ydf0809/ydf/board/evidence/report/fig3-2-mechanical.jpeg

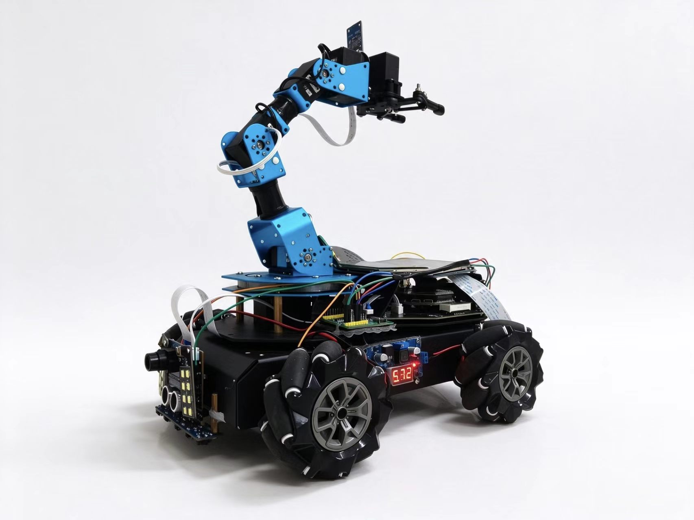
board/evidence/report/fig3-2-mechanical.jpeg
