ydf0809/ydf/board/evidence/report/fig3-9-locked.jpeg

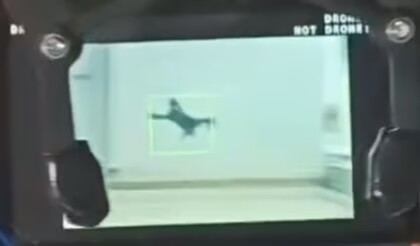
board/evidence/report/fig3-9-locked.jpeg
