ydf0809/ydf/report/owner_inputs.md

# 所有者输入与后续扩展

作者提供的最终设计报告 PDF 已按原文件纳入仓库。以下材料用于完善后续发布与扩展验证：

- 初级组/高级组信息。
- 板卡及外设的实物型号、版本、原理图、实际接线、供电和语音模块配置。
- 实板输入、预期输出、测试条件、原始日志或视频；正式报告已有部分结论，仓库按 board/measurements.md 记录可复核证据。
- 正式数据集、类别与授权、划分和去重、独立测试集、训练配置和实验指标。
- 模型参数和第三方源码的来源及可公开依据。
- 同工具、器件、约束和输入下的优化前后报告，以及吞吐、时延、功耗等原始测量。
- 发布已完成；后续更新继续使用普通本地提交和 GitHub 推送。

已有 25 条可见协作节选、纠错案例和工作流。后续可继续补充早期记录和更多应用场景。
