ydf0809/ydf/report/collaboration/README.md

# 大模型协作原文节选

来源索引和逐条定位见 [excerpts.json](excerpts.json)。仅收录用户提示词与模型对外答复；本地路径以方括号标签脱敏，历史链接在可读版禁用；JSON 保留脱敏后的消息文本。这里是原文节选，案例解释另见 [协作报告](../ai_collaboration.md)。历史参数和状态只适用于当时版本，不能替代当前验证。

## excerpt_01 · training

时间：2026-11-01T17:36:17.649Z；角色：user；会话：`01a1982d-0909-70f0-977c-afd3503c679e`；原记录第 11 行；模型：`gpt-6.1-sol`。

> 根据"[workspace]\new weight"反推出训练代码和权重转换脚本放到"[workspace]\jiaoben"

## excerpt_02 · training

时间：2026-11-01T17:37:33.516Z；角色：assistant；会话：`01a1982d-0909-70f0-977c-afd3503c679e`；原记录第 59 行；模型：`gpt-6.1-sol`。

> **可以重建兼容的训练代码和权重转换脚本，但无法仅凭权重恢复原始数据集、训练超参数和原始浮点权重。**

## excerpt_03 · training

时间：2026-11-01T17:40:01.609Z；角色：user；会话：`01a1982d-0909-70f0-977c-afd3503c679e`；原记录第 68 行；模型：`gpt-6.1-sol`。

> 我的工程是根据new weight建造的，为什么会出现不一致

## excerpt_04 · training

时间：2026-11-01T17:41:20.055Z；角色：assistant；会话：`01a1982d-0909-70f0-977c-afd3503c679e`；原记录第 107 行；模型：`gpt-6.1-sol`。

> **原因已经查清：`new weight` 文件夹内部的 COE 和 MEM 并不是同一套权重，当前工程使用的是其中 MEM 对应的数值。** 我上一条没有把这个关系说明清楚。

## excerpt_05 · weight_sync

时间：2026-11-02T15:48:31.650Z；角色：user；会话：`01a1982d-0909-70f0-977c-afd3503c679e`；原记录第 874 行；模型：`gpt-6.1-sol`。

> 如果对最终工程没有影响的话将最终工程目录里的 COE改为old weight

## excerpt_06 · weight_sync

时间：2026-11-02T16:03:49.712Z；角色：assistant；会话：`01a1982d-0909-70f0-977c-afd3503c679e`；原记录第 962 行；模型：`gpt-6.1-sol`。

> - 将最终工程中的 4 份 COE 替换为 `old weight/F` 对应文件。
> - 4 份 COE 与对应 MEM 已逐项一致。
> - 4 个权重 ROM 与 MEM 仍保持一致。
> - XPR、内嵌 ROM、MEM 和现有 bitstream 的 SHA-256 均未变化。
> - 已确认 XPR 和构建脚本没有登记或读取 COE，因此本次修改不会改变当前 FPGA 运行结果。

## excerpt_07 · locking

时间：2026-11-02T04:27:40.810Z；角色：user；会话：`01a197f0-307c-7972-940f-15799aa7c31f`；原记录第 338 行；模型：`gpt-6.1-sol`。

> 锁定时容易被亮色吸引走是为什么

## excerpt_08 · locking

时间：2026-11-02T04:30:03.903Z；角色：assistant；会话：`01a197f0-307c-7972-940f-15799aa7c31f`；原记录第 376 行；模型：`gpt-6.1-sol`。

> **主要原因是：当前定位器会选择“与背景反差最强的区域”，它没有约束必须继续跟随最初锁定的那个目标。** 我已用当前 RTL 的合成图样复现了亮块把框吸走的现象。

## excerpt_09 · locking

时间：2026-11-02T04:36:17.834Z；角色：user；会话：`01a197f0-307c-7972-940f-15799aa7c31f`；原记录第 415 行；模型：`gpt-6.1-sol`。

> 实施，另外我发现防空模式下再次说出防空模式，机械臂虽然会回到初始位但马上就会回到上次防空模式最后锁定的物体，我希望每次防空模式都重新搜寻

## excerpt_10 · locking

时间：2026-11-02T05:04:02.823Z；角色：assistant；会话：`01a197f0-307c-7972-940f-15799aa7c31f`；原记录第 757 行；模型：`gpt-6.1-sol`。

> - **定位抗干扰**：加入目标亮暗参考和连续 3 帧位置确认，优先选择原目标附近的候选；实际框移动限制为每帧每轴最多 16 个显示像素。
> - **每次防空都重新搜索**：包括已经处于防空模式时再次说“防空”。现在会清空旧锁定、定位参考、分类历史、未完成推理和待发送旧框，重新搜索并完成新的分类确认。
> - feifei 保锁、脱锁规则继续保留；下层工程未修改。

## excerpt_11 · corner_parameter

时间：2026-10-31T10:51:09.225Z；角色：user；会话：`01a19170-fd57-7fc3-93d8-67bca6108f44`；原记录第 333 行；模型：`gpt-6.1-sol`。

> 直行一秒再转，告诉我怎么改，我自己改，

## excerpt_12 · corner_parameter

时间：2026-10-31T10:51:36.473Z；角色：assistant；会话：`01a19170-fd57-7fc3-93d8-67bca6108f44`；原记录第 338 行；模型：`gpt-6.1-sol`。

> 只改这里即可，`corner_turn.v` 的默认值会被这里覆盖。保存后重新综合、实现、生成 bit 并烧录，修改才会在车上生效。

## excerpt_13 · corner_parameter

时间：2026-10-31T10:58:29.774Z；角色：user；会话：`01a19170-fd57-7fc3-93d8-67bca6108f44`；原记录第 345 行；模型：`gpt-6.1-sol`。

> 我需要xpr工程中的比特流为最新的，目前检测转弯后没有直行操作

## excerpt_14 · corner_parameter

时间：2026-10-31T11:00:12.365Z；角色：assistant；会话：`01a19170-fd57-7fc3-93d8-67bca6108f44`；原记录第 359 行；模型：`gpt-6.1-sol`。

> 已确认 1 秒设置未生效：`corner_turn.v` 默认值虽改为 1000，但 `xunbi_core.v` 仍传入 300，覆盖了它。我会修改实际实例，验证四轮先直行 1 秒，再重建原 XPR 的 bit。

## excerpt_15 · publication

时间：2026-11-01T18:11:00.904Z；角色：user；会话：`01a1984a-ec58-7082-8c9d-0bee8f996569`；原记录第 92 行；模型：`gpt-6.1-sol`。

> 别看审核稿重新做

## excerpt_16 · publication

时间：2026-11-01T18:18:33.674Z；角色：user；会话：`01a1984a-ec58-7082-8c9d-0bee8f996569`；原记录第 129 行；模型：`gpt-6.1-sol`。

> 1a 2a 3b

## excerpt_17 · publication

时间：2026-11-01T19:11:15.131Z；角色：assistant；会话：`01a1984a-ec58-7082-8c9d-0bee8f996569`；原记录第 755 行；模型：`gpt-6.1-sol`。

> 好的，暂时只保留本地提交 **`745a0bd`**，不推送 GitHub，也不再尝试登录。
>
> 工程位于 github_release/ydf（历史链接已脱敏），源码、脚本和验证记录均已保存。后续你明确说“继续发布”时再恢复。

## excerpt_18 · publication

时间：2026-11-02T14:52:53.686Z；角色：user；会话：`01a1984a-ec58-7082-8c9d-0bee8f996569`；原记录第 789 行；模型：`gpt-6.1-terra`。

> 以"[final_source]"中的两个文件为最终文件，"[workspace]\jiaoben"为scnn训练工程
> skill建议写踩坑清单，或者你有认为可取的也可以写
> 大模型协作记录：提示词、模型回答、自我纠错轨迹、智能体工作流设计如有
> 给出计划在修改

## excerpt_19 · publication

时间：2026-11-03T05:49:21.933Z；角色：user；会话：`01a1984a-ec58-7082-8c9d-0bee8f996569`；原记录第 1006 行；模型：`gpt-6.1-sol`。

> 根据"[selected_source]"中的内容继续完成任务

## excerpt_20 · implementation_details

时间：2026-11-03T05:49:17.423Z；角色：user；会话：`01a19ff4-64b1-7d61-911a-852116266ccf`；原记录第 11 行；模型：`gpt-6.1-terra`。

> 详细的各功能逻辑和所用的知识、实现方式，

## excerpt_21 · implementation_details

时间：2026-11-03T06:14:21.996Z；角色：assistant；会话：`01a19ff4-64b1-7d61-911a-852116266ccf`；原记录第 249 行；模型：`gpt-6.1-sol`。

> 包含 16 部分的功能逻辑、知识点、实现方式和验证范围，并附系统流程图。55 个源码及记录链接均采用相对路径，已检查有效。

## excerpt_22 · engineering_first

时间：2026-10-31T08:18:27.492Z；角色：user；会话：`01a17d82-b89c-7902-a480-8c6c298c51d9`；原记录第 3972 行；模型：`gpt-6.1-sol`。

> 以工程落地为优先，减少复核的程度，继续修改

## excerpt_23 · engineering_first

时间：2026-10-31T10:03:26.022Z；角色：assistant；会话：`01a17d82-b89c-7902-a480-8c6c298c51d9`；原记录第 4674 行；模型：`gpt-6.1-sol`。

> 本次下层板循迹修改已完成，原 XPR 对应的新 bit 已生成。五灯全亮/全灭：首个无效控制周期先停车；直角弯：转弯侧最外探头先离线、再检测到黑线，满足最小转弯时间后交回 PID。两项仿真均 PASS，综合、实现、bit 生成成功；尚未进行实车烧录测试。

## excerpt_24 · defense_control

时间：2026-11-02T03:08:30.959Z；角色：user；会话：`01a19a3a-db6a-7242-91ec-e8b890c20cb7`；原记录第 4 行；模型：未在来源 turn_context 中记录。

> 读取[workspace]/realfinal_min_102404与[workspace]/merged_cam_lcd_voice_scnn是我的主要工程。防空模式中再次说出防空模式时，机械臂需要回到初始位置；回位速度参考追随模式的自动复位；锁定无人机时，舵机6达到100和850阈值且目标接近左右边框30像素时，麦轮原地转向2秒。

## excerpt_25 · defense_control

时间：2026-11-02T03:08:30.989Z；角色：assistant；会话：`01a19a3a-db6a-7242-91ec-e8b890c20cb7`；原记录第 762 行；模型：未在来源 turn_context 中记录。

> 两块 bit 已重出，并且确认上层综合用的就是改后的代码：在实现后的网表里查 center_i 引脚数量为 0，说明旧的 center_i 端口已经不存在。
