ydf0809/ydf/report/publish_status.md

# 发布状态

2026-11-03：所有者已授权发布。仓库已推送到 `origin/main`；后续报告和文档更新继续使用普通本地提交与快进推送。

2026-11-04：最终双板工程完成同步与重建验证，作者最终设计报告 PDF 已按原文件纳入。报告正文中的阶段数据与仓库最终重建证据分别登记。

本地仓库使用原 main 分支并保留历史，沿用已有 MIT 与署名。当前内容以 xiegithub 最终源包为依据。

工程发布版可供审核和复现；板级原始数据、数据集评测和同条件优化对比通过后续材料持续扩展。
