ydf0809/ydf/third_party_notices.md

# 来源与许可范围

所有者于2026-11-02确认沿用本仓库已有MIT及署名；LICENSE保持远端原文。该确认针对本次指定工程的公开整理，不从其他草稿推导授权，也不删除原工程中的供应商权利声明。

| 内容 | 处理 |
| --- | --- |
| 两套主工程的RTL、约束、测试台、权重与参考帧 | 直接从指定主工程复制，来源和哈希见report/source_manifest.json；生产输入不改写 |
| XPR | 保留工具版权注释，调整交付路径、移除可选旧增量检查点引用 |
| AMD IP配置及生成内容 | 保留原有声明；由用户安装的Vivado生成运行文件，MIT不替代供应商适用条款 |
| Vivado、仿真器和运行时 | 不随仓库分发安装程序、许可证文件或凭据 |
| 新增脚本和文档 | 按根MIT协议提供 |
| SCNN训练与数据来源 | 已纳入配套训练与导出工具；数据集、训练过程和参数依据按data/model_card.md记录 |

若后续发现额外第三方许可要求，应保留相应文件及归属并补充适用路径。
