ydf0809/ydf/board/evidence/report/fig3-10-voice-module.jpeg

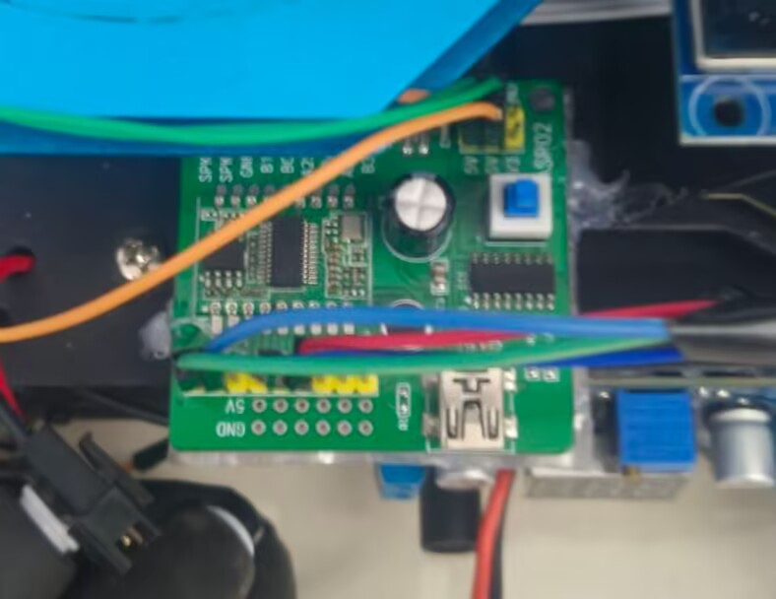
board/evidence/report/fig3-10-voice-module.jpeg
