ydf0809/ydf/board/pinmap.csv

board | port | package_pin | iostandard | source | line
upper | sys_clk | N18 | LVCMOS33 | projects/merged_cam_lcd_voice_scnn/constraints/top.xdc | 1
upper | sys_rst_n | W9 | LVCMOS33 | projects/merged_cam_lcd_voice_scnn/constraints/top.xdc | 2
upper | led | R19 | LVCMOS33 | projects/merged_cam_lcd_voice_scnn/constraints/top.xdc | 3
upper | cam_pclk | V15 | LVCMOS33 | projects/merged_cam_lcd_voice_scnn/constraints/top.xdc | 4
upper | cam_rst_n | V12 | LVCMOS33 | projects/merged_cam_lcd_voice_scnn/constraints/top.xdc | 5
upper | cam_pwdn | W16 | LVCMOS33 | projects/merged_cam_lcd_voice_scnn/constraints/top.xdc | 6
upper | cam_data[0] | W13 | LVCMOS33 | projects/merged_cam_lcd_voice_scnn/constraints/top.xdc | 7
upper | cam_data[1] | U13 | LVCMOS33 | projects/merged_cam_lcd_voice_scnn/constraints/top.xdc | 8
upper | cam_data[2] | V13 | LVCMOS33 | projects/merged_cam_lcd_voice_scnn/constraints/top.xdc | 9
upper | cam_data[3] | W14 | LVCMOS33 | projects/merged_cam_lcd_voice_scnn/constraints/top.xdc | 10
upper | cam_data[4] | Y14 | LVCMOS33 | projects/merged_cam_lcd_voice_scnn/constraints/top.xdc | 11
upper | cam_data[5] | D18 | LVCMOS33 | projects/merged_cam_lcd_voice_scnn/constraints/top.xdc | 12
upper | cam_data[6] | W15 | LVCMOS33 | projects/merged_cam_lcd_voice_scnn/constraints/top.xdc | 13
upper | cam_data[7] | F17 | LVCMOS33 | projects/merged_cam_lcd_voice_scnn/constraints/top.xdc | 14
upper | cam_vsync | T10 | LVCMOS33 | projects/merged_cam_lcd_voice_scnn/constraints/top.xdc | 15
upper | cam_href | T12 | LVCMOS33 | projects/merged_cam_lcd_voice_scnn/constraints/top.xdc | 16
upper | cam_scl | T11 | LVCMOS33 | projects/merged_cam_lcd_voice_scnn/constraints/top.xdc | 17
upper | cam_sda | U12 | LVCMOS33 | projects/merged_cam_lcd_voice_scnn/constraints/top.xdc | 18
upper | lcd_rgb[0] | U14 | LVCMOS33 | projects/merged_cam_lcd_voice_scnn/constraints/top.xdc | 19
upper | lcd_rgb[1] | U15 | LVCMOS33 | projects/merged_cam_lcd_voice_scnn/constraints/top.xdc | 20
upper | lcd_rgb[2] | T14 | LVCMOS33 | projects/merged_cam_lcd_voice_scnn/constraints/top.xdc | 21
upper | lcd_rgb[3] | T15 | LVCMOS33 | projects/merged_cam_lcd_voice_scnn/constraints/top.xdc | 22
upper | lcd_rgb[4] | T16 | LVCMOS33 | projects/merged_cam_lcd_voice_scnn/constraints/top.xdc | 23
upper | lcd_rgb[5] | U17 | LVCMOS33 | projects/merged_cam_lcd_voice_scnn/constraints/top.xdc | 24
upper | lcd_rgb[6] | V17 | LVCMOS33 | projects/merged_cam_lcd_voice_scnn/constraints/top.xdc | 25
upper | lcd_rgb[7] | V18 | LVCMOS33 | projects/merged_cam_lcd_voice_scnn/constraints/top.xdc | 26
upper | lcd_rgb[8] | K19 | LVCMOS33 | projects/merged_cam_lcd_voice_scnn/constraints/top.xdc | 27
upper | lcd_rgb[9] | J19 | LVCMOS33 | projects/merged_cam_lcd_voice_scnn/constraints/top.xdc | 28
upper | lcd_rgb[10] | H16 | LVCMOS33 | projects/merged_cam_lcd_voice_scnn/constraints/top.xdc | 29
upper | lcd_rgb[11] | H17 | LVCMOS33 | projects/merged_cam_lcd_voice_scnn/constraints/top.xdc | 30
upper | lcd_rgb[12] | G17 | LVCMOS33 | projects/merged_cam_lcd_voice_scnn/constraints/top.xdc | 31
upper | lcd_rgb[13] | G18 | LVCMOS33 | projects/merged_cam_lcd_voice_scnn/constraints/top.xdc | 32
upper | lcd_rgb[14] | G19 | LVCMOS33 | projects/merged_cam_lcd_voice_scnn/constraints/top.xdc | 33
upper | lcd_rgb[15] | G20 | LVCMOS33 | projects/merged_cam_lcd_voice_scnn/constraints/top.xdc | 34
upper | lcd_rgb[16] | N20 | LVCMOS33 | projects/merged_cam_lcd_voice_scnn/constraints/top.xdc | 35
upper | lcd_rgb[17] | P20 | LVCMOS33 | projects/merged_cam_lcd_voice_scnn/constraints/top.xdc | 36
upper | lcd_rgb[18] | M17 | LVCMOS33 | projects/merged_cam_lcd_voice_scnn/constraints/top.xdc | 37
upper | lcd_rgb[19] | M18 | LVCMOS33 | projects/merged_cam_lcd_voice_scnn/constraints/top.xdc | 38
upper | lcd_rgb[20] | M19 | LVCMOS33 | projects/merged_cam_lcd_voice_scnn/constraints/top.xdc | 39
upper | lcd_rgb[21] | M20 | LVCMOS33 | projects/merged_cam_lcd_voice_scnn/constraints/top.xdc | 40
upper | lcd_rgb[22] | L19 | LVCMOS33 | projects/merged_cam_lcd_voice_scnn/constraints/top.xdc | 41
upper | lcd_rgb[23] | L20 | LVCMOS33 | projects/merged_cam_lcd_voice_scnn/constraints/top.xdc | 42
upper | lcd_hs | U19 | LVCMOS33 | projects/merged_cam_lcd_voice_scnn/constraints/top.xdc | 43
upper | lcd_vs | T17 | LVCMOS33 | projects/merged_cam_lcd_voice_scnn/constraints/top.xdc | 44
upper | lcd_de | R18 | LVCMOS33 | projects/merged_cam_lcd_voice_scnn/constraints/top.xdc | 45
upper | lcd_bl | N17 | LVCMOS33 | projects/merged_cam_lcd_voice_scnn/constraints/top.xdc | 46
upper | lcd_clk | U18 | LVCMOS33 | projects/merged_cam_lcd_voice_scnn/constraints/top.xdc | 47
upper | lcd_rst | U20 | LVCMOS33 | projects/merged_cam_lcd_voice_scnn/constraints/top.xdc | 48
upper | asr_rxd | P18 | LVCMOS33 | projects/merged_cam_lcd_voice_scnn/constraints/top.xdc | 49
upper | asr_txd | T20 | LVCMOS33 | projects/merged_cam_lcd_voice_scnn/constraints/top.xdc | 50
upper | mode[0] | E17 | LVCMOS33 | projects/merged_cam_lcd_voice_scnn/constraints/top.xdc | 51
upper | mode[1] | E18 | LVCMOS33 | projects/merged_cam_lcd_voice_scnn/constraints/top.xdc | 52
upper | mode[2] | F16 | LVCMOS33 | projects/merged_cam_lcd_voice_scnn/constraints/top.xdc | 53
upper | mode_upd | E19 | LVCMOS33 | projects/merged_cam_lcd_voice_scnn/constraints/top.xdc | 54
upper | frame_err_flag | A20 | LVCMOS33 | projects/merged_cam_lcd_voice_scnn/constraints/top.xdc | 55
upper | link_tx | Y17 | LVCMOS33 | projects/merged_cam_lcd_voice_scnn/constraints/top.xdc | 56
upper | link_rx | V16 | LVCMOS33 | projects/merged_cam_lcd_voice_scnn/constraints/top.xdc | 57
upper | track_l2 | C20 | LVCMOS33 | projects/merged_cam_lcd_voice_scnn/constraints/top.xdc | 58
upper | track_l1 | D19 | LVCMOS33 | projects/merged_cam_lcd_voice_scnn/constraints/top.xdc | 59
upper | track_m | B19 | LVCMOS33 | projects/merged_cam_lcd_voice_scnn/constraints/top.xdc | 60
upper | track_r1 | B20 | LVCMOS33 | projects/merged_cam_lcd_voice_scnn/constraints/top.xdc | 61
upper | track_r2 | D20 | LVCMOS33 | projects/merged_cam_lcd_voice_scnn/constraints/top.xdc | 62
lower | sys_clk_pin | N18 | LVCMOS33 | projects/realfinal_min_102404/realfinal.srcs/constrs_1/new/10086.xdc | 67
lower | ov_pclk | Y16 | LVCMOS33 | projects/realfinal_min_102404/realfinal.srcs/constrs_1/new/10086.xdc | 95
lower | ov_data[7] | W14 | LVCMOS33 | projects/realfinal_min_102404/realfinal.srcs/constrs_1/new/10086.xdc | 58
lower | ov_data[6] | Y14 | LVCMOS33 | projects/realfinal_min_102404/realfinal.srcs/constrs_1/new/10086.xdc | 59
lower | ov_data[5] | U13 | LVCMOS33 | projects/realfinal_min_102404/realfinal.srcs/constrs_1/new/10086.xdc | 60
lower | ov_data[4] | V13 | LVCMOS33 | projects/realfinal_min_102404/realfinal.srcs/constrs_1/new/10086.xdc | 61
lower | ov_data[3] | V12 | LVCMOS33 | projects/realfinal_min_102404/realfinal.srcs/constrs_1/new/10086.xdc | 62
lower | ov_data[2] | W13 | LVCMOS33 | projects/realfinal_min_102404/realfinal.srcs/constrs_1/new/10086.xdc | 63
lower | ov_data[1] | T12 | LVCMOS33 | projects/realfinal_min_102404/realfinal.srcs/constrs_1/new/10086.xdc | 116
lower | ov_data[0] | U12 | LVCMOS33 | projects/realfinal_min_102404/realfinal.srcs/constrs_1/new/10086.xdc | 117
lower | arm_uart | U17 | LVCMOS33 | projects/realfinal_min_102404/realfinal.srcs/constrs_1/new/10086.xdc | 120
lower | lcd_clk | M19 | LVCMOS33 | projects/realfinal_min_102404/realfinal.srcs/constrs_1/new/10086.xdc | 71
lower | lcd_hs | M18 | LVCMOS33 | projects/realfinal_min_102404/realfinal.srcs/constrs_1/new/10086.xdc | 72
lower | lcd_vs | M17 | LVCMOS33 | projects/realfinal_min_102404/realfinal.srcs/constrs_1/new/10086.xdc | 73
lower | lcd_de | P20 | LVCMOS33 | projects/realfinal_min_102404/realfinal.srcs/constrs_1/new/10086.xdc | 74
lower | lcd_bl | N20 | LVCMOS33 | projects/realfinal_min_102404/realfinal.srcs/constrs_1/new/10086.xdc | 75
lower | lcd_rst | U20 | LVCMOS33 | projects/realfinal_min_102404/realfinal.srcs/constrs_1/new/10086.xdc | 76
lower | lcd_rgb[0] | H17 | LVCMOS33 | projects/realfinal_min_102404/realfinal.srcs/constrs_1/new/10086.xdc | 77
lower | lcd_rgb[1] | G17 | LVCMOS33 | projects/realfinal_min_102404/realfinal.srcs/constrs_1/new/10086.xdc | 78
lower | lcd_rgb[2] | J19 | LVCMOS33 | projects/realfinal_min_102404/realfinal.srcs/constrs_1/new/10086.xdc | 79
lower | lcd_rgb[3] | H16 | LVCMOS33 | projects/realfinal_min_102404/realfinal.srcs/constrs_1/new/10086.xdc | 80
lower | lcd_rgb[4] | L20 | LVCMOS33 | projects/realfinal_min_102404/realfinal.srcs/constrs_1/new/10086.xdc | 81
lower | lcd_rgb[5] | K19 | LVCMOS33 | projects/realfinal_min_102404/realfinal.srcs/constrs_1/new/10086.xdc | 111
lower | lcd_rgb[6] | M20 | LVCMOS33 | projects/realfinal_min_102404/realfinal.srcs/constrs_1/new/10086.xdc | 82
lower | lcd_rgb[7] | L19 | LVCMOS33 | projects/realfinal_min_102404/realfinal.srcs/constrs_1/new/10086.xdc | 83
lower | lcd_rgb[8] | E19 | LVCMOS33 | projects/realfinal_min_102404/realfinal.srcs/constrs_1/new/10086.xdc | 84
lower | lcd_rgb[9] | E18 | LVCMOS33 | projects/realfinal_min_102404/realfinal.srcs/constrs_1/new/10086.xdc | 85
lower | lcd_rgb[10] | A20 | LVCMOS33 | projects/realfinal_min_102404/realfinal.srcs/constrs_1/new/10086.xdc | 86
lower | lcd_rgb[11] | B19 | LVCMOS33 | projects/realfinal_min_102404/realfinal.srcs/constrs_1/new/10086.xdc | 112
lower | lcd_rgb[12] | B20 | LVCMOS33 | projects/realfinal_min_102404/realfinal.srcs/constrs_1/new/10086.xdc | 87
lower | lcd_rgb[13] | G20 | LVCMOS33 | projects/realfinal_min_102404/realfinal.srcs/constrs_1/new/10086.xdc | 88
lower | lcd_rgb[14] | G19 | LVCMOS33 | projects/realfinal_min_102404/realfinal.srcs/constrs_1/new/10086.xdc | 89
lower | lcd_rgb[15] | G18 | LVCMOS33 | projects/realfinal_min_102404/realfinal.srcs/constrs_1/new/10086.xdc | 113
lower | lcd_rgb[16] | T10 | LVCMOS33 | projects/realfinal_min_102404/realfinal.srcs/constrs_1/new/10086.xdc | 126
lower | lcd_rgb[17] | T11 | LVCMOS33 | projects/realfinal_min_102404/realfinal.srcs/constrs_1/new/10086.xdc | 127
lower | lcd_rgb[18] | G15 | LVCMOS33 | projects/realfinal_min_102404/realfinal.srcs/constrs_1/new/10086.xdc | 128
lower | lcd_rgb[19] | H15 | LVCMOS33 | projects/realfinal_min_102404/realfinal.srcs/constrs_1/new/10086.xdc | 129
lower | lcd_rgb[20] | F17 | LVCMOS33 | projects/realfinal_min_102404/realfinal.srcs/constrs_1/new/10086.xdc | 130
lower | lcd_rgb[21] | F16 | LVCMOS33 | projects/realfinal_min_102404/realfinal.srcs/constrs_1/new/10086.xdc | 131
lower | lcd_rgb[22] | D18 | LVCMOS33 | projects/realfinal_min_102404/realfinal.srcs/constrs_1/new/10086.xdc | 132
lower | lcd_rgb[23] | E17 | LVCMOS33 | projects/realfinal_min_102404/realfinal.srcs/constrs_1/new/10086.xdc | 133
lower | motor_scl | V17 | LVCMOS33 | projects/realfinal_min_102404/realfinal.srcs/constrs_1/new/10086.xdc | 114
lower | motor_sda | T16 | LVCMOS33 | projects/realfinal_min_102404/realfinal.srcs/constrs_1/new/10086.xdc | 115
lower | ov_href | V15 | LVCMOS33 | projects/realfinal_min_102404/realfinal.srcs/constrs_1/new/10086.xdc | 94
lower | ov_sio_c | V16 | LVCMOS33 | projects/realfinal_min_102404/realfinal.srcs/constrs_1/new/10086.xdc | 118
lower | ov_sio_d | W16 | LVCMOS33 | projects/realfinal_min_102404/realfinal.srcs/constrs_1/new/10086.xdc | 119
lower | ov_vsync | Y17 | LVCMOS33 | projects/realfinal_min_102404/realfinal.srcs/constrs_1/new/10086.xdc | 96
lower | ov_xclk | W15 | LVCMOS33 | projects/realfinal_min_102404/realfinal.srcs/constrs_1/new/10086.xdc | 97
lower | rst_n | W9 | LVCMOS33 | projects/realfinal_min_102404/realfinal.srcs/constrs_1/new/10086.xdc | 68
lower | tcon | T15 | LVCMOS33 | projects/realfinal_min_102404/realfinal.srcs/constrs_1/new/10086.xdc | 121
lower | us_echo | U15 | LVCMOS33 | projects/realfinal_min_102404/realfinal.srcs/constrs_1/new/10086.xdc | 122
lower | us_trig | U14 | LVCMOS33 | projects/realfinal_min_102404/realfinal.srcs/constrs_1/new/10086.xdc | 123
lower | link_rx | D20 | LVCMOS33 | projects/realfinal_min_102404/realfinal.srcs/constrs_1/new/10086.xdc | 145
lower | link_tx | F20 | LVCMOS33 | projects/realfinal_min_102404/realfinal.srcs/constrs_1/new/10086.xdc | 148
