ydf0809/ydf/report/source_release/upper/tests/tb_servo6_compat.txt

INFO: [VRFC 10-2263] Analyzing SystemVerilog file "[repository]/projects/merged_cam_lcd_voice_scnn/merged_cam_lcd_voice_scnn.srcs/sim_1/new/compat_support/compat_arm_red_track.v" into library work
INFO: [VRFC 10-311] analyzing module compat_arm_red_track
INFO: [VRFC 10-2263] Analyzing SystemVerilog file "[repository]/projects/merged_cam_lcd_voice_scnn/merged_cam_lcd_voice_scnn.srcs/sim_1/new/compat_support/compat_bus_servo_packet_tx.v" into library work
INFO: [VRFC 10-311] analyzing module compat_bus_servo_packet_tx
INFO: [VRFC 10-2263] Analyzing SystemVerilog file "[repository]/projects/merged_cam_lcd_voice_scnn/merged_cam_lcd_voice_scnn.srcs/sim_1/new/compat_support/compat_bus_servo_uart_tx.v" into library work
INFO: [VRFC 10-311] analyzing module compat_bus_servo_uart_tx
INFO: [VRFC 10-2263] Analyzing SystemVerilog file "[repository]/projects/merged_cam_lcd_voice_scnn/merged_cam_lcd_voice_scnn.srcs/sim_1/new/tb_servo6_compat.v" into library work
INFO: [VRFC 10-311] analyzing module tb_servo6_compat

Vivado Simulator v2026.1
Copyright 1986-2022 Xilinx, Inc. All Rights Reserved.
Copyright 2022-2026 Advanced Micro Devices, Inc. All Rights Reserved.
Running: D:/vivado2026.1/2026.1/Vivado/bin/unwrapped/win64.o/xelab.exe -L unisims_ver --timescale 1ns/1ps tb_servo6_compat -s upper_tb_servo6_compat 
Multi-threading is on. Using 14 slave threads.
Starting static elaboration
Pass Through NonSizing Optimizer
Completed static elaboration
Starting simulation data flow analysis
Completed simulation data flow analysis
Time Resolution for simulation is 1ps
Compiling module work.compat_bus_servo_uart_tx(CLK_HZ=...
Compiling module work.compat_bus_servo_packet_tx(CLK_H...
Compiling module work.compat_arm_red_track(BAUD=833333...
Compiling module work.tb_servo6_compat
Built simulation snapshot upper_tb_servo6_compat

****** xsim v2026.1 (64-bit)
  **** SW Build 6511674 on Tue Jun 16 11:02:23 MDT 2026
  **** IP Build 6504888 on Tue Jun 09 09:05:25 MDT 2026
  **** SharedData Build 6501428 on Mon Jun 08 17:34:18 MDT 2026
  **** Start of session at: Wed Nov  4 00:21:01 2026
    ** Copyright 1986-2022 Xilinx, Inc. All Rights Reserved.
    ** Copyright 2022-2026 Advanced Micro Devices, Inc. All Rights Reserved.

source xsim.dir/upper_tb_servo6_compat/xsim_script.tcl
# xsim {upper_tb_servo6_compat} -autoloadwcfg -tclbatch {run_all.tcl}
Time resolution is 1 ps
source run_all.tcl
## run all
SERVO6_COMPAT_TEST: PASS
$finish called at time : 2017890 ns : File "[repository]/projects/merged_cam_lcd_voice_scnn/merged_cam_lcd_voice_scnn.srcs/sim_1/new/tb_servo6_compat.v" Line 44
## quit
INFO: [Common 17-206] Exiting xsim at Wed Nov  4 00:21:03 2026...
