ydf0809/ydf/report/validation.md

# 验证结果

2026-11-04；源包 xiegithub；工程发布版。

## 1. RTL 仿真

Vivado/XSim 2026.1，23/23：上层 10/10、下层 13/13。最终源包测试为上层 10 项、下层 12 项；仓库补充 `tb_rgb2hsv_pipeline`，覆盖 HSV 流水线逐样本对照。输入及日志哈希见 [summary](../sim/results/summary.json)，`tb_arm_stop` 与 65536 样本 HSV 对照均通过。

[检查器自测](checker_tests.json) 11/11：覆盖成功、`FAIL`、`FATAL`、`ERROR`、非零失败计数、缺少完成标记、非零退出码，以及 XPR 文件存在、缺失与越界引用。

## 2. 主 XPR 构建

| 板 | WNS ns | WHS ns | DRC error | loops/no_clock/未约束内部端点 |
| --- | ---: | ---: | ---: | --- |
| 上层 | 5.815 | 0.017 | 0 | 均 0 |
| 下层 | 4.295 | 0.063 | 0 | 均 0 |

两板综合、布局布线及 write_bitstream 实际完成，输入哈希未变，发布 bit 匹配各自主 run。资源见 [resources](resources.csv)，完整证据见 [上层](../build/reports/upper/manifest.json)、[下层](../build/reports/lower/manifest.json)。

当前发布 SHA-256：

- 上层 top.bit：fa947a84887b1c5122325621bc08ea997ad6d7d87d38158eff5c40ea39677918
- 下层 super_top.bit：888f1b1bde28812eac15d66b3261173b01b25e737db220c3aca8278693f5977f

时序检查覆盖上层 18 输入/37 输出、下层 14 输入/35 输出以及时钟、复位、CDC、RAM 方法学报告；I/O delay 与板级外设时序由 board/measurements.md 的实板记录承接。

两板日志记录 Common 17-354 路径诊断，工具随后完成综合、实现和 write_bitstream，全部构建门限通过。诊断及上下文保存在各板 tool_diagnostics.txt 与 console.txt 中，供复现和排障复核。

## 3. 训练与部署

[数值记录](../training/scnn/verification/verification.json)：规范 COE/MEM、3416 参数往返、4 MEM 字节、异常输入、独立整数 50 步及移动目录通过。现用参数参考帧 [0,50]、黑帧 [0,0]，历史替代结果另记。

[合成训练](../training/scnn/verification/smoke_test.json)：2 样本、3 步，三个张量梯度/更新/导出通过。[5 ROM 语法](../training/scnn/verification/rom_compile.json)、[部署数值](weight_alignment.json) 通过。

训练验证覆盖定点数值、参数转换、部署数据和合成训练链；数据集准确率、场景泛化、连续帧和板级行为分别由独立评测记录承接。

## 4. 来源与复现

source_manifest.json 记录来源及适配，source_integrity.json 记录原源包核对。Git 索引树导出 ZIP 后解压到其他盘符的带空格路径，归档哈希、受检文件数、仿真 23/23、双板主 XPR 构建和交付检查结果见 [relocation](relocation.json)、[详细仿真](relocation_simulation.json) 和 [异路径仓库检查](repository_check_relocation.json)。

异路径重建和主工程构建分别记录各自主 run 的 SHA-256，`board/bitstreams/` 保留主 XPR 发布产物。迁移构建状态由 [delivery_check](delivery_check.json) 核对。

## 5. 板级测量入口

相机、语音、电机、机械臂、供电与动作成功率按 board/measurements.md 采集输入、预期结果、实际输出和原始证据。

## 6. 作者正式报告

作者最终报告书已提供 [修改后 DOCX](design_report/design_report_final.docx) 与 [导出 PDF](design_report/design_report_final.pdf)，共 49 页。DOCX SHA-256 为 `2cc5973231fa605a076ae7d063176d66984aaa252be21f52dbc8edd59a4daac3`，PDF SHA-256 为 `587df8e2b6998743c101a1122d34c9dde0652fa8954dc02fadecbf35fae6b1b3`。DOCX 与 PDF 均无批注或修订，PDF 无表单和 JavaScript，49 页均已渲染检查，无空白页或可见版面破损。作者报告快照与仓库最终主 XPR 重建证据分别在 [formal_report_source.json](design_report/formal_report_source.json) 中独立登记。

## 7. SCNN 训练部署技能

[scnn-training-pipeline](../skill/scnn-training-pipeline/SKILL.md) 已通过 skill 结构校验和参考工程检查。`--run` 实际执行了 `training/scnn/verify.py` 与 `train.py --smoke-test`：规范参数和参考参数均与独立 50 步整数模型一致，2 个合成样本的梯度、更新和检查点导出通过。记录见 [skill_validation.json](skill_validation.json)。

训练链检查覆盖训练工具、参数转换与定点数值链；识别性能与实板行为分别由数据集评测和板级测量记录承接。
