ydf0809/ydf/projects/merged_cam_lcd_voice_scnn/rtl/font_rom.v

//----------------------------------------------------------------------------------------
// File name:           font_rom
// Descriptions:        ASCII 点阵字模 ROM，给 lcd_cam_text 用（生成的，不要手改）
//
// 本文件由 tools/gen_font.py 生成，改字形请改脚本再重新生成，不要直接编辑这里。
// 生成参数：字体 consola.ttf  字号 23px  单元 16x24  超采样 x8
//           覆盖 ASCII 0x20~0x7E，每字符占 32 行（用到前 24 行）
// 生成时间：2026-10-10 20:21
//
// 取模约定：每行一个 16 位字，bit15 = 最左边的像素，bit0 = 最右边。
//           地址 = (字符码 - 0x20) * 32 + 行号，所以地址就是 7 位字符码拼 5 位行号。
// 读口是同步的（综合成 BRAM）：给地址的下一个时钟出数据。
// 这个 1 拍延迟和帧缓存 BRAM 的读延迟一样，所以 lcd_cam_text 里两边共用一个流水级。
//----------------------------------------------------------------------------------------
`timescale 1ns / 1ps

module font_rom(
    input  wire [11:0] addr,
    input  wire        clk ,
    output reg  [15:0] dout
);

reg [15:0] rom [0:4096-1];

initial begin
    rom[    0] = 16'h0000; rom[    1] = 16'h0000; rom[    2] = 16'h0000; rom[    3] = 16'h0000; rom[    4] = 16'h0000; rom[    5] = 16'h0000; rom[    6] = 16'h0000; rom[    7] = 16'h0000;
    rom[    8] = 16'h0000; rom[    9] = 16'h0000; rom[   10] = 16'h0000; rom[   11] = 16'h0000; rom[   12] = 16'h0000; rom[   13] = 16'h0000; rom[   14] = 16'h0000; rom[   15] = 16'h0000;
    rom[   16] = 16'h0000; rom[   17] = 16'h0000; rom[   18] = 16'h0000; rom[   19] = 16'h0000; rom[   20] = 16'h0000; rom[   21] = 16'h0000; rom[   22] = 16'h0000; rom[   23] = 16'h0000;
    rom[   24] = 16'h0000; rom[   25] = 16'h0000; rom[   26] = 16'h0000; rom[   27] = 16'h0000; rom[   28] = 16'h0000; rom[   29] = 16'h0000; rom[   30] = 16'h0000; rom[   31] = 16'h0000;
    rom[   32] = 16'h0000; rom[   33] = 16'h0000; rom[   34] = 16'h0000; rom[   35] = 16'h0180; rom[   36] = 16'h0180; rom[   37] = 16'h0180; rom[   38] = 16'h0180; rom[   39] = 16'h0180;
    rom[   40] = 16'h0180; rom[   41] = 16'h0180; rom[   42] = 16'h0180; rom[   43] = 16'h0180; rom[   44] = 16'h0180; rom[   45] = 16'h0180; rom[   46] = 16'h0000; rom[   47] = 16'h0000;
    rom[   48] = 16'h0180; rom[   49] = 16'h01c0; rom[   50] = 16'h0180; rom[   51] = 16'h0000; rom[   52] = 16'h0000; rom[   53] = 16'h0000; rom[   54] = 16'h0000; rom[   55] = 16'h0000;
    rom[   56] = 16'h0000; rom[   57] = 16'h0000; rom[   58] = 16'h0000; rom[   59] = 16'h0000; rom[   60] = 16'h0000; rom[   61] = 16'h0000; rom[   62] = 16'h0000; rom[   63] = 16'h0000;
    rom[   64] = 16'h0000; rom[   65] = 16'h0000; rom[   66] = 16'h0000; rom[   67] = 16'h0660; rom[   68] = 16'h0660; rom[   69] = 16'h0660; rom[   70] = 16'h0660; rom[   71] = 16'h0660;
    rom[   72] = 16'h0000; rom[   73] = 16'h0000; rom[   74] = 16'h0000; rom[   75] = 16'h0000; rom[   76] = 16'h0000; rom[   77] = 16'h0000; rom[   78] = 16'h0000; rom[   79] = 16'h0000;
    rom[   80] = 16'h0000; rom[   81] = 16'h0000; rom[   82] = 16'h0000; rom[   83] = 16'h0000; rom[   84] = 16'h0000; rom[   85] = 16'h0000; rom[   86] = 16'h0000; rom[   87] = 16'h0000;
    rom[   88] = 16'h0000; rom[   89] = 16'h0000; rom[   90] = 16'h0000; rom[   91] = 16'h0000; rom[   92] = 16'h0000; rom[   93] = 16'h0000; rom[   94] = 16'h0000; rom[   95] = 16'h0000;
    rom[   96] = 16'h0000; rom[   97] = 16'h0000; rom[   98] = 16'h0000; rom[   99] = 16'h0000; rom[  100] = 16'h0230; rom[  101] = 16'h0230; rom[  102] = 16'h0630; rom[  103] = 16'h0630;
    rom[  104] = 16'h1ffc; rom[  105] = 16'h0670; rom[  106] = 16'h0620; rom[  107] = 16'h0660; rom[  108] = 16'h0460; rom[  109] = 16'h3ff8; rom[  110] = 16'h3ff8; rom[  111] = 16'h0460;
    rom[  112] = 16'h0c60; rom[  113] = 16'h0c60; rom[  114] = 16'h0c40; rom[  115] = 16'h0000; rom[  116] = 16'h0000; rom[  117] = 16'h0000; rom[  118] = 16'h0000; rom[  119] = 16'h0000;
    rom[  120] = 16'h0000; rom[  121] = 16'h0000; rom[  122] = 16'h0000; rom[  123] = 16'h0000; rom[  124] = 16'h0000; rom[  125] = 16'h0000; rom[  126] = 16'h0000; rom[  127] = 16'h0000;
    rom[  128] = 16'h0000; rom[  129] = 16'h0000; rom[  130] = 16'h00c0; rom[  131] = 16'h00c0; rom[  132] = 16'h03e0; rom[  133] = 16'h0ff0; rom[  134] = 16'h0c80; rom[  135] = 16'h1880;
    rom[  136] = 16'h1880; rom[  137] = 16'h1d80; rom[  138] = 16'h0f80; rom[  139] = 16'h03e0; rom[  140] = 16'h01f0; rom[  141] = 16'h0138; rom[  142] = 16'h0118; rom[  143] = 16'h0118;
    rom[  144] = 16'h0338; rom[  145] = 16'h1ff0; rom[  146] = 16'h0fc0; rom[  147] = 16'h0300; rom[  148] = 16'h0300; rom[  149] = 16'h0000; rom[  150] = 16'h0000; rom[  151] = 16'h0000;
    rom[  152] = 16'h0000; rom[  153] = 16'h0000; rom[  154] = 16'h0000; rom[  155] = 16'h0000; rom[  156] = 16'h0000; rom[  157] = 16'h0000; rom[  158] = 16'h0000; rom[  159] = 16'h0000;
    rom[  160] = 16'h0000; rom[  161] = 16'h0000; rom[  162] = 16'h0000; rom[  163] = 16'h1e0c; rom[  164] = 16'h1318; rom[  165] = 16'h3310; rom[  166] = 16'h3130; rom[  167] = 16'h3360;
    rom[  168] = 16'h1e40; rom[  169] = 16'h00c0; rom[  170] = 16'h0180; rom[  171] = 16'h0180; rom[  172] = 16'h0330; rom[  173] = 16'h0678; rom[  174] = 16'h06cc; rom[  175] = 16'h0ccc;
    rom[  176] = 16'h18cc; rom[  177] = 16'h18f8; rom[  178] = 16'h3078; rom[  179] = 16'h0000; rom[  180] = 16'h0000; rom[  181] = 16'h0000; rom[  182] = 16'h0000; rom[  183] = 16'h0000;
    rom[  184] = 16'h0000; rom[  185] = 16'h0000; rom[  186] = 16'h0000; rom[  187] = 16'h0000; rom[  188] = 16'h0000; rom[  189] = 16'h0000; rom[  190] = 16'h0000; rom[  191] = 16'h0000;
    rom[  192] = 16'h0000; rom[  193] = 16'h0000; rom[  194] = 16'h0000; rom[  195] = 16'h0380; rom[  196] = 16'h07e0; rom[  197] = 16'h0c60; rom[  198] = 16'h0c60; rom[  199] = 16'h0c60;
    rom[  200] = 16'h0ce0; rom[  201] = 16'h07c0; rom[  202] = 16'h0700; rom[  203] = 16'h0f18; rom[  204] = 16'h1998; rom[  205] = 16'h18d8; rom[  206] = 16'h30f8; rom[  207] = 16'h3870;
    rom[  208] = 16'h1878; rom[  209] = 16'h1ff8; rom[  210] = 16'h078c; rom[  211] = 16'h0000; rom[  212] = 16'h0000; rom[  213] = 16'h0000; rom[  214] = 16'h0000; rom[  215] = 16'h0000;
    rom[  216] = 16'h0000; rom[  217] = 16'h0000; rom[  218] = 16'h0000; rom[  219] = 16'h0000; rom[  220] = 16'h0000; rom[  221] = 16'h0000; rom[  222] = 16'h0000; rom[  223] = 16'h0000;
    rom[  224] = 16'h0000; rom[  225] = 16'h0000; rom[  226] = 16'h0000; rom[  227] = 16'h0180; rom[  228] = 16'h0180; rom[  229] = 16'h0180; rom[  230] = 16'h0180; rom[  231] = 16'h0180;
    rom[  232] = 16'h0000; rom[  233] = 16'h0000; rom[  234] = 16'h0000; rom[  235] = 16'h0000; rom[  236] = 16'h0000; rom[  237] = 16'h0000; rom[  238] = 16'h0000; rom[  239] = 16'h0000;
    rom[  240] = 16'h0000; rom[  241] = 16'h0000; rom[  242] = 16'h0000; rom[  243] = 16'h0000; rom[  244] = 16'h0000; rom[  245] = 16'h0000; rom[  246] = 16'h0000; rom[  247] = 16'h0000;
    rom[  248] = 16'h0000; rom[  249] = 16'h0000; rom[  250] = 16'h0000; rom[  251] = 16'h0000; rom[  252] = 16'h0000; rom[  253] = 16'h0000; rom[  254] = 16'h0000; rom[  255] = 16'h0000;
    rom[  256] = 16'h0000; rom[  257] = 16'h0000; rom[  258] = 16'h0020; rom[  259] = 16'h0060; rom[  260] = 16'h00c0; rom[  261] = 16'h0180; rom[  262] = 16'h0180; rom[  263] = 16'h0300;
    rom[  264] = 16'h0300; rom[  265] = 16'h0300; rom[  266] = 16'h0600; rom[  267] = 16'h0600; rom[  268] = 16'h0600; rom[  269] = 16'h0600; rom[  270] = 16'h0600; rom[  271] = 16'h0600;
    rom[  272] = 16'h0300; rom[  273] = 16'h0300; rom[  274] = 16'h0380; rom[  275] = 16'h0180; rom[  276] = 16'h00c0; rom[  277] = 16'h00e0; rom[  278] = 16'h0060; rom[  279] = 16'h0000;
    rom[  280] = 16'h0000; rom[  281] = 16'h0000; rom[  282] = 16'h0000; rom[  283] = 16'h0000; rom[  284] = 16'h0000; rom[  285] = 16'h0000; rom[  286] = 16'h0000; rom[  287] = 16'h0000;
    rom[  288] = 16'h0000; rom[  289] = 16'h0000; rom[  290] = 16'h0400; rom[  291] = 16'h0600; rom[  292] = 16'h0300; rom[  293] = 16'h0180; rom[  294] = 16'h0180; rom[  295] = 16'h00c0;
    rom[  296] = 16'h00c0; rom[  297] = 16'h0060; rom[  298] = 16'h0060; rom[  299] = 16'h0060; rom[  300] = 16'h0060; rom[  301] = 16'h0060; rom[  302] = 16'h0060; rom[  303] = 16'h0060;
    rom[  304] = 16'h00c0; rom[  305] = 16'h00c0; rom[  306] = 16'h00c0; rom[  307] = 16'h0180; rom[  308] = 16'h0300; rom[  309] = 16'h0700; rom[  310] = 16'h0600; rom[  311] = 16'h0000;
    rom[  312] = 16'h0000; rom[  313] = 16'h0000; rom[  314] = 16'h0000; rom[  315] = 16'h0000; rom[  316] = 16'h0000; rom[  317] = 16'h0000; rom[  318] = 16'h0000; rom[  319] = 16'h0000;
    rom[  320] = 16'h0000; rom[  321] = 16'h0000; rom[  322] = 16'h0000; rom[  323] = 16'h0180; rom[  324] = 16'h0180; rom[  325] = 16'h0db0; rom[  326] = 16'h07f0; rom[  327] = 16'h03c0;
    rom[  328] = 16'h07e0; rom[  329] = 16'h0db0; rom[  330] = 16'h0180; rom[  331] = 16'h0180; rom[  332] = 16'h0000; rom[  333] = 16'h0000; rom[  334] = 16'h0000; rom[  335] = 16'h0000;
    rom[  336] = 16'h0000; rom[  337] = 16'h0000; rom[  338] = 16'h0000; rom[  339] = 16'h0000; rom[  340] = 16'h0000; rom[  341] = 16'h0000; rom[  342] = 16'h0000; rom[  343] = 16'h0000;
    rom[  344] = 16'h0000; rom[  345] = 16'h0000; rom[  346] = 16'h0000; rom[  347] = 16'h0000; rom[  348] = 16'h0000; rom[  349] = 16'h0000; rom[  350] = 16'h0000; rom[  351] = 16'h0000;
    rom[  352] = 16'h0000; rom[  353] = 16'h0000; rom[  354] = 16'h0000; rom[  355] = 16'h0000; rom[  356] = 16'h0000; rom[  357] = 16'h0000; rom[  358] = 16'h0000; rom[  359] = 16'h0180;
    rom[  360] = 16'h0180; rom[  361] = 16'h0180; rom[  362] = 16'h0180; rom[  363] = 16'h0180; rom[  364] = 16'h1ffc; rom[  365] = 16'h01c0; rom[  366] = 16'h0180; rom[  367] = 16'h0180;
    rom[  368] = 16'h0180; rom[  369] = 16'h0180; rom[  370] = 16'h0000; rom[  371] = 16'h0000; rom[  372] = 16'h0000; rom[  373] = 16'h0000; rom[  374] = 16'h0000; rom[  375] = 16'h0000;
    rom[  376] = 16'h0000; rom[  377] = 16'h0000; rom[  378] = 16'h0000; rom[  379] = 16'h0000; rom[  380] = 16'h0000; rom[  381] = 16'h0000; rom[  382] = 16'h0000; rom[  383] = 16'h0000;
    rom[  384] = 16'h0000; rom[  385] = 16'h0000; rom[  386] = 16'h0000; rom[  387] = 16'h0000; rom[  388] = 16'h0000; rom[  389] = 16'h0000; rom[  390] = 16'h0000; rom[  391] = 16'h0000;
    rom[  392] = 16'h0000; rom[  393] = 16'h0000; rom[  394] = 16'h0000; rom[  395] = 16'h0000; rom[  396] = 16'h0000; rom[  397] = 16'h0000; rom[  398] = 16'h0000; rom[  399] = 16'h0180;
    rom[  400] = 16'h03c0; rom[  401] = 16'h01c0; rom[  402] = 16'h01c0; rom[  403] = 16'h01c0; rom[  404] = 16'h0180; rom[  405] = 16'h0f00; rom[  406] = 16'h0400; rom[  407] = 16'h0000;
    rom[  408] = 16'h0000; rom[  409] = 16'h0000; rom[  410] = 16'h0000; rom[  411] = 16'h0000; rom[  412] = 16'h0000; rom[  413] = 16'h0000; rom[  414] = 16'h0000; rom[  415] = 16'h0000;
    rom[  416] = 16'h0000; rom[  417] = 16'h0000; rom[  418] = 16'h0000; rom[  419] = 16'h0000; rom[  420] = 16'h0000; rom[  421] = 16'h0000; rom[  422] = 16'h0000; rom[  423] = 16'h0000;
    rom[  424] = 16'h0000; rom[  425] = 16'h0000; rom[  426] = 16'h0000; rom[  427] = 16'h0000; rom[  428] = 16'h07e0; rom[  429] = 16'h0000; rom[  430] = 16'h0000; rom[  431] = 16'h0000;
    rom[  432] = 16'h0000; rom[  433] = 16'h0000; rom[  434] = 16'h0000; rom[  435] = 16'h0000; rom[  436] = 16'h0000; rom[  437] = 16'h0000; rom[  438] = 16'h0000; rom[  439] = 16'h0000;
    rom[  440] = 16'h0000; rom[  441] = 16'h0000; rom[  442] = 16'h0000; rom[  443] = 16'h0000; rom[  444] = 16'h0000; rom[  445] = 16'h0000; rom[  446] = 16'h0000; rom[  447] = 16'h0000;
    rom[  448] = 16'h0000; rom[  449] = 16'h0000; rom[  450] = 16'h0000; rom[  451] = 16'h0000; rom[  452] = 16'h0000; rom[  453] = 16'h0000; rom[  454] = 16'h0000; rom[  455] = 16'h0000;
    rom[  456] = 16'h0000; rom[  457] = 16'h0000; rom[  458] = 16'h0000; rom[  459] = 16'h0000; rom[  460] = 16'h0000; rom[  461] = 16'h0000; rom[  462] = 16'h0000; rom[  463] = 16'h0180;
    rom[  464] = 16'h03c0; rom[  465] = 16'h03c0; rom[  466] = 16'h0180; rom[  467] = 16'h0000; rom[  468] = 16'h0000; rom[  469] = 16'h0000; rom[  470] = 16'h0000; rom[  471] = 16'h0000;
    rom[  472] = 16'h0000; rom[  473] = 16'h0000; rom[  474] = 16'h0000; rom[  475] = 16'h0000; rom[  476] = 16'h0000; rom[  477] = 16'h0000; rom[  478] = 16'h0000; rom[  479] = 16'h0000;
    rom[  480] = 16'h0000; rom[  481] = 16'h0000; rom[  482] = 16'h0000; rom[  483] = 16'h0010; rom[  484] = 16'h0030; rom[  485] = 16'h0020; rom[  486] = 16'h0060; rom[  487] = 16'h0060;
    rom[  488] = 16'h00c0; rom[  489] = 16'h00c0; rom[  490] = 16'h0080; rom[  491] = 16'h0180; rom[  492] = 16'h0180; rom[  493] = 16'h0300; rom[  494] = 16'h0300; rom[  495] = 16'h0600;
    rom[  496] = 16'h0600; rom[  497] = 16'h0400; rom[  498] = 16'h0c00; rom[  499] = 16'h0c00; rom[  500] = 16'h1800; rom[  501] = 16'h0000; rom[  502] = 16'h0000; rom[  503] = 16'h0000;
    rom[  504] = 16'h0000; rom[  505] = 16'h0000; rom[  506] = 16'h0000; rom[  507] = 16'h0000; rom[  508] = 16'h0000; rom[  509] = 16'h0000; rom[  510] = 16'h0000; rom[  511] = 16'h0000;
    rom[  512] = 16'h0000; rom[  513] = 16'h0000; rom[  514] = 16'h0000; rom[  515] = 16'h0000; rom[  516] = 16'h03e0; rom[  517] = 16'h0ff0; rom[  518] = 16'h0c30; rom[  519] = 16'h1818;
    rom[  520] = 16'h1838; rom[  521] = 16'h1878; rom[  522] = 16'h18f8; rom[  523] = 16'h1b98; rom[  524] = 16'h1f18; rom[  525] = 16'h1e18; rom[  526] = 16'h1818; rom[  527] = 16'h1818;
    rom[  528] = 16'h0c30; rom[  529] = 16'h0ff0; rom[  530] = 16'h03c0; rom[  531] = 16'h0000; rom[  532] = 16'h0000; rom[  533] = 16'h0000; rom[  534] = 16'h0000; rom[  535] = 16'h0000;
    rom[  536] = 16'h0000; rom[  537] = 16'h0000; rom[  538] = 16'h0000; rom[  539] = 16'h0000; rom[  540] = 16'h0000; rom[  541] = 16'h0000; rom[  542] = 16'h0000; rom[  543] = 16'h0000;
    rom[  544] = 16'h0000; rom[  545] = 16'h0000; rom[  546] = 16'h0000; rom[  547] = 16'h0000; rom[  548] = 16'h01c0; rom[  549] = 16'h07c0; rom[  550] = 16'h0fc0; rom[  551] = 16'h08c0;
    rom[  552] = 16'h00c0; rom[  553] = 16'h00c0; rom[  554] = 16'h00c0; rom[  555] = 16'h00c0; rom[  556] = 16'h00c0; rom[  557] = 16'h00c0; rom[  558] = 16'h00c0; rom[  559] = 16'h00c0;
    rom[  560] = 16'h01c0; rom[  561] = 16'h0ff8; rom[  562] = 16'h0ff8; rom[  563] = 16'h0000; rom[  564] = 16'h0000; rom[  565] = 16'h0000; rom[  566] = 16'h0000; rom[  567] = 16'h0000;
    rom[  568] = 16'h0000; rom[  569] = 16'h0000; rom[  570] = 16'h0000; rom[  571] = 16'h0000; rom[  572] = 16'h0000; rom[  573] = 16'h0000; rom[  574] = 16'h0000; rom[  575] = 16'h0000;
    rom[  576] = 16'h0000; rom[  577] = 16'h0000; rom[  578] = 16'h0000; rom[  579] = 16'h0000; rom[  580] = 16'h07c0; rom[  581] = 16'h0fe0; rom[  582] = 16'h0830; rom[  583] = 16'h0030;
    rom[  584] = 16'h0030; rom[  585] = 16'h0030; rom[  586] = 16'h0030; rom[  587] = 16'h0060; rom[  588] = 16'h00c0; rom[  589] = 16'h0180; rom[  590] = 16'h0300; rom[  591] = 16'h0600;
    rom[  592] = 16'h0c00; rom[  593] = 16'h1ff8; rom[  594] = 16'h0ff8; rom[  595] = 16'h0000; rom[  596] = 16'h0000; rom[  597] = 16'h0000; rom[  598] = 16'h0000; rom[  599] = 16'h0000;
    rom[  600] = 16'h0000; rom[  601] = 16'h0000; rom[  602] = 16'h0000; rom[  603] = 16'h0000; rom[  604] = 16'h0000; rom[  605] = 16'h0000; rom[  606] = 16'h0000; rom[  607] = 16'h0000;
    rom[  608] = 16'h0000; rom[  609] = 16'h0000; rom[  610] = 16'h0000; rom[  611] = 16'h0000; rom[  612] = 16'h0fc0; rom[  613] = 16'h0fe0; rom[  614] = 16'h0030; rom[  615] = 16'h0030;
    rom[  616] = 16'h0030; rom[  617] = 16'h0060; rom[  618] = 16'h03c0; rom[  619] = 16'h07e0; rom[  620] = 16'h0070; rom[  621] = 16'h0018; rom[  622] = 16'h0018; rom[  623] = 16'h0018;
    rom[  624] = 16'h0030; rom[  625] = 16'h0fe0; rom[  626] = 16'h0fc0; rom[  627] = 16'h0000; rom[  628] = 16'h0000; rom[  629] = 16'h0000; rom[  630] = 16'h0000; rom[  631] = 16'h0000;
    rom[  632] = 16'h0000; rom[  633] = 16'h0000; rom[  634] = 16'h0000; rom[  635] = 16'h0000; rom[  636] = 16'h0000; rom[  637] = 16'h0000; rom[  638] = 16'h0000; rom[  639] = 16'h0000;
    rom[  640] = 16'h0000; rom[  641] = 16'h0000; rom[  642] = 16'h0000; rom[  643] = 16'h0000; rom[  644] = 16'h00e0; rom[  645] = 16'h00e0; rom[  646] = 16'h01e0; rom[  647] = 16'h0360;
    rom[  648] = 16'h0360; rom[  649] = 16'h0660; rom[  650] = 16'h0c60; rom[  651] = 16'h0c60; rom[  652] = 16'h1860; rom[  653] = 16'h3860; rom[  654] = 16'h3ffc; rom[  655] = 16'h0070;
    rom[  656] = 16'h0060; rom[  657] = 16'h0060; rom[  658] = 16'h0060; rom[  659] = 16'h0000; rom[  660] = 16'h0000; rom[  661] = 16'h0000; rom[  662] = 16'h0000; rom[  663] = 16'h0000;
    rom[  664] = 16'h0000; rom[  665] = 16'h0000; rom[  666] = 16'h0000; rom[  667] = 16'h0000; rom[  668] = 16'h0000; rom[  669] = 16'h0000; rom[  670] = 16'h0000; rom[  671] = 16'h0000;
    rom[  672] = 16'h0000; rom[  673] = 16'h0000; rom[  674] = 16'h0000; rom[  675] = 16'h0000; rom[  676] = 16'h0ff0; rom[  677] = 16'h0ff0; rom[  678] = 16'h0c00; rom[  679] = 16'h0c00;
    rom[  680] = 16'h0c00; rom[  681] = 16'h0c00; rom[  682] = 16'h0fc0; rom[  683] = 16'h0ff0; rom[  684] = 16'h0030; rom[  685] = 16'h0018; rom[  686] = 16'h0018; rom[  687] = 16'h0030;
    rom[  688] = 16'h0030; rom[  689] = 16'h0fe0; rom[  690] = 16'h0f80; rom[  691] = 16'h0000; rom[  692] = 16'h0000; rom[  693] = 16'h0000; rom[  694] = 16'h0000; rom[  695] = 16'h0000;
    rom[  696] = 16'h0000; rom[  697] = 16'h0000; rom[  698] = 16'h0000; rom[  699] = 16'h0000; rom[  700] = 16'h0000; rom[  701] = 16'h0000; rom[  702] = 16'h0000; rom[  703] = 16'h0000;
    rom[  704] = 16'h0000; rom[  705] = 16'h0000; rom[  706] = 16'h0000; rom[  707] = 16'h0000; rom[  708] = 16'h00f0; rom[  709] = 16'h03f0; rom[  710] = 16'h0600; rom[  711] = 16'h0c00;
    rom[  712] = 16'h0c00; rom[  713] = 16'h1800; rom[  714] = 16'h1ff0; rom[  715] = 16'h1e78; rom[  716] = 16'h1818; rom[  717] = 16'h1818; rom[  718] = 16'h1818; rom[  719] = 16'h0c18;
    rom[  720] = 16'h0c38; rom[  721] = 16'h07f0; rom[  722] = 16'h03c0; rom[  723] = 16'h0000; rom[  724] = 16'h0000; rom[  725] = 16'h0000; rom[  726] = 16'h0000; rom[  727] = 16'h0000;
    rom[  728] = 16'h0000; rom[  729] = 16'h0000; rom[  730] = 16'h0000; rom[  731] = 16'h0000; rom[  732] = 16'h0000; rom[  733] = 16'h0000; rom[  734] = 16'h0000; rom[  735] = 16'h0000;
    rom[  736] = 16'h0000; rom[  737] = 16'h0000; rom[  738] = 16'h0000; rom[  739] = 16'h0000; rom[  740] = 16'h1ff8; rom[  741] = 16'h1ff8; rom[  742] = 16'h0018; rom[  743] = 16'h0030;
    rom[  744] = 16'h0030; rom[  745] = 16'h0060; rom[  746] = 16'h0060; rom[  747] = 16'h00c0; rom[  748] = 16'h00c0; rom[  749] = 16'h0180; rom[  750] = 16'h0180; rom[  751] = 16'h0300;
    rom[  752] = 16'h0300; rom[  753] = 16'h0600; rom[  754] = 16'h0600; rom[  755] = 16'h0000; rom[  756] = 16'h0000; rom[  757] = 16'h0000; rom[  758] = 16'h0000; rom[  759] = 16'h0000;
    rom[  760] = 16'h0000; rom[  761] = 16'h0000; rom[  762] = 16'h0000; rom[  763] = 16'h0000; rom[  764] = 16'h0000; rom[  765] = 16'h0000; rom[  766] = 16'h0000; rom[  767] = 16'h0000;
    rom[  768] = 16'h0000; rom[  769] = 16'h0000; rom[  770] = 16'h0000; rom[  771] = 16'h0000; rom[  772] = 16'h07e0; rom[  773] = 16'h0ff0; rom[  774] = 16'h0c38; rom[  775] = 16'h1818;
    rom[  776] = 16'h0c38; rom[  777] = 16'h0e30; rom[  778] = 16'h07e0; rom[  779] = 16'h03e0; rom[  780] = 16'h0e70; rom[  781] = 16'h0c38; rom[  782] = 16'h1818; rom[  783] = 16'h1818;
    rom[  784] = 16'h1c38; rom[  785] = 16'h0ff0; rom[  786] = 16'h07e0; rom[  787] = 16'h0000; rom[  788] = 16'h0000; rom[  789] = 16'h0000; rom[  790] = 16'h0000; rom[  791] = 16'h0000;
    rom[  792] = 16'h0000; rom[  793] = 16'h0000; rom[  794] = 16'h0000; rom[  795] = 16'h0000; rom[  796] = 16'h0000; rom[  797] = 16'h0000; rom[  798] = 16'h0000; rom[  799] = 16'h0000;
    rom[  800] = 16'h0000; rom[  801] = 16'h0000; rom[  802] = 16'h0000; rom[  803] = 16'h0000; rom[  804] = 16'h07c0; rom[  805] = 16'h0ff0; rom[  806] = 16'h1c30; rom[  807] = 16'h1818;
    rom[  808] = 16'h1818; rom[  809] = 16'h1818; rom[  810] = 16'h1818; rom[  811] = 16'h0ef8; rom[  812] = 16'h07f8; rom[  813] = 16'h0018; rom[  814] = 16'h0030; rom[  815] = 16'h0030;
    rom[  816] = 16'h00e0; rom[  817] = 16'h0fc0; rom[  818] = 16'h0f00; rom[  819] = 16'h0000; rom[  820] = 16'h0000; rom[  821] = 16'h0000; rom[  822] = 16'h0000; rom[  823] = 16'h0000;
    rom[  824] = 16'h0000; rom[  825] = 16'h0000; rom[  826] = 16'h0000; rom[  827] = 16'h0000; rom[  828] = 16'h0000; rom[  829] = 16'h0000; rom[  830] = 16'h0000; rom[  831] = 16'h0000;
    rom[  832] = 16'h0000; rom[  833] = 16'h0000; rom[  834] = 16'h0000; rom[  835] = 16'h0000; rom[  836] = 16'h0000; rom[  837] = 16'h0000; rom[  838] = 16'h0000; rom[  839] = 16'h0180;
    rom[  840] = 16'h03c0; rom[  841] = 16'h03c0; rom[  842] = 16'h0180; rom[  843] = 16'h0000; rom[  844] = 16'h0000; rom[  845] = 16'h0000; rom[  846] = 16'h0000; rom[  847] = 16'h0000;
    rom[  848] = 16'h01c0; rom[  849] = 16'h03c0; rom[  850] = 16'h0180; rom[  851] = 16'h0000; rom[  852] = 16'h0000; rom[  853] = 16'h0000; rom[  854] = 16'h0000; rom[  855] = 16'h0000;
    rom[  856] = 16'h0000; rom[  857] = 16'h0000; rom[  858] = 16'h0000; rom[  859] = 16'h0000; rom[  860] = 16'h0000; rom[  861] = 16'h0000; rom[  862] = 16'h0000; rom[  863] = 16'h0000;
    rom[  864] = 16'h0000; rom[  865] = 16'h0000; rom[  866] = 16'h0000; rom[  867] = 16'h0000; rom[  868] = 16'h0000; rom[  869] = 16'h0000; rom[  870] = 16'h0000; rom[  871] = 16'h0180;
    rom[  872] = 16'h03c0; rom[  873] = 16'h03c0; rom[  874] = 16'h0180; rom[  875] = 16'h0000; rom[  876] = 16'h0000; rom[  877] = 16'h0000; rom[  878] = 16'h0000; rom[  879] = 16'h0180;
    rom[  880] = 16'h03c0; rom[  881] = 16'h01c0; rom[  882] = 16'h01c0; rom[  883] = 16'h00c0; rom[  884] = 16'h0180; rom[  885] = 16'h0700; rom[  886] = 16'h0400; rom[  887] = 16'h0000;
    rom[  888] = 16'h0000; rom[  889] = 16'h0000; rom[  890] = 16'h0000; rom[  891] = 16'h0000; rom[  892] = 16'h0000; rom[  893] = 16'h0000; rom[  894] = 16'h0000; rom[  895] = 16'h0000;
    rom[  896] = 16'h0000; rom[  897] = 16'h0000; rom[  898] = 16'h0000; rom[  899] = 16'h0000; rom[  900] = 16'h0000; rom[  901] = 16'h0000; rom[  902] = 16'h0000; rom[  903] = 16'h0030;
    rom[  904] = 16'h00e0; rom[  905] = 16'h01c0; rom[  906] = 16'h0380; rom[  907] = 16'h0600; rom[  908] = 16'h0c00; rom[  909] = 16'h0e00; rom[  910] = 16'h0700; rom[  911] = 16'h0180;
    rom[  912] = 16'h00e0; rom[  913] = 16'h0070; rom[  914] = 16'h0020; rom[  915] = 16'h0000; rom[  916] = 16'h0000; rom[  917] = 16'h0000; rom[  918] = 16'h0000; rom[  919] = 16'h0000;
    rom[  920] = 16'h0000; rom[  921] = 16'h0000; rom[  922] = 16'h0000; rom[  923] = 16'h0000; rom[  924] = 16'h0000; rom[  925] = 16'h0000; rom[  926] = 16'h0000; rom[  927] = 16'h0000;
    rom[  928] = 16'h0000; rom[  929] = 16'h0000; rom[  930] = 16'h0000; rom[  931] = 16'h0000; rom[  932] = 16'h0000; rom[  933] = 16'h0000; rom[  934] = 16'h0000; rom[  935] = 16'h0000;
    rom[  936] = 16'h0000; rom[  937] = 16'h0000; rom[  938] = 16'h1ff8; rom[  939] = 16'h0ff0; rom[  940] = 16'h0000; rom[  941] = 16'h0000; rom[  942] = 16'h1ff8; rom[  943] = 16'h0000;
    rom[  944] = 16'h0000; rom[  945] = 16'h0000; rom[  946] = 16'h0000; rom[  947] = 16'h0000; rom[  948] = 16'h0000; rom[  949] = 16'h0000; rom[  950] = 16'h0000; rom[  951] = 16'h0000;
    rom[  952] = 16'h0000; rom[  953] = 16'h0000; rom[  954] = 16'h0000; rom[  955] = 16'h0000; rom[  956] = 16'h0000; rom[  957] = 16'h0000; rom[  958] = 16'h0000; rom[  959] = 16'h0000;
    rom[  960] = 16'h0000; rom[  961] = 16'h0000; rom[  962] = 16'h0000; rom[  963] = 16'h0000; rom[  964] = 16'h0000; rom[  965] = 16'h0000; rom[  966] = 16'h0000; rom[  967] = 16'h0e00;
    rom[  968] = 16'h0700; rom[  969] = 16'h0380; rom[  970] = 16'h00c0; rom[  971] = 16'h0060; rom[  972] = 16'h0038; rom[  973] = 16'h0070; rom[  974] = 16'h00e0; rom[  975] = 16'h0180;
    rom[  976] = 16'h0300; rom[  977] = 16'h0e00; rom[  978] = 16'h0400; rom[  979] = 16'h0000; rom[  980] = 16'h0000; rom[  981] = 16'h0000; rom[  982] = 16'h0000; rom[  983] = 16'h0000;
    rom[  984] = 16'h0000; rom[  985] = 16'h0000; rom[  986] = 16'h0000; rom[  987] = 16'h0000; rom[  988] = 16'h0000; rom[  989] = 16'h0000; rom[  990] = 16'h0000; rom[  991] = 16'h0000;
    rom[  992] = 16'h0000; rom[  993] = 16'h0000; rom[  994] = 16'h0000; rom[  995] = 16'h0780; rom[  996] = 16'h07c0; rom[  997] = 16'h0060; rom[  998] = 16'h0030; rom[  999] = 16'h0030;
    rom[ 1000] = 16'h0030; rom[ 1001] = 16'h0070; rom[ 1002] = 16'h03e0; rom[ 1003] = 16'h0380; rom[ 1004] = 16'h0300; rom[ 1005] = 16'h0300; rom[ 1006] = 16'h0100; rom[ 1007] = 16'h0000;
    rom[ 1008] = 16'h0300; rom[ 1009] = 16'h0380; rom[ 1010] = 16'h0300; rom[ 1011] = 16'h0000; rom[ 1012] = 16'h0000; rom[ 1013] = 16'h0000; rom[ 1014] = 16'h0000; rom[ 1015] = 16'h0000;
    rom[ 1016] = 16'h0000; rom[ 1017] = 16'h0000; rom[ 1018] = 16'h0000; rom[ 1019] = 16'h0000; rom[ 1020] = 16'h0000; rom[ 1021] = 16'h0000; rom[ 1022] = 16'h0000; rom[ 1023] = 16'h0000;
    rom[ 1024] = 16'h0000; rom[ 1025] = 16'h0000; rom[ 1026] = 16'h0000; rom[ 1027] = 16'h03f0; rom[ 1028] = 16'h0738; rom[ 1029] = 16'h0c08; rom[ 1030] = 16'h0c0c; rom[ 1031] = 16'h180c;
    rom[ 1032] = 16'h1884; rom[ 1033] = 16'h13e4; rom[ 1034] = 16'h3364; rom[ 1035] = 16'h3664; rom[ 1036] = 16'h3664; rom[ 1037] = 16'h2664; rom[ 1038] = 16'h264c; rom[ 1039] = 16'h26cc;
    rom[ 1040] = 16'h36f8; rom[ 1041] = 16'h3330; rom[ 1042] = 16'h3000; rom[ 1043] = 16'h3000; rom[ 1044] = 16'h1800; rom[ 1045] = 16'h1c00; rom[ 1046] = 16'h0fe0; rom[ 1047] = 16'h0100;
    rom[ 1048] = 16'h0000; rom[ 1049] = 16'h0000; rom[ 1050] = 16'h0000; rom[ 1051] = 16'h0000; rom[ 1052] = 16'h0000; rom[ 1053] = 16'h0000; rom[ 1054] = 16'h0000; rom[ 1055] = 16'h0000;
    rom[ 1056] = 16'h0000; rom[ 1057] = 16'h0000; rom[ 1058] = 16'h0000; rom[ 1059] = 16'h0000; rom[ 1060] = 16'h01c0; rom[ 1061] = 16'h03c0; rom[ 1062] = 16'h03c0; rom[ 1063] = 16'h0260;
    rom[ 1064] = 16'h0660; rom[ 1065] = 16'h0660; rom[ 1066] = 16'h0670; rom[ 1067] = 16'h0c30; rom[ 1068] = 16'h0c30; rom[ 1069] = 16'h0c38; rom[ 1070] = 16'h1ff8; rom[ 1071] = 16'h1c18;
    rom[ 1072] = 16'h181c; rom[ 1073] = 16'h300c; rom[ 1074] = 16'h300c; rom[ 1075] = 16'h0000; rom[ 1076] = 16'h0000; rom[ 1077] = 16'h0000; rom[ 1078] = 16'h0000; rom[ 1079] = 16'h0000;
    rom[ 1080] = 16'h0000; rom[ 1081] = 16'h0000; rom[ 1082] = 16'h0000; rom[ 1083] = 16'h0000; rom[ 1084] = 16'h0000; rom[ 1085] = 16'h0000; rom[ 1086] = 16'h0000; rom[ 1087] = 16'h0000;
    rom[ 1088] = 16'h0000; rom[ 1089] = 16'h0000; rom[ 1090] = 16'h0000; rom[ 1091] = 16'h0000; rom[ 1092] = 16'h0fc0; rom[ 1093] = 16'h0ff0; rom[ 1094] = 16'h0830; rom[ 1095] = 16'h0c18;
    rom[ 1096] = 16'h0c18; rom[ 1097] = 16'h0830; rom[ 1098] = 16'h0fe0; rom[ 1099] = 16'h0ff0; rom[ 1100] = 16'h0c38; rom[ 1101] = 16'h0818; rom[ 1102] = 16'h0c18; rom[ 1103] = 16'h0c18;
    rom[ 1104] = 16'h0c38; rom[ 1105] = 16'h0ff0; rom[ 1106] = 16'h0fc0; rom[ 1107] = 16'h0000; rom[ 1108] = 16'h0000; rom[ 1109] = 16'h0000; rom[ 1110] = 16'h0000; rom[ 1111] = 16'h0000;
    rom[ 1112] = 16'h0000; rom[ 1113] = 16'h0000; rom[ 1114] = 16'h0000; rom[ 1115] = 16'h0000; rom[ 1116] = 16'h0000; rom[ 1117] = 16'h0000; rom[ 1118] = 16'h0000; rom[ 1119] = 16'h0000;
    rom[ 1120] = 16'h0000; rom[ 1121] = 16'h0000; rom[ 1122] = 16'h0000; rom[ 1123] = 16'h0000; rom[ 1124] = 16'h01f8; rom[ 1125] = 16'h07f8; rom[ 1126] = 16'h0e00; rom[ 1127] = 16'h0c00;
    rom[ 1128] = 16'h1800; rom[ 1129] = 16'h1800; rom[ 1130] = 16'h1800; rom[ 1131] = 16'h1800; rom[ 1132] = 16'h1800; rom[ 1133] = 16'h1800; rom[ 1134] = 16'h1800; rom[ 1135] = 16'h1c00;
    rom[ 1136] = 16'h0e00; rom[ 1137] = 16'h07f8; rom[ 1138] = 16'h03f0; rom[ 1139] = 16'h0000; rom[ 1140] = 16'h0000; rom[ 1141] = 16'h0000; rom[ 1142] = 16'h0000; rom[ 1143] = 16'h0000;
    rom[ 1144] = 16'h0000; rom[ 1145] = 16'h0000; rom[ 1146] = 16'h0000; rom[ 1147] = 16'h0000; rom[ 1148] = 16'h0000; rom[ 1149] = 16'h0000; rom[ 1150] = 16'h0000; rom[ 1151] = 16'h0000;
    rom[ 1152] = 16'h0000; rom[ 1153] = 16'h0000; rom[ 1154] = 16'h0000; rom[ 1155] = 16'h0000; rom[ 1156] = 16'h1f80; rom[ 1157] = 16'h1fe0; rom[ 1158] = 16'h1830; rom[ 1159] = 16'h1818;
    rom[ 1160] = 16'h1818; rom[ 1161] = 16'h1818; rom[ 1162] = 16'h181c; rom[ 1163] = 16'h181c; rom[ 1164] = 16'h181c; rom[ 1165] = 16'h1818; rom[ 1166] = 16'h1818; rom[ 1167] = 16'h1838;
    rom[ 1168] = 16'h1870; rom[ 1169] = 16'h1fe0; rom[ 1170] = 16'h1f00; rom[ 1171] = 16'h0000; rom[ 1172] = 16'h0000; rom[ 1173] = 16'h0000; rom[ 1174] = 16'h0000; rom[ 1175] = 16'h0000;
    rom[ 1176] = 16'h0000; rom[ 1177] = 16'h0000; rom[ 1178] = 16'h0000; rom[ 1179] = 16'h0000; rom[ 1180] = 16'h0000; rom[ 1181] = 16'h0000; rom[ 1182] = 16'h0000; rom[ 1183] = 16'h0000;
    rom[ 1184] = 16'h0000; rom[ 1185] = 16'h0000; rom[ 1186] = 16'h0000; rom[ 1187] = 16'h0000; rom[ 1188] = 16'h0ff0; rom[ 1189] = 16'h0ff0; rom[ 1190] = 16'h0c00; rom[ 1191] = 16'h0c00;
    rom[ 1192] = 16'h0c00; rom[ 1193] = 16'h0c00; rom[ 1194] = 16'h0ff0; rom[ 1195] = 16'h0ff0; rom[ 1196] = 16'h0c00; rom[ 1197] = 16'h0c00; rom[ 1198] = 16'h0c00; rom[ 1199] = 16'h0c00;
    rom[ 1200] = 16'h0c00; rom[ 1201] = 16'h0ff0; rom[ 1202] = 16'h0ff0; rom[ 1203] = 16'h0000; rom[ 1204] = 16'h0000; rom[ 1205] = 16'h0000; rom[ 1206] = 16'h0000; rom[ 1207] = 16'h0000;
    rom[ 1208] = 16'h0000; rom[ 1209] = 16'h0000; rom[ 1210] = 16'h0000; rom[ 1211] = 16'h0000; rom[ 1212] = 16'h0000; rom[ 1213] = 16'h0000; rom[ 1214] = 16'h0000; rom[ 1215] = 16'h0000;
    rom[ 1216] = 16'h0000; rom[ 1217] = 16'h0000; rom[ 1218] = 16'h0000; rom[ 1219] = 16'h0000; rom[ 1220] = 16'h0ff0; rom[ 1221] = 16'h0ff0; rom[ 1222] = 16'h0c00; rom[ 1223] = 16'h0c00;
    rom[ 1224] = 16'h0c00; rom[ 1225] = 16'h0c00; rom[ 1226] = 16'h0c00; rom[ 1227] = 16'h0ff0; rom[ 1228] = 16'h0c00; rom[ 1229] = 16'h0c00; rom[ 1230] = 16'h0c00; rom[ 1231] = 16'h0c00;
    rom[ 1232] = 16'h0c00; rom[ 1233] = 16'h0c00; rom[ 1234] = 16'h0c00; rom[ 1235] = 16'h0000; rom[ 1236] = 16'h0000; rom[ 1237] = 16'h0000; rom[ 1238] = 16'h0000; rom[ 1239] = 16'h0000;
    rom[ 1240] = 16'h0000; rom[ 1241] = 16'h0000; rom[ 1242] = 16'h0000; rom[ 1243] = 16'h0000; rom[ 1244] = 16'h0000; rom[ 1245] = 16'h0000; rom[ 1246] = 16'h0000; rom[ 1247] = 16'h0000;
    rom[ 1248] = 16'h0000; rom[ 1249] = 16'h0000; rom[ 1250] = 16'h0000; rom[ 1251] = 16'h0000; rom[ 1252] = 16'h03f8; rom[ 1253] = 16'h07f8; rom[ 1254] = 16'h0e00; rom[ 1255] = 16'h1c00;
    rom[ 1256] = 16'h1800; rom[ 1257] = 16'h1800; rom[ 1258] = 16'h1800; rom[ 1259] = 16'h18f8; rom[ 1260] = 16'h1818; rom[ 1261] = 16'h1818; rom[ 1262] = 16'h1818; rom[ 1263] = 16'h1c18;
    rom[ 1264] = 16'h0e18; rom[ 1265] = 16'h07f8; rom[ 1266] = 16'h03f0; rom[ 1267] = 16'h0000; rom[ 1268] = 16'h0000; rom[ 1269] = 16'h0000; rom[ 1270] = 16'h0000; rom[ 1271] = 16'h0000;
    rom[ 1272] = 16'h0000; rom[ 1273] = 16'h0000; rom[ 1274] = 16'h0000; rom[ 1275] = 16'h0000; rom[ 1276] = 16'h0000; rom[ 1277] = 16'h0000; rom[ 1278] = 16'h0000; rom[ 1279] = 16'h0000;
    rom[ 1280] = 16'h0000; rom[ 1281] = 16'h0000; rom[ 1282] = 16'h0000; rom[ 1283] = 16'h0000; rom[ 1284] = 16'h1818; rom[ 1285] = 16'h1818; rom[ 1286] = 16'h1818; rom[ 1287] = 16'h1818;
    rom[ 1288] = 16'h1818; rom[ 1289] = 16'h1818; rom[ 1290] = 16'h1ff8; rom[ 1291] = 16'h1ff8; rom[ 1292] = 16'h1818; rom[ 1293] = 16'h1818; rom[ 1294] = 16'h1818; rom[ 1295] = 16'h1818;
    rom[ 1296] = 16'h1818; rom[ 1297] = 16'h1818; rom[ 1298] = 16'h1818; rom[ 1299] = 16'h0000; rom[ 1300] = 16'h0000; rom[ 1301] = 16'h0000; rom[ 1302] = 16'h0000; rom[ 1303] = 16'h0000;
    rom[ 1304] = 16'h0000; rom[ 1305] = 16'h0000; rom[ 1306] = 16'h0000; rom[ 1307] = 16'h0000; rom[ 1308] = 16'h0000; rom[ 1309] = 16'h0000; rom[ 1310] = 16'h0000; rom[ 1311] = 16'h0000;
    rom[ 1312] = 16'h0000; rom[ 1313] = 16'h0000; rom[ 1314] = 16'h0000; rom[ 1315] = 16'h0000; rom[ 1316] = 16'h0ff0; rom[ 1317] = 16'h0ff0; rom[ 1318] = 16'h0180; rom[ 1319] = 16'h0180;
    rom[ 1320] = 16'h0180; rom[ 1321] = 16'h0180; rom[ 1322] = 16'h0180; rom[ 1323] = 16'h0180; rom[ 1324] = 16'h0180; rom[ 1325] = 16'h0180; rom[ 1326] = 16'h0180; rom[ 1327] = 16'h0180;
    rom[ 1328] = 16'h0180; rom[ 1329] = 16'h0ff0; rom[ 1330] = 16'h0ff0; rom[ 1331] = 16'h0000; rom[ 1332] = 16'h0000; rom[ 1333] = 16'h0000; rom[ 1334] = 16'h0000; rom[ 1335] = 16'h0000;
    rom[ 1336] = 16'h0000; rom[ 1337] = 16'h0000; rom[ 1338] = 16'h0000; rom[ 1339] = 16'h0000; rom[ 1340] = 16'h0000; rom[ 1341] = 16'h0000; rom[ 1342] = 16'h0000; rom[ 1343] = 16'h0000;
    rom[ 1344] = 16'h0000; rom[ 1345] = 16'h0000; rom[ 1346] = 16'h0000; rom[ 1347] = 16'h0000; rom[ 1348] = 16'h0ff0; rom[ 1349] = 16'h0ff0; rom[ 1350] = 16'h0030; rom[ 1351] = 16'h0030;
    rom[ 1352] = 16'h0030; rom[ 1353] = 16'h0030; rom[ 1354] = 16'h0030; rom[ 1355] = 16'h0030; rom[ 1356] = 16'h0030; rom[ 1357] = 16'h0030; rom[ 1358] = 16'h0030; rom[ 1359] = 16'h0060;
    rom[ 1360] = 16'h0060; rom[ 1361] = 16'h0fe0; rom[ 1362] = 16'h0780; rom[ 1363] = 16'h0000; rom[ 1364] = 16'h0000; rom[ 1365] = 16'h0000; rom[ 1366] = 16'h0000; rom[ 1367] = 16'h0000;
    rom[ 1368] = 16'h0000; rom[ 1369] = 16'h0000; rom[ 1370] = 16'h0000; rom[ 1371] = 16'h0000; rom[ 1372] = 16'h0000; rom[ 1373] = 16'h0000; rom[ 1374] = 16'h0000; rom[ 1375] = 16'h0000;
    rom[ 1376] = 16'h0000; rom[ 1377] = 16'h0000; rom[ 1378] = 16'h0000; rom[ 1379] = 16'h0000; rom[ 1380] = 16'h0818; rom[ 1381] = 16'h0c30; rom[ 1382] = 16'h0860; rom[ 1383] = 16'h08c0;
    rom[ 1384] = 16'h09c0; rom[ 1385] = 16'h0980; rom[ 1386] = 16'h0f00; rom[ 1387] = 16'h0f00; rom[ 1388] = 16'h0b80; rom[ 1389] = 16'h0980; rom[ 1390] = 16'h0cc0; rom[ 1391] = 16'h0860;
    rom[ 1392] = 16'h0870; rom[ 1393] = 16'h1c38; rom[ 1394] = 16'h0818; rom[ 1395] = 16'h0000; rom[ 1396] = 16'h0000; rom[ 1397] = 16'h0000; rom[ 1398] = 16'h0000; rom[ 1399] = 16'h0000;
    rom[ 1400] = 16'h0000; rom[ 1401] = 16'h0000; rom[ 1402] = 16'h0000; rom[ 1403] = 16'h0000; rom[ 1404] = 16'h0000; rom[ 1405] = 16'h0000; rom[ 1406] = 16'h0000; rom[ 1407] = 16'h0000;
    rom[ 1408] = 16'h0000; rom[ 1409] = 16'h0000; rom[ 1410] = 16'h0000; rom[ 1411] = 16'h0000; rom[ 1412] = 16'h0c00; rom[ 1413] = 16'h0c00; rom[ 1414] = 16'h0c00; rom[ 1415] = 16'h0c00;
    rom[ 1416] = 16'h0c00; rom[ 1417] = 16'h0c00; rom[ 1418] = 16'h0c00; rom[ 1419] = 16'h0c00; rom[ 1420] = 16'h0c00; rom[ 1421] = 16'h0c00; rom[ 1422] = 16'h0c00; rom[ 1423] = 16'h0c00;
    rom[ 1424] = 16'h0c00; rom[ 1425] = 16'h0ff8; rom[ 1426] = 16'h07f8; rom[ 1427] = 16'h0000; rom[ 1428] = 16'h0000; rom[ 1429] = 16'h0000; rom[ 1430] = 16'h0000; rom[ 1431] = 16'h0000;
    rom[ 1432] = 16'h0000; rom[ 1433] = 16'h0000; rom[ 1434] = 16'h0000; rom[ 1435] = 16'h0000; rom[ 1436] = 16'h0000; rom[ 1437] = 16'h0000; rom[ 1438] = 16'h0000; rom[ 1439] = 16'h0000;
    rom[ 1440] = 16'h0000; rom[ 1441] = 16'h0000; rom[ 1442] = 16'h0000; rom[ 1443] = 16'h0000; rom[ 1444] = 16'h1818; rom[ 1445] = 16'h1c38; rom[ 1446] = 16'h1c38; rom[ 1447] = 16'h1e78;
    rom[ 1448] = 16'h1668; rom[ 1449] = 16'h1248; rom[ 1450] = 16'h13c8; rom[ 1451] = 16'h13c8; rom[ 1452] = 16'h118c; rom[ 1453] = 16'h118c; rom[ 1454] = 16'h100c; rom[ 1455] = 16'h300c;
    rom[ 1456] = 16'h300c; rom[ 1457] = 16'h300c; rom[ 1458] = 16'h300c; rom[ 1459] = 16'h0000; rom[ 1460] = 16'h0000; rom[ 1461] = 16'h0000; rom[ 1462] = 16'h0000; rom[ 1463] = 16'h0000;
    rom[ 1464] = 16'h0000; rom[ 1465] = 16'h0000; rom[ 1466] = 16'h0000; rom[ 1467] = 16'h0000; rom[ 1468] = 16'h0000; rom[ 1469] = 16'h0000; rom[ 1470] = 16'h0000; rom[ 1471] = 16'h0000;
    rom[ 1472] = 16'h0000; rom[ 1473] = 16'h0000; rom[ 1474] = 16'h0000; rom[ 1475] = 16'h0000; rom[ 1476] = 16'h1c18; rom[ 1477] = 16'h1c18; rom[ 1478] = 16'h1e18; rom[ 1479] = 16'h1e18;
    rom[ 1480] = 16'h1b18; rom[ 1481] = 16'h1b18; rom[ 1482] = 16'h1998; rom[ 1483] = 16'h1998; rom[ 1484] = 16'h18d8; rom[ 1485] = 16'h18d8; rom[ 1486] = 16'h18d8; rom[ 1487] = 16'h1878;
    rom[ 1488] = 16'h1878; rom[ 1489] = 16'h1838; rom[ 1490] = 16'h1838; rom[ 1491] = 16'h0000; rom[ 1492] = 16'h0000; rom[ 1493] = 16'h0000; rom[ 1494] = 16'h0000; rom[ 1495] = 16'h0000;
    rom[ 1496] = 16'h0000; rom[ 1497] = 16'h0000; rom[ 1498] = 16'h0000; rom[ 1499] = 16'h0000; rom[ 1500] = 16'h0000; rom[ 1501] = 16'h0000; rom[ 1502] = 16'h0000; rom[ 1503] = 16'h0000;
    rom[ 1504] = 16'h0000; rom[ 1505] = 16'h0000; rom[ 1506] = 16'h0000; rom[ 1507] = 16'h0000; rom[ 1508] = 16'h03e0; rom[ 1509] = 16'h0ff0; rom[ 1510] = 16'h0c38; rom[ 1511] = 16'h1818;
    rom[ 1512] = 16'h1818; rom[ 1513] = 16'h180c; rom[ 1514] = 16'h300c; rom[ 1515] = 16'h300c; rom[ 1516] = 16'h300c; rom[ 1517] = 16'h180c; rom[ 1518] = 16'h1818; rom[ 1519] = 16'h1818;
    rom[ 1520] = 16'h1c30; rom[ 1521] = 16'h0ff0; rom[ 1522] = 16'h03c0; rom[ 1523] = 16'h0000; rom[ 1524] = 16'h0000; rom[ 1525] = 16'h0000; rom[ 1526] = 16'h0000; rom[ 1527] = 16'h0000;
    rom[ 1528] = 16'h0000; rom[ 1529] = 16'h0000; rom[ 1530] = 16'h0000; rom[ 1531] = 16'h0000; rom[ 1532] = 16'h0000; rom[ 1533] = 16'h0000; rom[ 1534] = 16'h0000; rom[ 1535] = 16'h0000;
    rom[ 1536] = 16'h0000; rom[ 1537] = 16'h0000; rom[ 1538] = 16'h0000; rom[ 1539] = 16'h0000; rom[ 1540] = 16'h0fc0; rom[ 1541] = 16'h0ff0; rom[ 1542] = 16'h0838; rom[ 1543] = 16'h0c18;
    rom[ 1544] = 16'h0c18; rom[ 1545] = 16'h0c18; rom[ 1546] = 16'h0818; rom[ 1547] = 16'h0c70; rom[ 1548] = 16'h0fe0; rom[ 1549] = 16'h0c00; rom[ 1550] = 16'h0800; rom[ 1551] = 16'h0c00;
    rom[ 1552] = 16'h0800; rom[ 1553] = 16'h0c00; rom[ 1554] = 16'h0800; rom[ 1555] = 16'h0000; rom[ 1556] = 16'h0000; rom[ 1557] = 16'h0000; rom[ 1558] = 16'h0000; rom[ 1559] = 16'h0000;
    rom[ 1560] = 16'h0000; rom[ 1561] = 16'h0000; rom[ 1562] = 16'h0000; rom[ 1563] = 16'h0000; rom[ 1564] = 16'h0000; rom[ 1565] = 16'h0000; rom[ 1566] = 16'h0000; rom[ 1567] = 16'h0000;
    rom[ 1568] = 16'h0000; rom[ 1569] = 16'h0000; rom[ 1570] = 16'h0000; rom[ 1571] = 16'h0000; rom[ 1572] = 16'h03e0; rom[ 1573] = 16'h0ff0; rom[ 1574] = 16'h0c38; rom[ 1575] = 16'h1818;
    rom[ 1576] = 16'h1818; rom[ 1577] = 16'h180c; rom[ 1578] = 16'h300c; rom[ 1579] = 16'h300c; rom[ 1580] = 16'h300c; rom[ 1581] = 16'h180c; rom[ 1582] = 16'h1818; rom[ 1583] = 16'h1818;
    rom[ 1584] = 16'h1c38; rom[ 1585] = 16'h0ff0; rom[ 1586] = 16'h07c0; rom[ 1587] = 16'h0180; rom[ 1588] = 16'h01c0; rom[ 1589] = 16'h00fc; rom[ 1590] = 16'h0038; rom[ 1591] = 16'h0000;
    rom[ 1592] = 16'h0000; rom[ 1593] = 16'h0000; rom[ 1594] = 16'h0000; rom[ 1595] = 16'h0000; rom[ 1596] = 16'h0000; rom[ 1597] = 16'h0000; rom[ 1598] = 16'h0000; rom[ 1599] = 16'h0000;
    rom[ 1600] = 16'h0000; rom[ 1601] = 16'h0000; rom[ 1602] = 16'h0000; rom[ 1603] = 16'h0000; rom[ 1604] = 16'h0fc0; rom[ 1605] = 16'h0ff0; rom[ 1606] = 16'h0c30; rom[ 1607] = 16'h0c30;
    rom[ 1608] = 16'h0c30; rom[ 1609] = 16'h0c30; rom[ 1610] = 16'h0ce0; rom[ 1611] = 16'h0fc0; rom[ 1612] = 16'h0cc0; rom[ 1613] = 16'h0c60; rom[ 1614] = 16'h0c70; rom[ 1615] = 16'h0c30;
    rom[ 1616] = 16'h0c30; rom[ 1617] = 16'h0c18; rom[ 1618] = 16'h0818; rom[ 1619] = 16'h0000; rom[ 1620] = 16'h0000; rom[ 1621] = 16'h0000; rom[ 1622] = 16'h0000; rom[ 1623] = 16'h0000;
    rom[ 1624] = 16'h0000; rom[ 1625] = 16'h0000; rom[ 1626] = 16'h0000; rom[ 1627] = 16'h0000; rom[ 1628] = 16'h0000; rom[ 1629] = 16'h0000; rom[ 1630] = 16'h0000; rom[ 1631] = 16'h0000;
    rom[ 1632] = 16'h0000; rom[ 1633] = 16'h0000; rom[ 1634] = 16'h0000; rom[ 1635] = 16'h0000; rom[ 1636] = 16'h03f0; rom[ 1637] = 16'h0ff0; rom[ 1638] = 16'h1c00; rom[ 1639] = 16'h1800;
    rom[ 1640] = 16'h1800; rom[ 1641] = 16'h0c00; rom[ 1642] = 16'h0f80; rom[ 1643] = 16'h03e0; rom[ 1644] = 16'h00f0; rom[ 1645] = 16'h0038; rom[ 1646] = 16'h0018; rom[ 1647] = 16'h0018;
    rom[ 1648] = 16'h0038; rom[ 1649] = 16'h1ff0; rom[ 1650] = 16'h1fc0; rom[ 1651] = 16'h0000; rom[ 1652] = 16'h0000; rom[ 1653] = 16'h0000; rom[ 1654] = 16'h0000; rom[ 1655] = 16'h0000;
    rom[ 1656] = 16'h0000; rom[ 1657] = 16'h0000; rom[ 1658] = 16'h0000; rom[ 1659] = 16'h0000; rom[ 1660] = 16'h0000; rom[ 1661] = 16'h0000; rom[ 1662] = 16'h0000; rom[ 1663] = 16'h0000;
    rom[ 1664] = 16'h0000; rom[ 1665] = 16'h0000; rom[ 1666] = 16'h0000; rom[ 1667] = 16'h0000; rom[ 1668] = 16'h1ff8; rom[ 1669] = 16'h1ff8; rom[ 1670] = 16'h0180; rom[ 1671] = 16'h0180;
    rom[ 1672] = 16'h0180; rom[ 1673] = 16'h0180; rom[ 1674] = 16'h0180; rom[ 1675] = 16'h0180; rom[ 1676] = 16'h0180; rom[ 1677] = 16'h0180; rom[ 1678] = 16'h0180; rom[ 1679] = 16'h0180;
    rom[ 1680] = 16'h0180; rom[ 1681] = 16'h0180; rom[ 1682] = 16'h0180; rom[ 1683] = 16'h0000; rom[ 1684] = 16'h0000; rom[ 1685] = 16'h0000; rom[ 1686] = 16'h0000; rom[ 1687] = 16'h0000;
    rom[ 1688] = 16'h0000; rom[ 1689] = 16'h0000; rom[ 1690] = 16'h0000; rom[ 1691] = 16'h0000; rom[ 1692] = 16'h0000; rom[ 1693] = 16'h0000; rom[ 1694] = 16'h0000; rom[ 1695] = 16'h0000;
    rom[ 1696] = 16'h0000; rom[ 1697] = 16'h0000; rom[ 1698] = 16'h0000; rom[ 1699] = 16'h0000; rom[ 1700] = 16'h1818; rom[ 1701] = 16'h1818; rom[ 1702] = 16'h1818; rom[ 1703] = 16'h1818;
    rom[ 1704] = 16'h1818; rom[ 1705] = 16'h1818; rom[ 1706] = 16'h1818; rom[ 1707] = 16'h1818; rom[ 1708] = 16'h1818; rom[ 1709] = 16'h1818; rom[ 1710] = 16'h1818; rom[ 1711] = 16'h1818;
    rom[ 1712] = 16'h1c38; rom[ 1713] = 16'h0ff0; rom[ 1714] = 16'h07c0; rom[ 1715] = 16'h0000; rom[ 1716] = 16'h0000; rom[ 1717] = 16'h0000; rom[ 1718] = 16'h0000; rom[ 1719] = 16'h0000;
    rom[ 1720] = 16'h0000; rom[ 1721] = 16'h0000; rom[ 1722] = 16'h0000; rom[ 1723] = 16'h0000; rom[ 1724] = 16'h0000; rom[ 1725] = 16'h0000; rom[ 1726] = 16'h0000; rom[ 1727] = 16'h0000;
    rom[ 1728] = 16'h0000; rom[ 1729] = 16'h0000; rom[ 1730] = 16'h0000; rom[ 1731] = 16'h0000; rom[ 1732] = 16'h300c; rom[ 1733] = 16'h300c; rom[ 1734] = 16'h181c; rom[ 1735] = 16'h1818;
    rom[ 1736] = 16'h1818; rom[ 1737] = 16'h0c18; rom[ 1738] = 16'h0c30; rom[ 1739] = 16'h0c30; rom[ 1740] = 16'h0620; rom[ 1741] = 16'h0660; rom[ 1742] = 16'h0660; rom[ 1743] = 16'h0340;
    rom[ 1744] = 16'h03c0; rom[ 1745] = 16'h03c0; rom[ 1746] = 16'h0180; rom[ 1747] = 16'h0000; rom[ 1748] = 16'h0000; rom[ 1749] = 16'h0000; rom[ 1750] = 16'h0000; rom[ 1751] = 16'h0000;
    rom[ 1752] = 16'h0000; rom[ 1753] = 16'h0000; rom[ 1754] = 16'h0000; rom[ 1755] = 16'h0000; rom[ 1756] = 16'h0000; rom[ 1757] = 16'h0000; rom[ 1758] = 16'h0000; rom[ 1759] = 16'h0000;
    rom[ 1760] = 16'h0000; rom[ 1761] = 16'h0000; rom[ 1762] = 16'h0000; rom[ 1763] = 16'h0000; rom[ 1764] = 16'h300c; rom[ 1765] = 16'h300c; rom[ 1766] = 16'h300c; rom[ 1767] = 16'h300c;
    rom[ 1768] = 16'h100c; rom[ 1769] = 16'h118c; rom[ 1770] = 16'h1988; rom[ 1771] = 16'h19c8; rom[ 1772] = 16'h1bc8; rom[ 1773] = 16'h1a48; rom[ 1774] = 16'h1a68; rom[ 1775] = 16'h1e78;
    rom[ 1776] = 16'h1e38; rom[ 1777] = 16'h1c38; rom[ 1778] = 16'h1c38; rom[ 1779] = 16'h0000; rom[ 1780] = 16'h0000; rom[ 1781] = 16'h0000; rom[ 1782] = 16'h0000; rom[ 1783] = 16'h0000;
    rom[ 1784] = 16'h0000; rom[ 1785] = 16'h0000; rom[ 1786] = 16'h0000; rom[ 1787] = 16'h0000; rom[ 1788] = 16'h0000; rom[ 1789] = 16'h0000; rom[ 1790] = 16'h0000; rom[ 1791] = 16'h0000;
    rom[ 1792] = 16'h0000; rom[ 1793] = 16'h0000; rom[ 1794] = 16'h0000; rom[ 1795] = 16'h0000; rom[ 1796] = 16'h1818; rom[ 1797] = 16'h1c18; rom[ 1798] = 16'h0c30; rom[ 1799] = 16'h0e70;
    rom[ 1800] = 16'h0660; rom[ 1801] = 16'h03c0; rom[ 1802] = 16'h03c0; rom[ 1803] = 16'h0180; rom[ 1804] = 16'h03c0; rom[ 1805] = 16'h07e0; rom[ 1806] = 16'h0660; rom[ 1807] = 16'h0c30;
    rom[ 1808] = 16'h1c38; rom[ 1809] = 16'h1818; rom[ 1810] = 16'h300c; rom[ 1811] = 16'h0000; rom[ 1812] = 16'h0000; rom[ 1813] = 16'h0000; rom[ 1814] = 16'h0000; rom[ 1815] = 16'h0000;
    rom[ 1816] = 16'h0000; rom[ 1817] = 16'h0000; rom[ 1818] = 16'h0000; rom[ 1819] = 16'h0000; rom[ 1820] = 16'h0000; rom[ 1821] = 16'h0000; rom[ 1822] = 16'h0000; rom[ 1823] = 16'h0000;
    rom[ 1824] = 16'h0000; rom[ 1825] = 16'h0000; rom[ 1826] = 16'h0000; rom[ 1827] = 16'h0000; rom[ 1828] = 16'h300c; rom[ 1829] = 16'h181c; rom[ 1830] = 16'h1818; rom[ 1831] = 16'h0c30;
    rom[ 1832] = 16'h0e30; rom[ 1833] = 16'h0660; rom[ 1834] = 16'h0760; rom[ 1835] = 16'h03c0; rom[ 1836] = 16'h03c0; rom[ 1837] = 16'h0180; rom[ 1838] = 16'h0180; rom[ 1839] = 16'h0180;
    rom[ 1840] = 16'h0180; rom[ 1841] = 16'h0180; rom[ 1842] = 16'h0180; rom[ 1843] = 16'h0000; rom[ 1844] = 16'h0000; rom[ 1845] = 16'h0000; rom[ 1846] = 16'h0000; rom[ 1847] = 16'h0000;
    rom[ 1848] = 16'h0000; rom[ 1849] = 16'h0000; rom[ 1850] = 16'h0000; rom[ 1851] = 16'h0000; rom[ 1852] = 16'h0000; rom[ 1853] = 16'h0000; rom[ 1854] = 16'h0000; rom[ 1855] = 16'h0000;
    rom[ 1856] = 16'h0000; rom[ 1857] = 16'h0000; rom[ 1858] = 16'h0000; rom[ 1859] = 16'h0000; rom[ 1860] = 16'h1ff8; rom[ 1861] = 16'h1ff8; rom[ 1862] = 16'h0030; rom[ 1863] = 16'h0030;
    rom[ 1864] = 16'h0060; rom[ 1865] = 16'h00c0; rom[ 1866] = 16'h00c0; rom[ 1867] = 16'h0180; rom[ 1868] = 16'h0300; rom[ 1869] = 16'h0300; rom[ 1870] = 16'h0600; rom[ 1871] = 16'h0c00;
    rom[ 1872] = 16'h0c00; rom[ 1873] = 16'h1ff8; rom[ 1874] = 16'h1ff8; rom[ 1875] = 16'h0000; rom[ 1876] = 16'h0000; rom[ 1877] = 16'h0000; rom[ 1878] = 16'h0000; rom[ 1879] = 16'h0000;
    rom[ 1880] = 16'h0000; rom[ 1881] = 16'h0000; rom[ 1882] = 16'h0000; rom[ 1883] = 16'h0000; rom[ 1884] = 16'h0000; rom[ 1885] = 16'h0000; rom[ 1886] = 16'h0000; rom[ 1887] = 16'h0000;
    rom[ 1888] = 16'h0000; rom[ 1889] = 16'h0000; rom[ 1890] = 16'h02e0; rom[ 1891] = 16'h03e0; rom[ 1892] = 16'h0300; rom[ 1893] = 16'h0200; rom[ 1894] = 16'h0200; rom[ 1895] = 16'h0200;
    rom[ 1896] = 16'h0200; rom[ 1897] = 16'h0200; rom[ 1898] = 16'h0200; rom[ 1899] = 16'h0200; rom[ 1900] = 16'h0200; rom[ 1901] = 16'h0200; rom[ 1902] = 16'h0200; rom[ 1903] = 16'h0200;
    rom[ 1904] = 16'h0200; rom[ 1905] = 16'h0200; rom[ 1906] = 16'h0200; rom[ 1907] = 16'h0200; rom[ 1908] = 16'h0200; rom[ 1909] = 16'h0300; rom[ 1910] = 16'h03e0; rom[ 1911] = 16'h0000;
    rom[ 1912] = 16'h0000; rom[ 1913] = 16'h0000; rom[ 1914] = 16'h0000; rom[ 1915] = 16'h0000; rom[ 1916] = 16'h0000; rom[ 1917] = 16'h0000; rom[ 1918] = 16'h0000; rom[ 1919] = 16'h0000;
    rom[ 1920] = 16'h0000; rom[ 1921] = 16'h0000; rom[ 1922] = 16'h0000; rom[ 1923] = 16'h0c00; rom[ 1924] = 16'h0c00; rom[ 1925] = 16'h0600; rom[ 1926] = 16'h0600; rom[ 1927] = 16'h0200;
    rom[ 1928] = 16'h0300; rom[ 1929] = 16'h0300; rom[ 1930] = 16'h0180; rom[ 1931] = 16'h0180; rom[ 1932] = 16'h0080; rom[ 1933] = 16'h00c0; rom[ 1934] = 16'h00c0; rom[ 1935] = 16'h0060;
    rom[ 1936] = 16'h0060; rom[ 1937] = 16'h0030; rom[ 1938] = 16'h0030; rom[ 1939] = 16'h0010; rom[ 1940] = 16'h0018; rom[ 1941] = 16'h0000; rom[ 1942] = 16'h0000; rom[ 1943] = 16'h0000;
    rom[ 1944] = 16'h0000; rom[ 1945] = 16'h0000; rom[ 1946] = 16'h0000; rom[ 1947] = 16'h0000; rom[ 1948] = 16'h0000; rom[ 1949] = 16'h0000; rom[ 1950] = 16'h0000; rom[ 1951] = 16'h0000;
    rom[ 1952] = 16'h0000; rom[ 1953] = 16'h0000; rom[ 1954] = 16'h03c0; rom[ 1955] = 16'h07e0; rom[ 1956] = 16'h0040; rom[ 1957] = 16'h0060; rom[ 1958] = 16'h0060; rom[ 1959] = 16'h0060;
    rom[ 1960] = 16'h0060; rom[ 1961] = 16'h0060; rom[ 1962] = 16'h0060; rom[ 1963] = 16'h0060; rom[ 1964] = 16'h0060; rom[ 1965] = 16'h0060; rom[ 1966] = 16'h0060; rom[ 1967] = 16'h0060;
    rom[ 1968] = 16'h0060; rom[ 1969] = 16'h0060; rom[ 1970] = 16'h0060; rom[ 1971] = 16'h0060; rom[ 1972] = 16'h0060; rom[ 1973] = 16'h0060; rom[ 1974] = 16'h07e0; rom[ 1975] = 16'h0000;
    rom[ 1976] = 16'h0000; rom[ 1977] = 16'h0000; rom[ 1978] = 16'h0000; rom[ 1979] = 16'h0000; rom[ 1980] = 16'h0000; rom[ 1981] = 16'h0000; rom[ 1982] = 16'h0000; rom[ 1983] = 16'h0000;
    rom[ 1984] = 16'h0000; rom[ 1985] = 16'h0000; rom[ 1986] = 16'h0000; rom[ 1987] = 16'h0000; rom[ 1988] = 16'h0180; rom[ 1989] = 16'h03c0; rom[ 1990] = 16'h02c0; rom[ 1991] = 16'h0660;
    rom[ 1992] = 16'h0420; rom[ 1993] = 16'h0c30; rom[ 1994] = 16'h0818; rom[ 1995] = 16'h0000; rom[ 1996] = 16'h0000; rom[ 1997] = 16'h0000; rom[ 1998] = 16'h0000; rom[ 1999] = 16'h0000;
    rom[ 2000] = 16'h0000; rom[ 2001] = 16'h0000; rom[ 2002] = 16'h0000; rom[ 2003] = 16'h0000; rom[ 2004] = 16'h0000; rom[ 2005] = 16'h0000; rom[ 2006] = 16'h0000; rom[ 2007] = 16'h0000;
    rom[ 2008] = 16'h0000; rom[ 2009] = 16'h0000; rom[ 2010] = 16'h0000; rom[ 2011] = 16'h0000; rom[ 2012] = 16'h0000; rom[ 2013] = 16'h0000; rom[ 2014] = 16'h0000; rom[ 2015] = 16'h0000;
    rom[ 2016] = 16'h0000; rom[ 2017] = 16'h0000; rom[ 2018] = 16'h0000; rom[ 2019] = 16'h0000; rom[ 2020] = 16'h0000; rom[ 2021] = 16'h0000; rom[ 2022] = 16'h0000; rom[ 2023] = 16'h0000;
    rom[ 2024] = 16'h0000; rom[ 2025] = 16'h0000; rom[ 2026] = 16'h0000; rom[ 2027] = 16'h0000; rom[ 2028] = 16'h0000; rom[ 2029] = 16'h0000; rom[ 2030] = 16'h0000; rom[ 2031] = 16'h0000;
    rom[ 2032] = 16'h0000; rom[ 2033] = 16'h0000; rom[ 2034] = 16'h0000; rom[ 2035] = 16'h0000; rom[ 2036] = 16'h0000; rom[ 2037] = 16'h0000; rom[ 2038] = 16'h3ffc; rom[ 2039] = 16'h0000;
    rom[ 2040] = 16'h0000; rom[ 2041] = 16'h0000; rom[ 2042] = 16'h0000; rom[ 2043] = 16'h0000; rom[ 2044] = 16'h0000; rom[ 2045] = 16'h0000; rom[ 2046] = 16'h0000; rom[ 2047] = 16'h0000;
    rom[ 2048] = 16'h0000; rom[ 2049] = 16'h0000; rom[ 2050] = 16'h0000; rom[ 2051] = 16'h0600; rom[ 2052] = 16'h0300; rom[ 2053] = 16'h0180; rom[ 2054] = 16'h0000; rom[ 2055] = 16'h0000;
    rom[ 2056] = 16'h0000; rom[ 2057] = 16'h0000; rom[ 2058] = 16'h0000; rom[ 2059] = 16'h0000; rom[ 2060] = 16'h0000; rom[ 2061] = 16'h0000; rom[ 2062] = 16'h0000; rom[ 2063] = 16'h0000;
    rom[ 2064] = 16'h0000; rom[ 2065] = 16'h0000; rom[ 2066] = 16'h0000; rom[ 2067] = 16'h0000; rom[ 2068] = 16'h0000; rom[ 2069] = 16'h0000; rom[ 2070] = 16'h0000; rom[ 2071] = 16'h0000;
    rom[ 2072] = 16'h0000; rom[ 2073] = 16'h0000; rom[ 2074] = 16'h0000; rom[ 2075] = 16'h0000; rom[ 2076] = 16'h0000; rom[ 2077] = 16'h0000; rom[ 2078] = 16'h0000; rom[ 2079] = 16'h0000;
    rom[ 2080] = 16'h0000; rom[ 2081] = 16'h0000; rom[ 2082] = 16'h0000; rom[ 2083] = 16'h0000; rom[ 2084] = 16'h0000; rom[ 2085] = 16'h0000; rom[ 2086] = 16'h0000; rom[ 2087] = 16'h03c0;
    rom[ 2088] = 16'h0ff0; rom[ 2089] = 16'h0030; rom[ 2090] = 16'h0018; rom[ 2091] = 16'h0018; rom[ 2092] = 16'h03f8; rom[ 2093] = 16'h0ff8; rom[ 2094] = 16'h1c18; rom[ 2095] = 16'h1818;
    rom[ 2096] = 16'h1c38; rom[ 2097] = 16'h0ff8; rom[ 2098] = 16'h0790; rom[ 2099] = 16'h0000; rom[ 2100] = 16'h0000; rom[ 2101] = 16'h0000; rom[ 2102] = 16'h0000; rom[ 2103] = 16'h0000;
    rom[ 2104] = 16'h0000; rom[ 2105] = 16'h0000; rom[ 2106] = 16'h0000; rom[ 2107] = 16'h0000; rom[ 2108] = 16'h0000; rom[ 2109] = 16'h0000; rom[ 2110] = 16'h0000; rom[ 2111] = 16'h0000;
    rom[ 2112] = 16'h0000; rom[ 2113] = 16'h0000; rom[ 2114] = 16'h0000; rom[ 2115] = 16'h0800; rom[ 2116] = 16'h0800; rom[ 2117] = 16'h0800; rom[ 2118] = 16'h0800; rom[ 2119] = 16'h08e0;
    rom[ 2120] = 16'h0bf0; rom[ 2121] = 16'h0e38; rom[ 2122] = 16'h0c18; rom[ 2123] = 16'h0c18; rom[ 2124] = 16'h0818; rom[ 2125] = 16'h0818; rom[ 2126] = 16'h0818; rom[ 2127] = 16'h0818;
    rom[ 2128] = 16'h0c30; rom[ 2129] = 16'h0ff0; rom[ 2130] = 16'h0fc0; rom[ 2131] = 16'h0000; rom[ 2132] = 16'h0000; rom[ 2133] = 16'h0000; rom[ 2134] = 16'h0000; rom[ 2135] = 16'h0000;
    rom[ 2136] = 16'h0000; rom[ 2137] = 16'h0000; rom[ 2138] = 16'h0000; rom[ 2139] = 16'h0000; rom[ 2140] = 16'h0000; rom[ 2141] = 16'h0000; rom[ 2142] = 16'h0000; rom[ 2143] = 16'h0000;
    rom[ 2144] = 16'h0000; rom[ 2145] = 16'h0000; rom[ 2146] = 16'h0000; rom[ 2147] = 16'h0000; rom[ 2148] = 16'h0000; rom[ 2149] = 16'h0000; rom[ 2150] = 16'h0000; rom[ 2151] = 16'h00e0;
    rom[ 2152] = 16'h03f0; rom[ 2153] = 16'h0600; rom[ 2154] = 16'h0c00; rom[ 2155] = 16'h0c00; rom[ 2156] = 16'h0c00; rom[ 2157] = 16'h0c00; rom[ 2158] = 16'h0c00; rom[ 2159] = 16'h0c00;
    rom[ 2160] = 16'h0e00; rom[ 2161] = 16'h07f0; rom[ 2162] = 16'h03f0; rom[ 2163] = 16'h0000; rom[ 2164] = 16'h0000; rom[ 2165] = 16'h0000; rom[ 2166] = 16'h0000; rom[ 2167] = 16'h0000;
    rom[ 2168] = 16'h0000; rom[ 2169] = 16'h0000; rom[ 2170] = 16'h0000; rom[ 2171] = 16'h0000; rom[ 2172] = 16'h0000; rom[ 2173] = 16'h0000; rom[ 2174] = 16'h0000; rom[ 2175] = 16'h0000;
    rom[ 2176] = 16'h0000; rom[ 2177] = 16'h0000; rom[ 2178] = 16'h0000; rom[ 2179] = 16'h0018; rom[ 2180] = 16'h0018; rom[ 2181] = 16'h0018; rom[ 2182] = 16'h0018; rom[ 2183] = 16'h01f8;
    rom[ 2184] = 16'h07f8; rom[ 2185] = 16'h0c38; rom[ 2186] = 16'h1818; rom[ 2187] = 16'h1818; rom[ 2188] = 16'h1818; rom[ 2189] = 16'h1818; rom[ 2190] = 16'h1818; rom[ 2191] = 16'h1838;
    rom[ 2192] = 16'h0c78; rom[ 2193] = 16'h0fd8; rom[ 2194] = 16'h0790; rom[ 2195] = 16'h0000; rom[ 2196] = 16'h0000; rom[ 2197] = 16'h0000; rom[ 2198] = 16'h0000; rom[ 2199] = 16'h0000;
    rom[ 2200] = 16'h0000; rom[ 2201] = 16'h0000; rom[ 2202] = 16'h0000; rom[ 2203] = 16'h0000; rom[ 2204] = 16'h0000; rom[ 2205] = 16'h0000; rom[ 2206] = 16'h0000; rom[ 2207] = 16'h0000;
    rom[ 2208] = 16'h0000; rom[ 2209] = 16'h0000; rom[ 2210] = 16'h0000; rom[ 2211] = 16'h0000; rom[ 2212] = 16'h0000; rom[ 2213] = 16'h0000; rom[ 2214] = 16'h0000; rom[ 2215] = 16'h01c0;
    rom[ 2216] = 16'h07f0; rom[ 2217] = 16'h0c30; rom[ 2218] = 16'h0c18; rom[ 2219] = 16'h1818; rom[ 2220] = 16'h1ff8; rom[ 2221] = 16'h1ff8; rom[ 2222] = 16'h1800; rom[ 2223] = 16'h1800;
    rom[ 2224] = 16'h0c00; rom[ 2225] = 16'h0ff0; rom[ 2226] = 16'h03f0; rom[ 2227] = 16'h0000; rom[ 2228] = 16'h0000; rom[ 2229] = 16'h0000; rom[ 2230] = 16'h0000; rom[ 2231] = 16'h0000;
    rom[ 2232] = 16'h0000; rom[ 2233] = 16'h0000; rom[ 2234] = 16'h0000; rom[ 2235] = 16'h0000; rom[ 2236] = 16'h0000; rom[ 2237] = 16'h0000; rom[ 2238] = 16'h0000; rom[ 2239] = 16'h0000;
    rom[ 2240] = 16'h0000; rom[ 2241] = 16'h0000; rom[ 2242] = 16'h0000; rom[ 2243] = 16'h00fc; rom[ 2244] = 16'h01c8; rom[ 2245] = 16'h0180; rom[ 2246] = 16'h0300; rom[ 2247] = 16'h0300;
    rom[ 2248] = 16'h0300; rom[ 2249] = 16'h1ff8; rom[ 2250] = 16'h1ff8; rom[ 2251] = 16'h0300; rom[ 2252] = 16'h0300; rom[ 2253] = 16'h0300; rom[ 2254] = 16'h0300; rom[ 2255] = 16'h0300;
    rom[ 2256] = 16'h0300; rom[ 2257] = 16'h0300; rom[ 2258] = 16'h0300; rom[ 2259] = 16'h0000; rom[ 2260] = 16'h0000; rom[ 2261] = 16'h0000; rom[ 2262] = 16'h0000; rom[ 2263] = 16'h0000;
    rom[ 2264] = 16'h0000; rom[ 2265] = 16'h0000; rom[ 2266] = 16'h0000; rom[ 2267] = 16'h0000; rom[ 2268] = 16'h0000; rom[ 2269] = 16'h0000; rom[ 2270] = 16'h0000; rom[ 2271] = 16'h0000;
    rom[ 2272] = 16'h0000; rom[ 2273] = 16'h0000; rom[ 2274] = 16'h0000; rom[ 2275] = 16'h0000; rom[ 2276] = 16'h0000; rom[ 2277] = 16'h0000; rom[ 2278] = 16'h0000; rom[ 2279] = 16'h03c8;
    rom[ 2280] = 16'h07fc; rom[ 2281] = 16'h0c30; rom[ 2282] = 16'h0c30; rom[ 2283] = 16'h0830; rom[ 2284] = 16'h0c30; rom[ 2285] = 16'h0fe0; rom[ 2286] = 16'h0fc0; rom[ 2287] = 16'h1800;
    rom[ 2288] = 16'h1c00; rom[ 2289] = 16'h0ff0; rom[ 2290] = 16'h0df8; rom[ 2291] = 16'h1818; rom[ 2292] = 16'h1818; rom[ 2293] = 16'h1c38; rom[ 2294] = 16'h0ff0; rom[ 2295] = 16'h0180;
    rom[ 2296] = 16'h0000; rom[ 2297] = 16'h0000; rom[ 2298] = 16'h0000; rom[ 2299] = 16'h0000; rom[ 2300] = 16'h0000; rom[ 2301] = 16'h0000; rom[ 2302] = 16'h0000; rom[ 2303] = 16'h0000;
    rom[ 2304] = 16'h0000; rom[ 2305] = 16'h0000; rom[ 2306] = 16'h0000; rom[ 2307] = 16'h0800; rom[ 2308] = 16'h0800; rom[ 2309] = 16'h0800; rom[ 2310] = 16'h0800; rom[ 2311] = 16'h08c0;
    rom[ 2312] = 16'h0ff0; rom[ 2313] = 16'h0e30; rom[ 2314] = 16'h0c18; rom[ 2315] = 16'h0c18; rom[ 2316] = 16'h0818; rom[ 2317] = 16'h0818; rom[ 2318] = 16'h0818; rom[ 2319] = 16'h0818;
    rom[ 2320] = 16'h0818; rom[ 2321] = 16'h0c18; rom[ 2322] = 16'h0810; rom[ 2323] = 16'h0000; rom[ 2324] = 16'h0000; rom[ 2325] = 16'h0000; rom[ 2326] = 16'h0000; rom[ 2327] = 16'h0000;
    rom[ 2328] = 16'h0000; rom[ 2329] = 16'h0000; rom[ 2330] = 16'h0000; rom[ 2331] = 16'h0000; rom[ 2332] = 16'h0000; rom[ 2333] = 16'h0000; rom[ 2334] = 16'h0000; rom[ 2335] = 16'h0000;
    rom[ 2336] = 16'h0000; rom[ 2337] = 16'h0000; rom[ 2338] = 16'h0000; rom[ 2339] = 16'h0180; rom[ 2340] = 16'h01c0; rom[ 2341] = 16'h0180; rom[ 2342] = 16'h0000; rom[ 2343] = 16'h0680;
    rom[ 2344] = 16'h0f80; rom[ 2345] = 16'h0180; rom[ 2346] = 16'h0180; rom[ 2347] = 16'h0180; rom[ 2348] = 16'h0180; rom[ 2349] = 16'h0180; rom[ 2350] = 16'h0180; rom[ 2351] = 16'h0180;
    rom[ 2352] = 16'h0180; rom[ 2353] = 16'h0ff8; rom[ 2354] = 16'h0ff8; rom[ 2355] = 16'h0000; rom[ 2356] = 16'h0000; rom[ 2357] = 16'h0000; rom[ 2358] = 16'h0000; rom[ 2359] = 16'h0000;
    rom[ 2360] = 16'h0000; rom[ 2361] = 16'h0000; rom[ 2362] = 16'h0000; rom[ 2363] = 16'h0000; rom[ 2364] = 16'h0000; rom[ 2365] = 16'h0000; rom[ 2366] = 16'h0000; rom[ 2367] = 16'h0000;
    rom[ 2368] = 16'h0000; rom[ 2369] = 16'h0000; rom[ 2370] = 16'h0000; rom[ 2371] = 16'h0060; rom[ 2372] = 16'h00f0; rom[ 2373] = 16'h0060; rom[ 2374] = 16'h0000; rom[ 2375] = 16'h0be0;
    rom[ 2376] = 16'h0fe0; rom[ 2377] = 16'h0060; rom[ 2378] = 16'h0060; rom[ 2379] = 16'h0060; rom[ 2380] = 16'h0060; rom[ 2381] = 16'h0060; rom[ 2382] = 16'h0060; rom[ 2383] = 16'h0060;
    rom[ 2384] = 16'h0060; rom[ 2385] = 16'h0060; rom[ 2386] = 16'h0060; rom[ 2387] = 16'h0060; rom[ 2388] = 16'h0060; rom[ 2389] = 16'h10c0; rom[ 2390] = 16'h1fc0; rom[ 2391] = 16'h0200;
    rom[ 2392] = 16'h0000; rom[ 2393] = 16'h0000; rom[ 2394] = 16'h0000; rom[ 2395] = 16'h0000; rom[ 2396] = 16'h0000; rom[ 2397] = 16'h0000; rom[ 2398] = 16'h0000; rom[ 2399] = 16'h0000;
    rom[ 2400] = 16'h0000; rom[ 2401] = 16'h0000; rom[ 2402] = 16'h0000; rom[ 2403] = 16'h0c00; rom[ 2404] = 16'h0c00; rom[ 2405] = 16'h0c00; rom[ 2406] = 16'h0c00; rom[ 2407] = 16'h0c08;
    rom[ 2408] = 16'h0c30; rom[ 2409] = 16'h0c60; rom[ 2410] = 16'h0cc0; rom[ 2411] = 16'h0d80; rom[ 2412] = 16'h0f00; rom[ 2413] = 16'h0f80; rom[ 2414] = 16'h0dc0; rom[ 2415] = 16'h0ce0;
    rom[ 2416] = 16'h0c70; rom[ 2417] = 16'h0c38; rom[ 2418] = 16'h0c18; rom[ 2419] = 16'h0000; rom[ 2420] = 16'h0000; rom[ 2421] = 16'h0000; rom[ 2422] = 16'h0000; rom[ 2423] = 16'h0000;
    rom[ 2424] = 16'h0000; rom[ 2425] = 16'h0000; rom[ 2426] = 16'h0000; rom[ 2427] = 16'h0000; rom[ 2428] = 16'h0000; rom[ 2429] = 16'h0000; rom[ 2430] = 16'h0000; rom[ 2431] = 16'h0000;
    rom[ 2432] = 16'h0000; rom[ 2433] = 16'h0000; rom[ 2434] = 16'h0000; rom[ 2435] = 16'h0f80; rom[ 2436] = 16'h0180; rom[ 2437] = 16'h0180; rom[ 2438] = 16'h0180; rom[ 2439] = 16'h0180;
    rom[ 2440] = 16'h0180; rom[ 2441] = 16'h0180; rom[ 2442] = 16'h0180; rom[ 2443] = 16'h0180; rom[ 2444] = 16'h0180; rom[ 2445] = 16'h0180; rom[ 2446] = 16'h0180; rom[ 2447] = 16'h0180;
    rom[ 2448] = 16'h0180; rom[ 2449] = 16'h0ff8; rom[ 2450] = 16'h0ff8; rom[ 2451] = 16'h0000; rom[ 2452] = 16'h0000; rom[ 2453] = 16'h0000; rom[ 2454] = 16'h0000; rom[ 2455] = 16'h0000;
    rom[ 2456] = 16'h0000; rom[ 2457] = 16'h0000; rom[ 2458] = 16'h0000; rom[ 2459] = 16'h0000; rom[ 2460] = 16'h0000; rom[ 2461] = 16'h0000; rom[ 2462] = 16'h0000; rom[ 2463] = 16'h0000;
    rom[ 2464] = 16'h0000; rom[ 2465] = 16'h0000; rom[ 2466] = 16'h0000; rom[ 2467] = 16'h0000; rom[ 2468] = 16'h0000; rom[ 2469] = 16'h0000; rom[ 2470] = 16'h0000; rom[ 2471] = 16'h1330;
    rom[ 2472] = 16'h1778; rom[ 2473] = 16'h1dc8; rom[ 2474] = 16'h1988; rom[ 2475] = 16'h1988; rom[ 2476] = 16'h1988; rom[ 2477] = 16'h1988; rom[ 2478] = 16'h1988; rom[ 2479] = 16'h1988;
    rom[ 2480] = 16'h1988; rom[ 2481] = 16'h1988; rom[ 2482] = 16'h1188; rom[ 2483] = 16'h0000; rom[ 2484] = 16'h0000; rom[ 2485] = 16'h0000; rom[ 2486] = 16'h0000; rom[ 2487] = 16'h0000;
    rom[ 2488] = 16'h0000; rom[ 2489] = 16'h0000; rom[ 2490] = 16'h0000; rom[ 2491] = 16'h0000; rom[ 2492] = 16'h0000; rom[ 2493] = 16'h0000; rom[ 2494] = 16'h0000; rom[ 2495] = 16'h0000;
    rom[ 2496] = 16'h0000; rom[ 2497] = 16'h0000; rom[ 2498] = 16'h0000; rom[ 2499] = 16'h0000; rom[ 2500] = 16'h0000; rom[ 2501] = 16'h0000; rom[ 2502] = 16'h0000; rom[ 2503] = 16'h00e0;
    rom[ 2504] = 16'h0bf0; rom[ 2505] = 16'h0e30; rom[ 2506] = 16'h0c18; rom[ 2507] = 16'h0c18; rom[ 2508] = 16'h0818; rom[ 2509] = 16'h0818; rom[ 2510] = 16'h0818; rom[ 2511] = 16'h0818;
    rom[ 2512] = 16'h0818; rom[ 2513] = 16'h0c18; rom[ 2514] = 16'h0810; rom[ 2515] = 16'h0000; rom[ 2516] = 16'h0000; rom[ 2517] = 16'h0000; rom[ 2518] = 16'h0000; rom[ 2519] = 16'h0000;
    rom[ 2520] = 16'h0000; rom[ 2521] = 16'h0000; rom[ 2522] = 16'h0000; rom[ 2523] = 16'h0000; rom[ 2524] = 16'h0000; rom[ 2525] = 16'h0000; rom[ 2526] = 16'h0000; rom[ 2527] = 16'h0000;
    rom[ 2528] = 16'h0000; rom[ 2529] = 16'h0000; rom[ 2530] = 16'h0000; rom[ 2531] = 16'h0000; rom[ 2532] = 16'h0000; rom[ 2533] = 16'h0000; rom[ 2534] = 16'h0000; rom[ 2535] = 16'h01c0;
    rom[ 2536] = 16'h07f0; rom[ 2537] = 16'h0c38; rom[ 2538] = 16'h1818; rom[ 2539] = 16'h1818; rom[ 2540] = 16'h1818; rom[ 2541] = 16'h1818; rom[ 2542] = 16'h1818; rom[ 2543] = 16'h1818;
    rom[ 2544] = 16'h1c30; rom[ 2545] = 16'h0ff0; rom[ 2546] = 16'h03c0; rom[ 2547] = 16'h0000; rom[ 2548] = 16'h0000; rom[ 2549] = 16'h0000; rom[ 2550] = 16'h0000; rom[ 2551] = 16'h0000;
    rom[ 2552] = 16'h0000; rom[ 2553] = 16'h0000; rom[ 2554] = 16'h0000; rom[ 2555] = 16'h0000; rom[ 2556] = 16'h0000; rom[ 2557] = 16'h0000; rom[ 2558] = 16'h0000; rom[ 2559] = 16'h0000;
    rom[ 2560] = 16'h0000; rom[ 2561] = 16'h0000; rom[ 2562] = 16'h0000; rom[ 2563] = 16'h0000; rom[ 2564] = 16'h0000; rom[ 2565] = 16'h0000; rom[ 2566] = 16'h0000; rom[ 2567] = 16'h00e0;
    rom[ 2568] = 16'h0bf0; rom[ 2569] = 16'h0e38; rom[ 2570] = 16'h0c18; rom[ 2571] = 16'h0c18; rom[ 2572] = 16'h0818; rom[ 2573] = 16'h0818; rom[ 2574] = 16'h0818; rom[ 2575] = 16'h0818;
    rom[ 2576] = 16'h0c30; rom[ 2577] = 16'h0ff0; rom[ 2578] = 16'h0fc0; rom[ 2579] = 16'h0800; rom[ 2580] = 16'h0800; rom[ 2581] = 16'h0800; rom[ 2582] = 16'h0c00; rom[ 2583] = 16'h0000;
    rom[ 2584] = 16'h0000; rom[ 2585] = 16'h0000; rom[ 2586] = 16'h0000; rom[ 2587] = 16'h0000; rom[ 2588] = 16'h0000; rom[ 2589] = 16'h0000; rom[ 2590] = 16'h0000; rom[ 2591] = 16'h0000;
    rom[ 2592] = 16'h0000; rom[ 2593] = 16'h0000; rom[ 2594] = 16'h0000; rom[ 2595] = 16'h0000; rom[ 2596] = 16'h0000; rom[ 2597] = 16'h0000; rom[ 2598] = 16'h0000; rom[ 2599] = 16'h01d0;
    rom[ 2600] = 16'h07f8; rom[ 2601] = 16'h0c38; rom[ 2602] = 16'h1818; rom[ 2603] = 16'h1818; rom[ 2604] = 16'h1818; rom[ 2605] = 16'h1818; rom[ 2606] = 16'h1818; rom[ 2607] = 16'h1838;
    rom[ 2608] = 16'h1c78; rom[ 2609] = 16'h0fd8; rom[ 2610] = 16'h0798; rom[ 2611] = 16'h0018; rom[ 2612] = 16'h0018; rom[ 2613] = 16'h0018; rom[ 2614] = 16'h0018; rom[ 2615] = 16'h0000;
    rom[ 2616] = 16'h0000; rom[ 2617] = 16'h0000; rom[ 2618] = 16'h0000; rom[ 2619] = 16'h0000; rom[ 2620] = 16'h0000; rom[ 2621] = 16'h0000; rom[ 2622] = 16'h0000; rom[ 2623] = 16'h0000;
    rom[ 2624] = 16'h0000; rom[ 2625] = 16'h0000; rom[ 2626] = 16'h0000; rom[ 2627] = 16'h0000; rom[ 2628] = 16'h0000; rom[ 2629] = 16'h0000; rom[ 2630] = 16'h0000; rom[ 2631] = 16'h0060;
    rom[ 2632] = 16'h0df0; rom[ 2633] = 16'h0f18; rom[ 2634] = 16'h0e18; rom[ 2635] = 16'h0c18; rom[ 2636] = 16'h0c00; rom[ 2637] = 16'h0c00; rom[ 2638] = 16'h0c00; rom[ 2639] = 16'h0c00;
    rom[ 2640] = 16'h0c00; rom[ 2641] = 16'h0c00; rom[ 2642] = 16'h0c00; rom[ 2643] = 16'h0000; rom[ 2644] = 16'h0000; rom[ 2645] = 16'h0000; rom[ 2646] = 16'h0000; rom[ 2647] = 16'h0000;
    rom[ 2648] = 16'h0000; rom[ 2649] = 16'h0000; rom[ 2650] = 16'h0000; rom[ 2651] = 16'h0000; rom[ 2652] = 16'h0000; rom[ 2653] = 16'h0000; rom[ 2654] = 16'h0000; rom[ 2655] = 16'h0000;
    rom[ 2656] = 16'h0000; rom[ 2657] = 16'h0000; rom[ 2658] = 16'h0000; rom[ 2659] = 16'h0000; rom[ 2660] = 16'h0000; rom[ 2661] = 16'h0000; rom[ 2662] = 16'h0000; rom[ 2663] = 16'h01e0;
    rom[ 2664] = 16'h07f0; rom[ 2665] = 16'h0c00; rom[ 2666] = 16'h0c00; rom[ 2667] = 16'h0e00; rom[ 2668] = 16'h0780; rom[ 2669] = 16'h01e0; rom[ 2670] = 16'h0070; rom[ 2671] = 16'h0030;
    rom[ 2672] = 16'h0030; rom[ 2673] = 16'h0ff0; rom[ 2674] = 16'h0fc0; rom[ 2675] = 16'h0000; rom[ 2676] = 16'h0000; rom[ 2677] = 16'h0000; rom[ 2678] = 16'h0000; rom[ 2679] = 16'h0000;
    rom[ 2680] = 16'h0000; rom[ 2681] = 16'h0000; rom[ 2682] = 16'h0000; rom[ 2683] = 16'h0000; rom[ 2684] = 16'h0000; rom[ 2685] = 16'h0000; rom[ 2686] = 16'h0000; rom[ 2687] = 16'h0000;
    rom[ 2688] = 16'h0000; rom[ 2689] = 16'h0000; rom[ 2690] = 16'h0000; rom[ 2691] = 16'h0000; rom[ 2692] = 16'h0300; rom[ 2693] = 16'h0300; rom[ 2694] = 16'h0300; rom[ 2695] = 16'h1740;
    rom[ 2696] = 16'h3ff8; rom[ 2697] = 16'h0300; rom[ 2698] = 16'h0300; rom[ 2699] = 16'h0300; rom[ 2700] = 16'h0300; rom[ 2701] = 16'h0300; rom[ 2702] = 16'h0300; rom[ 2703] = 16'h0300;
    rom[ 2704] = 16'h0300; rom[ 2705] = 16'h03f8; rom[ 2706] = 16'h01f0; rom[ 2707] = 16'h0000; rom[ 2708] = 16'h0000; rom[ 2709] = 16'h0000; rom[ 2710] = 16'h0000; rom[ 2711] = 16'h0000;
    rom[ 2712] = 16'h0000; rom[ 2713] = 16'h0000; rom[ 2714] = 16'h0000; rom[ 2715] = 16'h0000; rom[ 2716] = 16'h0000; rom[ 2717] = 16'h0000; rom[ 2718] = 16'h0000; rom[ 2719] = 16'h0000;
    rom[ 2720] = 16'h0000; rom[ 2721] = 16'h0000; rom[ 2722] = 16'h0000; rom[ 2723] = 16'h0000; rom[ 2724] = 16'h0000; rom[ 2725] = 16'h0000; rom[ 2726] = 16'h0000; rom[ 2727] = 16'h0000;
    rom[ 2728] = 16'h0c18; rom[ 2729] = 16'h0818; rom[ 2730] = 16'h0818; rom[ 2731] = 16'h0818; rom[ 2732] = 16'h0818; rom[ 2733] = 16'h0818; rom[ 2734] = 16'h0818; rom[ 2735] = 16'h0c38;
    rom[ 2736] = 16'h0c78; rom[ 2737] = 16'h0fd8; rom[ 2738] = 16'h0790; rom[ 2739] = 16'h0000; rom[ 2740] = 16'h0000; rom[ 2741] = 16'h0000; rom[ 2742] = 16'h0000; rom[ 2743] = 16'h0000;
    rom[ 2744] = 16'h0000; rom[ 2745] = 16'h0000; rom[ 2746] = 16'h0000; rom[ 2747] = 16'h0000; rom[ 2748] = 16'h0000; rom[ 2749] = 16'h0000; rom[ 2750] = 16'h0000; rom[ 2751] = 16'h0000;
    rom[ 2752] = 16'h0000; rom[ 2753] = 16'h0000; rom[ 2754] = 16'h0000; rom[ 2755] = 16'h0000; rom[ 2756] = 16'h0000; rom[ 2757] = 16'h0000; rom[ 2758] = 16'h0000; rom[ 2759] = 16'h1000;
    rom[ 2760] = 16'h1818; rom[ 2761] = 16'h1818; rom[ 2762] = 16'h0c30; rom[ 2763] = 16'h0c30; rom[ 2764] = 16'h0e30; rom[ 2765] = 16'h0660; rom[ 2766] = 16'h0660; rom[ 2767] = 16'h0340;
    rom[ 2768] = 16'h03c0; rom[ 2769] = 16'h03c0; rom[ 2770] = 16'h0180; rom[ 2771] = 16'h0000; rom[ 2772] = 16'h0000; rom[ 2773] = 16'h0000; rom[ 2774] = 16'h0000; rom[ 2775] = 16'h0000;
    rom[ 2776] = 16'h0000; rom[ 2777] = 16'h0000; rom[ 2778] = 16'h0000; rom[ 2779] = 16'h0000; rom[ 2780] = 16'h0000; rom[ 2781] = 16'h0000; rom[ 2782] = 16'h0000; rom[ 2783] = 16'h0000;
    rom[ 2784] = 16'h0000; rom[ 2785] = 16'h0000; rom[ 2786] = 16'h0000; rom[ 2787] = 16'h0000; rom[ 2788] = 16'h0000; rom[ 2789] = 16'h0000; rom[ 2790] = 16'h0000; rom[ 2791] = 16'h0000;
    rom[ 2792] = 16'h300c; rom[ 2793] = 16'h300c; rom[ 2794] = 16'h118c; rom[ 2795] = 16'h1988; rom[ 2796] = 16'h19d8; rom[ 2797] = 16'h1bd8; rom[ 2798] = 16'h1a58; rom[ 2799] = 16'h1a78;
    rom[ 2800] = 16'h1e78; rom[ 2801] = 16'h0e38; rom[ 2802] = 16'h0c30; rom[ 2803] = 16'h0000; rom[ 2804] = 16'h0000; rom[ 2805] = 16'h0000; rom[ 2806] = 16'h0000; rom[ 2807] = 16'h0000;
    rom[ 2808] = 16'h0000; rom[ 2809] = 16'h0000; rom[ 2810] = 16'h0000; rom[ 2811] = 16'h0000; rom[ 2812] = 16'h0000; rom[ 2813] = 16'h0000; rom[ 2814] = 16'h0000; rom[ 2815] = 16'h0000;
    rom[ 2816] = 16'h0000; rom[ 2817] = 16'h0000; rom[ 2818] = 16'h0000; rom[ 2819] = 16'h0000; rom[ 2820] = 16'h0000; rom[ 2821] = 16'h0000; rom[ 2822] = 16'h0000; rom[ 2823] = 16'h0008;
    rom[ 2824] = 16'h1c38; rom[ 2825] = 16'h0e30; rom[ 2826] = 16'h0660; rom[ 2827] = 16'h03e0; rom[ 2828] = 16'h03c0; rom[ 2829] = 16'h01c0; rom[ 2830] = 16'h03c0; rom[ 2831] = 16'h0660;
    rom[ 2832] = 16'h0e30; rom[ 2833] = 16'h1c38; rom[ 2834] = 16'h1818; rom[ 2835] = 16'h0000; rom[ 2836] = 16'h0000; rom[ 2837] = 16'h0000; rom[ 2838] = 16'h0000; rom[ 2839] = 16'h0000;
    rom[ 2840] = 16'h0000; rom[ 2841] = 16'h0000; rom[ 2842] = 16'h0000; rom[ 2843] = 16'h0000; rom[ 2844] = 16'h0000; rom[ 2845] = 16'h0000; rom[ 2846] = 16'h0000; rom[ 2847] = 16'h0000;
    rom[ 2848] = 16'h0000; rom[ 2849] = 16'h0000; rom[ 2850] = 16'h0000; rom[ 2851] = 16'h0000; rom[ 2852] = 16'h0000; rom[ 2853] = 16'h0000; rom[ 2854] = 16'h0000; rom[ 2855] = 16'h1000;
    rom[ 2856] = 16'h1818; rom[ 2857] = 16'h1818; rom[ 2858] = 16'h0c30; rom[ 2859] = 16'h0c30; rom[ 2860] = 16'h0630; rom[ 2861] = 16'h0660; rom[ 2862] = 16'h0660; rom[ 2863] = 16'h0360;
    rom[ 2864] = 16'h03c0; rom[ 2865] = 16'h03c0; rom[ 2866] = 16'h0180; rom[ 2867] = 16'h0180; rom[ 2868] = 16'h0300; rom[ 2869] = 16'h0700; rom[ 2870] = 16'h3e00; rom[ 2871] = 16'h1000;
    rom[ 2872] = 16'h0000; rom[ 2873] = 16'h0000; rom[ 2874] = 16'h0000; rom[ 2875] = 16'h0000; rom[ 2876] = 16'h0000; rom[ 2877] = 16'h0000; rom[ 2878] = 16'h0000; rom[ 2879] = 16'h0000;
    rom[ 2880] = 16'h0000; rom[ 2881] = 16'h0000; rom[ 2882] = 16'h0000; rom[ 2883] = 16'h0000; rom[ 2884] = 16'h0000; rom[ 2885] = 16'h0000; rom[ 2886] = 16'h0000; rom[ 2887] = 16'h0040;
    rom[ 2888] = 16'h0ff0; rom[ 2889] = 16'h0030; rom[ 2890] = 16'h0060; rom[ 2891] = 16'h00c0; rom[ 2892] = 16'h01c0; rom[ 2893] = 16'h0180; rom[ 2894] = 16'h0300; rom[ 2895] = 16'h0600;
    rom[ 2896] = 16'h0e00; rom[ 2897] = 16'h0ff8; rom[ 2898] = 16'h0ff8; rom[ 2899] = 16'h0000; rom[ 2900] = 16'h0000; rom[ 2901] = 16'h0000; rom[ 2902] = 16'h0000; rom[ 2903] = 16'h0000;
    rom[ 2904] = 16'h0000; rom[ 2905] = 16'h0000; rom[ 2906] = 16'h0000; rom[ 2907] = 16'h0000; rom[ 2908] = 16'h0000; rom[ 2909] = 16'h0000; rom[ 2910] = 16'h0000; rom[ 2911] = 16'h0000;
    rom[ 2912] = 16'h0000; rom[ 2913] = 16'h0000; rom[ 2914] = 16'h0000; rom[ 2915] = 16'h00f0; rom[ 2916] = 16'h0180; rom[ 2917] = 16'h0180; rom[ 2918] = 16'h0180; rom[ 2919] = 16'h0180;
    rom[ 2920] = 16'h0180; rom[ 2921] = 16'h0180; rom[ 2922] = 16'h0100; rom[ 2923] = 16'h0700; rom[ 2924] = 16'h0e00; rom[ 2925] = 16'h0300; rom[ 2926] = 16'h0100; rom[ 2927] = 16'h0180;
    rom[ 2928] = 16'h0180; rom[ 2929] = 16'h0180; rom[ 2930] = 16'h0180; rom[ 2931] = 16'h0180; rom[ 2932] = 16'h0180; rom[ 2933] = 16'h01c0; rom[ 2934] = 16'h00f0; rom[ 2935] = 16'h0000;
    rom[ 2936] = 16'h0000; rom[ 2937] = 16'h0000; rom[ 2938] = 16'h0000; rom[ 2939] = 16'h0000; rom[ 2940] = 16'h0000; rom[ 2941] = 16'h0000; rom[ 2942] = 16'h0000; rom[ 2943] = 16'h0000;
    rom[ 2944] = 16'h0180; rom[ 2945] = 16'h0180; rom[ 2946] = 16'h0180; rom[ 2947] = 16'h0180; rom[ 2948] = 16'h0180; rom[ 2949] = 16'h0180; rom[ 2950] = 16'h0180; rom[ 2951] = 16'h0180;
    rom[ 2952] = 16'h0180; rom[ 2953] = 16'h0180; rom[ 2954] = 16'h0180; rom[ 2955] = 16'h0180; rom[ 2956] = 16'h0180; rom[ 2957] = 16'h0180; rom[ 2958] = 16'h0180; rom[ 2959] = 16'h0180;
    rom[ 2960] = 16'h0180; rom[ 2961] = 16'h0180; rom[ 2962] = 16'h0180; rom[ 2963] = 16'h0180; rom[ 2964] = 16'h0180; rom[ 2965] = 16'h0180; rom[ 2966] = 16'h0180; rom[ 2967] = 16'h0000;
    rom[ 2968] = 16'h0000; rom[ 2969] = 16'h0000; rom[ 2970] = 16'h0000; rom[ 2971] = 16'h0000; rom[ 2972] = 16'h0000; rom[ 2973] = 16'h0000; rom[ 2974] = 16'h0000; rom[ 2975] = 16'h0000;
    rom[ 2976] = 16'h0000; rom[ 2977] = 16'h0000; rom[ 2978] = 16'h0400; rom[ 2979] = 16'h0f00; rom[ 2980] = 16'h0180; rom[ 2981] = 16'h0180; rom[ 2982] = 16'h0080; rom[ 2983] = 16'h0080;
    rom[ 2984] = 16'h0080; rom[ 2985] = 16'h0080; rom[ 2986] = 16'h00c0; rom[ 2987] = 16'h00e0; rom[ 2988] = 16'h0078; rom[ 2989] = 16'h00c0; rom[ 2990] = 16'h00c0; rom[ 2991] = 16'h0080;
    rom[ 2992] = 16'h0080; rom[ 2993] = 16'h0080; rom[ 2994] = 16'h0080; rom[ 2995] = 16'h0080; rom[ 2996] = 16'h0180; rom[ 2997] = 16'h0380; rom[ 2998] = 16'h0f00; rom[ 2999] = 16'h0000;
    rom[ 3000] = 16'h0000; rom[ 3001] = 16'h0000; rom[ 3002] = 16'h0000; rom[ 3003] = 16'h0000; rom[ 3004] = 16'h0000; rom[ 3005] = 16'h0000; rom[ 3006] = 16'h0000; rom[ 3007] = 16'h0000;
    rom[ 3008] = 16'h0000; rom[ 3009] = 16'h0000; rom[ 3010] = 16'h0000; rom[ 3011] = 16'h0000; rom[ 3012] = 16'h0000; rom[ 3013] = 16'h0000; rom[ 3014] = 16'h0000; rom[ 3015] = 16'h0000;
    rom[ 3016] = 16'h0000; rom[ 3017] = 16'h0000; rom[ 3018] = 16'h0e00; rom[ 3019] = 16'h1f0c; rom[ 3020] = 16'h1988; rom[ 3021] = 16'h10f8; rom[ 3022] = 16'h0070; rom[ 3023] = 16'h0000;
    rom[ 3024] = 16'h0000; rom[ 3025] = 16'h0000; rom[ 3026] = 16'h0000; rom[ 3027] = 16'h0000; rom[ 3028] = 16'h0000; rom[ 3029] = 16'h0000; rom[ 3030] = 16'h0000; rom[ 3031] = 16'h0000;
    rom[ 3032] = 16'h0000; rom[ 3033] = 16'h0000; rom[ 3034] = 16'h0000; rom[ 3035] = 16'h0000; rom[ 3036] = 16'h0000; rom[ 3037] = 16'h0000; rom[ 3038] = 16'h0000; rom[ 3039] = 16'h0000;
    rom[ 3040] = 16'h0000; rom[ 3041] = 16'h0000; rom[ 3042] = 16'h0000; rom[ 3043] = 16'h0000; rom[ 3044] = 16'h0000; rom[ 3045] = 16'h0000; rom[ 3046] = 16'h0000; rom[ 3047] = 16'h0000;
    rom[ 3048] = 16'h0000; rom[ 3049] = 16'h0000; rom[ 3050] = 16'h0000; rom[ 3051] = 16'h0000; rom[ 3052] = 16'h0000; rom[ 3053] = 16'h0000; rom[ 3054] = 16'h0000; rom[ 3055] = 16'h0000;
    rom[ 3056] = 16'h0000; rom[ 3057] = 16'h0000; rom[ 3058] = 16'h0000; rom[ 3059] = 16'h0000; rom[ 3060] = 16'h0000; rom[ 3061] = 16'h0000; rom[ 3062] = 16'h0000; rom[ 3063] = 16'h0000;
    rom[ 3064] = 16'h0000; rom[ 3065] = 16'h0000; rom[ 3066] = 16'h0000; rom[ 3067] = 16'h0000; rom[ 3068] = 16'h0000; rom[ 3069] = 16'h0000; rom[ 3070] = 16'h0000; rom[ 3071] = 16'h0000;
    rom[ 3072] = 16'h0000; rom[ 3073] = 16'h0000; rom[ 3074] = 16'h0000; rom[ 3075] = 16'h0000; rom[ 3076] = 16'h0000; rom[ 3077] = 16'h0000; rom[ 3078] = 16'h0000; rom[ 3079] = 16'h0000;
    rom[ 3080] = 16'h0000; rom[ 3081] = 16'h0000; rom[ 3082] = 16'h0000; rom[ 3083] = 16'h0000; rom[ 3084] = 16'h0000; rom[ 3085] = 16'h0000; rom[ 3086] = 16'h0000; rom[ 3087] = 16'h0000;
    rom[ 3088] = 16'h0000; rom[ 3089] = 16'h0000; rom[ 3090] = 16'h0000; rom[ 3091] = 16'h0000; rom[ 3092] = 16'h0000; rom[ 3093] = 16'h0000; rom[ 3094] = 16'h0000; rom[ 3095] = 16'h0000;
    rom[ 3096] = 16'h0000; rom[ 3097] = 16'h0000; rom[ 3098] = 16'h0000; rom[ 3099] = 16'h0000; rom[ 3100] = 16'h0000; rom[ 3101] = 16'h0000; rom[ 3102] = 16'h0000; rom[ 3103] = 16'h0000;
    rom[ 3104] = 16'h0000; rom[ 3105] = 16'h0000; rom[ 3106] = 16'h0000; rom[ 3107] = 16'h0000; rom[ 3108] = 16'h0000; rom[ 3109] = 16'h0000; rom[ 3110] = 16'h0000; rom[ 3111] = 16'h0000;
    rom[ 3112] = 16'h0000; rom[ 3113] = 16'h0000; rom[ 3114] = 16'h0000; rom[ 3115] = 16'h0000; rom[ 3116] = 16'h0000; rom[ 3117] = 16'h0000; rom[ 3118] = 16'h0000; rom[ 3119] = 16'h0000;
    rom[ 3120] = 16'h0000; rom[ 3121] = 16'h0000; rom[ 3122] = 16'h0000; rom[ 3123] = 16'h0000; rom[ 3124] = 16'h0000; rom[ 3125] = 16'h0000; rom[ 3126] = 16'h0000; rom[ 3127] = 16'h0000;
    rom[ 3128] = 16'h0000; rom[ 3129] = 16'h0000; rom[ 3130] = 16'h0000; rom[ 3131] = 16'h0000; rom[ 3132] = 16'h0000; rom[ 3133] = 16'h0000; rom[ 3134] = 16'h0000; rom[ 3135] = 16'h0000;
    rom[ 3136] = 16'h0000; rom[ 3137] = 16'h0000; rom[ 3138] = 16'h0000; rom[ 3139] = 16'h0000; rom[ 3140] = 16'h0000; rom[ 3141] = 16'h0000; rom[ 3142] = 16'h0000; rom[ 3143] = 16'h0000;
    rom[ 3144] = 16'h0000; rom[ 3145] = 16'h0000; rom[ 3146] = 16'h0000; rom[ 3147] = 16'h0000; rom[ 3148] = 16'h0000; rom[ 3149] = 16'h0000; rom[ 3150] = 16'h0000; rom[ 3151] = 16'h0000;
    rom[ 3152] = 16'h0000; rom[ 3153] = 16'h0000; rom[ 3154] = 16'h0000; rom[ 3155] = 16'h0000; rom[ 3156] = 16'h0000; rom[ 3157] = 16'h0000; rom[ 3158] = 16'h0000; rom[ 3159] = 16'h0000;
    rom[ 3160] = 16'h0000; rom[ 3161] = 16'h0000; rom[ 3162] = 16'h0000; rom[ 3163] = 16'h0000; rom[ 3164] = 16'h0000; rom[ 3165] = 16'h0000; rom[ 3166] = 16'h0000; rom[ 3167] = 16'h0000;
    rom[ 3168] = 16'h0000; rom[ 3169] = 16'h0000; rom[ 3170] = 16'h0000; rom[ 3171] = 16'h0000; rom[ 3172] = 16'h0000; rom[ 3173] = 16'h0000; rom[ 3174] = 16'h0000; rom[ 3175] = 16'h0000;
    rom[ 3176] = 16'h0000; rom[ 3177] = 16'h0000; rom[ 3178] = 16'h0000; rom[ 3179] = 16'h0000; rom[ 3180] = 16'h0000; rom[ 3181] = 16'h0000; rom[ 3182] = 16'h0000; rom[ 3183] = 16'h0000;
    rom[ 3184] = 16'h0000; rom[ 3185] = 16'h0000; rom[ 3186] = 16'h0000; rom[ 3187] = 16'h0000; rom[ 3188] = 16'h0000; rom[ 3189] = 16'h0000; rom[ 3190] = 16'h0000; rom[ 3191] = 16'h0000;
    rom[ 3192] = 16'h0000; rom[ 3193] = 16'h0000; rom[ 3194] = 16'h0000; rom[ 3195] = 16'h0000; rom[ 3196] = 16'h0000; rom[ 3197] = 16'h0000; rom[ 3198] = 16'h0000; rom[ 3199] = 16'h0000;
    rom[ 3200] = 16'h0000; rom[ 3201] = 16'h0000; rom[ 3202] = 16'h0000; rom[ 3203] = 16'h0000; rom[ 3204] = 16'h0000; rom[ 3205] = 16'h0000; rom[ 3206] = 16'h0000; rom[ 3207] = 16'h0000;
    rom[ 3208] = 16'h0000; rom[ 3209] = 16'h0000; rom[ 3210] = 16'h0000; rom[ 3211] = 16'h0000; rom[ 3212] = 16'h0000; rom[ 3213] = 16'h0000; rom[ 3214] = 16'h0000; rom[ 3215] = 16'h0000;
    rom[ 3216] = 16'h0000; rom[ 3217] = 16'h0000; rom[ 3218] = 16'h0000; rom[ 3219] = 16'h0000; rom[ 3220] = 16'h0000; rom[ 3221] = 16'h0000; rom[ 3222] = 16'h0000; rom[ 3223] = 16'h0000;
    rom[ 3224] = 16'h0000; rom[ 3225] = 16'h0000; rom[ 3226] = 16'h0000; rom[ 3227] = 16'h0000; rom[ 3228] = 16'h0000; rom[ 3229] = 16'h0000; rom[ 3230] = 16'h0000; rom[ 3231] = 16'h0000;
    rom[ 3232] = 16'h0000; rom[ 3233] = 16'h0000; rom[ 3234] = 16'h0000; rom[ 3235] = 16'h0000; rom[ 3236] = 16'h0000; rom[ 3237] = 16'h0000; rom[ 3238] = 16'h0000; rom[ 3239] = 16'h0000;
    rom[ 3240] = 16'h0000; rom[ 3241] = 16'h0000; rom[ 3242] = 16'h0000; rom[ 3243] = 16'h0000; rom[ 3244] = 16'h0000; rom[ 3245] = 16'h0000; rom[ 3246] = 16'h0000; rom[ 3247] = 16'h0000;
    rom[ 3248] = 16'h0000; rom[ 3249] = 16'h0000; rom[ 3250] = 16'h0000; rom[ 3251] = 16'h0000; rom[ 3252] = 16'h0000; rom[ 3253] = 16'h0000; rom[ 3254] = 16'h0000; rom[ 3255] = 16'h0000;
    rom[ 3256] = 16'h0000; rom[ 3257] = 16'h0000; rom[ 3258] = 16'h0000; rom[ 3259] = 16'h0000; rom[ 3260] = 16'h0000; rom[ 3261] = 16'h0000; rom[ 3262] = 16'h0000; rom[ 3263] = 16'h0000;
    rom[ 3264] = 16'h0000; rom[ 3265] = 16'h0000; rom[ 3266] = 16'h0000; rom[ 3267] = 16'h0000; rom[ 3268] = 16'h0000; rom[ 3269] = 16'h0000; rom[ 3270] = 16'h0000; rom[ 3271] = 16'h0000;
    rom[ 3272] = 16'h0000; rom[ 3273] = 16'h0000; rom[ 3274] = 16'h0000; rom[ 3275] = 16'h0000; rom[ 3276] = 16'h0000; rom[ 3277] = 16'h0000; rom[ 3278] = 16'h0000; rom[ 3279] = 16'h0000;
    rom[ 3280] = 16'h0000; rom[ 3281] = 16'h0000; rom[ 3282] = 16'h0000; rom[ 3283] = 16'h0000; rom[ 3284] = 16'h0000; rom[ 3285] = 16'h0000; rom[ 3286] = 16'h0000; rom[ 3287] = 16'h0000;
    rom[ 3288] = 16'h0000; rom[ 3289] = 16'h0000; rom[ 3290] = 16'h0000; rom[ 3291] = 16'h0000; rom[ 3292] = 16'h0000; rom[ 3293] = 16'h0000; rom[ 3294] = 16'h0000; rom[ 3295] = 16'h0000;
    rom[ 3296] = 16'h0000; rom[ 3297] = 16'h0000; rom[ 3298] = 16'h0000; rom[ 3299] = 16'h0000; rom[ 3300] = 16'h0000; rom[ 3301] = 16'h0000; rom[ 3302] = 16'h0000; rom[ 3303] = 16'h0000;
    rom[ 3304] = 16'h0000; rom[ 3305] = 16'h0000; rom[ 3306] = 16'h0000; rom[ 3307] = 16'h0000; rom[ 3308] = 16'h0000; rom[ 3309] = 16'h0000; rom[ 3310] = 16'h0000; rom[ 3311] = 16'h0000;
    rom[ 3312] = 16'h0000; rom[ 3313] = 16'h0000; rom[ 3314] = 16'h0000; rom[ 3315] = 16'h0000; rom[ 3316] = 16'h0000; rom[ 3317] = 16'h0000; rom[ 3318] = 16'h0000; rom[ 3319] = 16'h0000;
    rom[ 3320] = 16'h0000; rom[ 3321] = 16'h0000; rom[ 3322] = 16'h0000; rom[ 3323] = 16'h0000; rom[ 3324] = 16'h0000; rom[ 3325] = 16'h0000; rom[ 3326] = 16'h0000; rom[ 3327] = 16'h0000;
    rom[ 3328] = 16'h0000; rom[ 3329] = 16'h0000; rom[ 3330] = 16'h0000; rom[ 3331] = 16'h0000; rom[ 3332] = 16'h0000; rom[ 3333] = 16'h0000; rom[ 3334] = 16'h0000; rom[ 3335] = 16'h0000;
    rom[ 3336] = 16'h0000; rom[ 3337] = 16'h0000; rom[ 3338] = 16'h0000; rom[ 3339] = 16'h0000; rom[ 3340] = 16'h0000; rom[ 3341] = 16'h0000; rom[ 3342] = 16'h0000; rom[ 3343] = 16'h0000;
    rom[ 3344] = 16'h0000; rom[ 3345] = 16'h0000; rom[ 3346] = 16'h0000; rom[ 3347] = 16'h0000; rom[ 3348] = 16'h0000; rom[ 3349] = 16'h0000; rom[ 3350] = 16'h0000; rom[ 3351] = 16'h0000;
    rom[ 3352] = 16'h0000; rom[ 3353] = 16'h0000; rom[ 3354] = 16'h0000; rom[ 3355] = 16'h0000; rom[ 3356] = 16'h0000; rom[ 3357] = 16'h0000; rom[ 3358] = 16'h0000; rom[ 3359] = 16'h0000;
    rom[ 3360] = 16'h0000; rom[ 3361] = 16'h0000; rom[ 3362] = 16'h0000; rom[ 3363] = 16'h0000; rom[ 3364] = 16'h0000; rom[ 3365] = 16'h0000; rom[ 3366] = 16'h0000; rom[ 3367] = 16'h0000;
    rom[ 3368] = 16'h0000; rom[ 3369] = 16'h0000; rom[ 3370] = 16'h0000; rom[ 3371] = 16'h0000; rom[ 3372] = 16'h0000; rom[ 3373] = 16'h0000; rom[ 3374] = 16'h0000; rom[ 3375] = 16'h0000;
    rom[ 3376] = 16'h0000; rom[ 3377] = 16'h0000; rom[ 3378] = 16'h0000; rom[ 3379] = 16'h0000; rom[ 3380] = 16'h0000; rom[ 3381] = 16'h0000; rom[ 3382] = 16'h0000; rom[ 3383] = 16'h0000;
    rom[ 3384] = 16'h0000; rom[ 3385] = 16'h0000; rom[ 3386] = 16'h0000; rom[ 3387] = 16'h0000; rom[ 3388] = 16'h0000; rom[ 3389] = 16'h0000; rom[ 3390] = 16'h0000; rom[ 3391] = 16'h0000;
    rom[ 3392] = 16'h0000; rom[ 3393] = 16'h0000; rom[ 3394] = 16'h0000; rom[ 3395] = 16'h0000; rom[ 3396] = 16'h0000; rom[ 3397] = 16'h0000; rom[ 3398] = 16'h0000; rom[ 3399] = 16'h0000;
    rom[ 3400] = 16'h0000; rom[ 3401] = 16'h0000; rom[ 3402] = 16'h0000; rom[ 3403] = 16'h0000; rom[ 3404] = 16'h0000; rom[ 3405] = 16'h0000; rom[ 3406] = 16'h0000; rom[ 3407] = 16'h0000;
    rom[ 3408] = 16'h0000; rom[ 3409] = 16'h0000; rom[ 3410] = 16'h0000; rom[ 3411] = 16'h0000; rom[ 3412] = 16'h0000; rom[ 3413] = 16'h0000; rom[ 3414] = 16'h0000; rom[ 3415] = 16'h0000;
    rom[ 3416] = 16'h0000; rom[ 3417] = 16'h0000; rom[ 3418] = 16'h0000; rom[ 3419] = 16'h0000; rom[ 3420] = 16'h0000; rom[ 3421] = 16'h0000; rom[ 3422] = 16'h0000; rom[ 3423] = 16'h0000;
    rom[ 3424] = 16'h0000; rom[ 3425] = 16'h0000; rom[ 3426] = 16'h0000; rom[ 3427] = 16'h0000; rom[ 3428] = 16'h0000; rom[ 3429] = 16'h0000; rom[ 3430] = 16'h0000; rom[ 3431] = 16'h0000;
    rom[ 3432] = 16'h0000; rom[ 3433] = 16'h0000; rom[ 3434] = 16'h0000; rom[ 3435] = 16'h0000; rom[ 3436] = 16'h0000; rom[ 3437] = 16'h0000; rom[ 3438] = 16'h0000; rom[ 3439] = 16'h0000;
    rom[ 3440] = 16'h0000; rom[ 3441] = 16'h0000; rom[ 3442] = 16'h0000; rom[ 3443] = 16'h0000; rom[ 3444] = 16'h0000; rom[ 3445] = 16'h0000; rom[ 3446] = 16'h0000; rom[ 3447] = 16'h0000;
    rom[ 3448] = 16'h0000; rom[ 3449] = 16'h0000; rom[ 3450] = 16'h0000; rom[ 3451] = 16'h0000; rom[ 3452] = 16'h0000; rom[ 3453] = 16'h0000; rom[ 3454] = 16'h0000; rom[ 3455] = 16'h0000;
    rom[ 3456] = 16'h0000; rom[ 3457] = 16'h0000; rom[ 3458] = 16'h0000; rom[ 3459] = 16'h0000; rom[ 3460] = 16'h0000; rom[ 3461] = 16'h0000; rom[ 3462] = 16'h0000; rom[ 3463] = 16'h0000;
    rom[ 3464] = 16'h0000; rom[ 3465] = 16'h0000; rom[ 3466] = 16'h0000; rom[ 3467] = 16'h0000; rom[ 3468] = 16'h0000; rom[ 3469] = 16'h0000; rom[ 3470] = 16'h0000; rom[ 3471] = 16'h0000;
    rom[ 3472] = 16'h0000; rom[ 3473] = 16'h0000; rom[ 3474] = 16'h0000; rom[ 3475] = 16'h0000; rom[ 3476] = 16'h0000; rom[ 3477] = 16'h0000; rom[ 3478] = 16'h0000; rom[ 3479] = 16'h0000;
    rom[ 3480] = 16'h0000; rom[ 3481] = 16'h0000; rom[ 3482] = 16'h0000; rom[ 3483] = 16'h0000; rom[ 3484] = 16'h0000; rom[ 3485] = 16'h0000; rom[ 3486] = 16'h0000; rom[ 3487] = 16'h0000;
    rom[ 3488] = 16'h0000; rom[ 3489] = 16'h0000; rom[ 3490] = 16'h0000; rom[ 3491] = 16'h0000; rom[ 3492] = 16'h0000; rom[ 3493] = 16'h0000; rom[ 3494] = 16'h0000; rom[ 3495] = 16'h0000;
    rom[ 3496] = 16'h0000; rom[ 3497] = 16'h0000; rom[ 3498] = 16'h0000; rom[ 3499] = 16'h0000; rom[ 3500] = 16'h0000; rom[ 3501] = 16'h0000; rom[ 3502] = 16'h0000; rom[ 3503] = 16'h0000;
    rom[ 3504] = 16'h0000; rom[ 3505] = 16'h0000; rom[ 3506] = 16'h0000; rom[ 3507] = 16'h0000; rom[ 3508] = 16'h0000; rom[ 3509] = 16'h0000; rom[ 3510] = 16'h0000; rom[ 3511] = 16'h0000;
    rom[ 3512] = 16'h0000; rom[ 3513] = 16'h0000; rom[ 3514] = 16'h0000; rom[ 3515] = 16'h0000; rom[ 3516] = 16'h0000; rom[ 3517] = 16'h0000; rom[ 3518] = 16'h0000; rom[ 3519] = 16'h0000;
    rom[ 3520] = 16'h0000; rom[ 3521] = 16'h0000; rom[ 3522] = 16'h0000; rom[ 3523] = 16'h0000; rom[ 3524] = 16'h0000; rom[ 3525] = 16'h0000; rom[ 3526] = 16'h0000; rom[ 3527] = 16'h0000;
    rom[ 3528] = 16'h0000; rom[ 3529] = 16'h0000; rom[ 3530] = 16'h0000; rom[ 3531] = 16'h0000; rom[ 3532] = 16'h0000; rom[ 3533] = 16'h0000; rom[ 3534] = 16'h0000; rom[ 3535] = 16'h0000;
    rom[ 3536] = 16'h0000; rom[ 3537] = 16'h0000; rom[ 3538] = 16'h0000; rom[ 3539] = 16'h0000; rom[ 3540] = 16'h0000; rom[ 3541] = 16'h0000; rom[ 3542] = 16'h0000; rom[ 3543] = 16'h0000;
    rom[ 3544] = 16'h0000; rom[ 3545] = 16'h0000; rom[ 3546] = 16'h0000; rom[ 3547] = 16'h0000; rom[ 3548] = 16'h0000; rom[ 3549] = 16'h0000; rom[ 3550] = 16'h0000; rom[ 3551] = 16'h0000;
    rom[ 3552] = 16'h0000; rom[ 3553] = 16'h0000; rom[ 3554] = 16'h0000; rom[ 3555] = 16'h0000; rom[ 3556] = 16'h0000; rom[ 3557] = 16'h0000; rom[ 3558] = 16'h0000; rom[ 3559] = 16'h0000;
    rom[ 3560] = 16'h0000; rom[ 3561] = 16'h0000; rom[ 3562] = 16'h0000; rom[ 3563] = 16'h0000; rom[ 3564] = 16'h0000; rom[ 3565] = 16'h0000; rom[ 3566] = 16'h0000; rom[ 3567] = 16'h0000;
    rom[ 3568] = 16'h0000; rom[ 3569] = 16'h0000; rom[ 3570] = 16'h0000; rom[ 3571] = 16'h0000; rom[ 3572] = 16'h0000; rom[ 3573] = 16'h0000; rom[ 3574] = 16'h0000; rom[ 3575] = 16'h0000;
    rom[ 3576] = 16'h0000; rom[ 3577] = 16'h0000; rom[ 3578] = 16'h0000; rom[ 3579] = 16'h0000; rom[ 3580] = 16'h0000; rom[ 3581] = 16'h0000; rom[ 3582] = 16'h0000; rom[ 3583] = 16'h0000;
    rom[ 3584] = 16'h0000; rom[ 3585] = 16'h0000; rom[ 3586] = 16'h0000; rom[ 3587] = 16'h0000; rom[ 3588] = 16'h0000; rom[ 3589] = 16'h0000; rom[ 3590] = 16'h0000; rom[ 3591] = 16'h0000;
    rom[ 3592] = 16'h0000; rom[ 3593] = 16'h0000; rom[ 3594] = 16'h0000; rom[ 3595] = 16'h0000; rom[ 3596] = 16'h0000; rom[ 3597] = 16'h0000; rom[ 3598] = 16'h0000; rom[ 3599] = 16'h0000;
    rom[ 3600] = 16'h0000; rom[ 3601] = 16'h0000; rom[ 3602] = 16'h0000; rom[ 3603] = 16'h0000; rom[ 3604] = 16'h0000; rom[ 3605] = 16'h0000; rom[ 3606] = 16'h0000; rom[ 3607] = 16'h0000;
    rom[ 3608] = 16'h0000; rom[ 3609] = 16'h0000; rom[ 3610] = 16'h0000; rom[ 3611] = 16'h0000; rom[ 3612] = 16'h0000; rom[ 3613] = 16'h0000; rom[ 3614] = 16'h0000; rom[ 3615] = 16'h0000;
    rom[ 3616] = 16'h0000; rom[ 3617] = 16'h0000; rom[ 3618] = 16'h0000; rom[ 3619] = 16'h0000; rom[ 3620] = 16'h0000; rom[ 3621] = 16'h0000; rom[ 3622] = 16'h0000; rom[ 3623] = 16'h0000;
    rom[ 3624] = 16'h0000; rom[ 3625] = 16'h0000; rom[ 3626] = 16'h0000; rom[ 3627] = 16'h0000; rom[ 3628] = 16'h0000; rom[ 3629] = 16'h0000; rom[ 3630] = 16'h0000; rom[ 3631] = 16'h0000;
    rom[ 3632] = 16'h0000; rom[ 3633] = 16'h0000; rom[ 3634] = 16'h0000; rom[ 3635] = 16'h0000; rom[ 3636] = 16'h0000; rom[ 3637] = 16'h0000; rom[ 3638] = 16'h0000; rom[ 3639] = 16'h0000;
    rom[ 3640] = 16'h0000; rom[ 3641] = 16'h0000; rom[ 3642] = 16'h0000; rom[ 3643] = 16'h0000; rom[ 3644] = 16'h0000; rom[ 3645] = 16'h0000; rom[ 3646] = 16'h0000; rom[ 3647] = 16'h0000;
    rom[ 3648] = 16'h0000; rom[ 3649] = 16'h0000; rom[ 3650] = 16'h0000; rom[ 3651] = 16'h0000; rom[ 3652] = 16'h0000; rom[ 3653] = 16'h0000; rom[ 3654] = 16'h0000; rom[ 3655] = 16'h0000;
    rom[ 3656] = 16'h0000; rom[ 3657] = 16'h0000; rom[ 3658] = 16'h0000; rom[ 3659] = 16'h0000; rom[ 3660] = 16'h0000; rom[ 3661] = 16'h0000; rom[ 3662] = 16'h0000; rom[ 3663] = 16'h0000;
    rom[ 3664] = 16'h0000; rom[ 3665] = 16'h0000; rom[ 3666] = 16'h0000; rom[ 3667] = 16'h0000; rom[ 3668] = 16'h0000; rom[ 3669] = 16'h0000; rom[ 3670] = 16'h0000; rom[ 3671] = 16'h0000;
    rom[ 3672] = 16'h0000; rom[ 3673] = 16'h0000; rom[ 3674] = 16'h0000; rom[ 3675] = 16'h0000; rom[ 3676] = 16'h0000; rom[ 3677] = 16'h0000; rom[ 3678] = 16'h0000; rom[ 3679] = 16'h0000;
    rom[ 3680] = 16'h0000; rom[ 3681] = 16'h0000; rom[ 3682] = 16'h0000; rom[ 3683] = 16'h0000; rom[ 3684] = 16'h0000; rom[ 3685] = 16'h0000; rom[ 3686] = 16'h0000; rom[ 3687] = 16'h0000;
    rom[ 3688] = 16'h0000; rom[ 3689] = 16'h0000; rom[ 3690] = 16'h0000; rom[ 3691] = 16'h0000; rom[ 3692] = 16'h0000; rom[ 3693] = 16'h0000; rom[ 3694] = 16'h0000; rom[ 3695] = 16'h0000;
    rom[ 3696] = 16'h0000; rom[ 3697] = 16'h0000; rom[ 3698] = 16'h0000; rom[ 3699] = 16'h0000; rom[ 3700] = 16'h0000; rom[ 3701] = 16'h0000; rom[ 3702] = 16'h0000; rom[ 3703] = 16'h0000;
    rom[ 3704] = 16'h0000; rom[ 3705] = 16'h0000; rom[ 3706] = 16'h0000; rom[ 3707] = 16'h0000; rom[ 3708] = 16'h0000; rom[ 3709] = 16'h0000; rom[ 3710] = 16'h0000; rom[ 3711] = 16'h0000;
    rom[ 3712] = 16'h0000; rom[ 3713] = 16'h0000; rom[ 3714] = 16'h0000; rom[ 3715] = 16'h0000; rom[ 3716] = 16'h0000; rom[ 3717] = 16'h0000; rom[ 3718] = 16'h0000; rom[ 3719] = 16'h0000;
    rom[ 3720] = 16'h0000; rom[ 3721] = 16'h0000; rom[ 3722] = 16'h0000; rom[ 3723] = 16'h0000; rom[ 3724] = 16'h0000; rom[ 3725] = 16'h0000; rom[ 3726] = 16'h0000; rom[ 3727] = 16'h0000;
    rom[ 3728] = 16'h0000; rom[ 3729] = 16'h0000; rom[ 3730] = 16'h0000; rom[ 3731] = 16'h0000; rom[ 3732] = 16'h0000; rom[ 3733] = 16'h0000; rom[ 3734] = 16'h0000; rom[ 3735] = 16'h0000;
    rom[ 3736] = 16'h0000; rom[ 3737] = 16'h0000; rom[ 3738] = 16'h0000; rom[ 3739] = 16'h0000; rom[ 3740] = 16'h0000; rom[ 3741] = 16'h0000; rom[ 3742] = 16'h0000; rom[ 3743] = 16'h0000;
    rom[ 3744] = 16'h0000; rom[ 3745] = 16'h0000; rom[ 3746] = 16'h0000; rom[ 3747] = 16'h0000; rom[ 3748] = 16'h0000; rom[ 3749] = 16'h0000; rom[ 3750] = 16'h0000; rom[ 3751] = 16'h0000;
    rom[ 3752] = 16'h0000; rom[ 3753] = 16'h0000; rom[ 3754] = 16'h0000; rom[ 3755] = 16'h0000; rom[ 3756] = 16'h0000; rom[ 3757] = 16'h0000; rom[ 3758] = 16'h0000; rom[ 3759] = 16'h0000;
    rom[ 3760] = 16'h0000; rom[ 3761] = 16'h0000; rom[ 3762] = 16'h0000; rom[ 3763] = 16'h0000; rom[ 3764] = 16'h0000; rom[ 3765] = 16'h0000; rom[ 3766] = 16'h0000; rom[ 3767] = 16'h0000;
    rom[ 3768] = 16'h0000; rom[ 3769] = 16'h0000; rom[ 3770] = 16'h0000; rom[ 3771] = 16'h0000; rom[ 3772] = 16'h0000; rom[ 3773] = 16'h0000; rom[ 3774] = 16'h0000; rom[ 3775] = 16'h0000;
    rom[ 3776] = 16'h0000; rom[ 3777] = 16'h0000; rom[ 3778] = 16'h0000; rom[ 3779] = 16'h0000; rom[ 3780] = 16'h0000; rom[ 3781] = 16'h0000; rom[ 3782] = 16'h0000; rom[ 3783] = 16'h0000;
    rom[ 3784] = 16'h0000; rom[ 3785] = 16'h0000; rom[ 3786] = 16'h0000; rom[ 3787] = 16'h0000; rom[ 3788] = 16'h0000; rom[ 3789] = 16'h0000; rom[ 3790] = 16'h0000; rom[ 3791] = 16'h0000;
    rom[ 3792] = 16'h0000; rom[ 3793] = 16'h0000; rom[ 3794] = 16'h0000; rom[ 3795] = 16'h0000; rom[ 3796] = 16'h0000; rom[ 3797] = 16'h0000; rom[ 3798] = 16'h0000; rom[ 3799] = 16'h0000;
    rom[ 3800] = 16'h0000; rom[ 3801] = 16'h0000; rom[ 3802] = 16'h0000; rom[ 3803] = 16'h0000; rom[ 3804] = 16'h0000; rom[ 3805] = 16'h0000; rom[ 3806] = 16'h0000; rom[ 3807] = 16'h0000;
    rom[ 3808] = 16'h0000; rom[ 3809] = 16'h0000; rom[ 3810] = 16'h0000; rom[ 3811] = 16'h0000; rom[ 3812] = 16'h0000; rom[ 3813] = 16'h0000; rom[ 3814] = 16'h0000; rom[ 3815] = 16'h0000;
    rom[ 3816] = 16'h0000; rom[ 3817] = 16'h0000; rom[ 3818] = 16'h0000; rom[ 3819] = 16'h0000; rom[ 3820] = 16'h0000; rom[ 3821] = 16'h0000; rom[ 3822] = 16'h0000; rom[ 3823] = 16'h0000;
    rom[ 3824] = 16'h0000; rom[ 3825] = 16'h0000; rom[ 3826] = 16'h0000; rom[ 3827] = 16'h0000; rom[ 3828] = 16'h0000; rom[ 3829] = 16'h0000; rom[ 3830] = 16'h0000; rom[ 3831] = 16'h0000;
    rom[ 3832] = 16'h0000; rom[ 3833] = 16'h0000; rom[ 3834] = 16'h0000; rom[ 3835] = 16'h0000; rom[ 3836] = 16'h0000; rom[ 3837] = 16'h0000; rom[ 3838] = 16'h0000; rom[ 3839] = 16'h0000;
    rom[ 3840] = 16'h0000; rom[ 3841] = 16'h0000; rom[ 3842] = 16'h0000; rom[ 3843] = 16'h0000; rom[ 3844] = 16'h0000; rom[ 3845] = 16'h0000; rom[ 3846] = 16'h0000; rom[ 3847] = 16'h0000;
    rom[ 3848] = 16'h0000; rom[ 3849] = 16'h0000; rom[ 3850] = 16'h0000; rom[ 3851] = 16'h0000; rom[ 3852] = 16'h0000; rom[ 3853] = 16'h0000; rom[ 3854] = 16'h0000; rom[ 3855] = 16'h0000;
    rom[ 3856] = 16'h0000; rom[ 3857] = 16'h0000; rom[ 3858] = 16'h0000; rom[ 3859] = 16'h0000; rom[ 3860] = 16'h0000; rom[ 3861] = 16'h0000; rom[ 3862] = 16'h0000; rom[ 3863] = 16'h0000;
    rom[ 3864] = 16'h0000; rom[ 3865] = 16'h0000; rom[ 3866] = 16'h0000; rom[ 3867] = 16'h0000; rom[ 3868] = 16'h0000; rom[ 3869] = 16'h0000; rom[ 3870] = 16'h0000; rom[ 3871] = 16'h0000;
    rom[ 3872] = 16'h0000; rom[ 3873] = 16'h0000; rom[ 3874] = 16'h0000; rom[ 3875] = 16'h0000; rom[ 3876] = 16'h0000; rom[ 3877] = 16'h0000; rom[ 3878] = 16'h0000; rom[ 3879] = 16'h0000;
    rom[ 3880] = 16'h0000; rom[ 3881] = 16'h0000; rom[ 3882] = 16'h0000; rom[ 3883] = 16'h0000; rom[ 3884] = 16'h0000; rom[ 3885] = 16'h0000; rom[ 3886] = 16'h0000; rom[ 3887] = 16'h0000;
    rom[ 3888] = 16'h0000; rom[ 3889] = 16'h0000; rom[ 3890] = 16'h0000; rom[ 3891] = 16'h0000; rom[ 3892] = 16'h0000; rom[ 3893] = 16'h0000; rom[ 3894] = 16'h0000; rom[ 3895] = 16'h0000;
    rom[ 3896] = 16'h0000; rom[ 3897] = 16'h0000; rom[ 3898] = 16'h0000; rom[ 3899] = 16'h0000; rom[ 3900] = 16'h0000; rom[ 3901] = 16'h0000; rom[ 3902] = 16'h0000; rom[ 3903] = 16'h0000;
    rom[ 3904] = 16'h0000; rom[ 3905] = 16'h0000; rom[ 3906] = 16'h0000; rom[ 3907] = 16'h0000; rom[ 3908] = 16'h0000; rom[ 3909] = 16'h0000; rom[ 3910] = 16'h0000; rom[ 3911] = 16'h0000;
    rom[ 3912] = 16'h0000; rom[ 3913] = 16'h0000; rom[ 3914] = 16'h0000; rom[ 3915] = 16'h0000; rom[ 3916] = 16'h0000; rom[ 3917] = 16'h0000; rom[ 3918] = 16'h0000; rom[ 3919] = 16'h0000;
    rom[ 3920] = 16'h0000; rom[ 3921] = 16'h0000; rom[ 3922] = 16'h0000; rom[ 3923] = 16'h0000; rom[ 3924] = 16'h0000; rom[ 3925] = 16'h0000; rom[ 3926] = 16'h0000; rom[ 3927] = 16'h0000;
    rom[ 3928] = 16'h0000; rom[ 3929] = 16'h0000; rom[ 3930] = 16'h0000; rom[ 3931] = 16'h0000; rom[ 3932] = 16'h0000; rom[ 3933] = 16'h0000; rom[ 3934] = 16'h0000; rom[ 3935] = 16'h0000;
    rom[ 3936] = 16'h0000; rom[ 3937] = 16'h0000; rom[ 3938] = 16'h0000; rom[ 3939] = 16'h0000; rom[ 3940] = 16'h0000; rom[ 3941] = 16'h0000; rom[ 3942] = 16'h0000; rom[ 3943] = 16'h0000;
    rom[ 3944] = 16'h0000; rom[ 3945] = 16'h0000; rom[ 3946] = 16'h0000; rom[ 3947] = 16'h0000; rom[ 3948] = 16'h0000; rom[ 3949] = 16'h0000; rom[ 3950] = 16'h0000; rom[ 3951] = 16'h0000;
    rom[ 3952] = 16'h0000; rom[ 3953] = 16'h0000; rom[ 3954] = 16'h0000; rom[ 3955] = 16'h0000; rom[ 3956] = 16'h0000; rom[ 3957] = 16'h0000; rom[ 3958] = 16'h0000; rom[ 3959] = 16'h0000;
    rom[ 3960] = 16'h0000; rom[ 3961] = 16'h0000; rom[ 3962] = 16'h0000; rom[ 3963] = 16'h0000; rom[ 3964] = 16'h0000; rom[ 3965] = 16'h0000; rom[ 3966] = 16'h0000; rom[ 3967] = 16'h0000;
    rom[ 3968] = 16'h0000; rom[ 3969] = 16'h0000; rom[ 3970] = 16'h0000; rom[ 3971] = 16'h0000; rom[ 3972] = 16'h0000; rom[ 3973] = 16'h0000; rom[ 3974] = 16'h0000; rom[ 3975] = 16'h0000;
    rom[ 3976] = 16'h0000; rom[ 3977] = 16'h0000; rom[ 3978] = 16'h0000; rom[ 3979] = 16'h0000; rom[ 3980] = 16'h0000; rom[ 3981] = 16'h0000; rom[ 3982] = 16'h0000; rom[ 3983] = 16'h0000;
    rom[ 3984] = 16'h0000; rom[ 3985] = 16'h0000; rom[ 3986] = 16'h0000; rom[ 3987] = 16'h0000; rom[ 3988] = 16'h0000; rom[ 3989] = 16'h0000; rom[ 3990] = 16'h0000; rom[ 3991] = 16'h0000;
    rom[ 3992] = 16'h0000; rom[ 3993] = 16'h0000; rom[ 3994] = 16'h0000; rom[ 3995] = 16'h0000; rom[ 3996] = 16'h0000; rom[ 3997] = 16'h0000; rom[ 3998] = 16'h0000; rom[ 3999] = 16'h0000;
    rom[ 4000] = 16'h0000; rom[ 4001] = 16'h0000; rom[ 4002] = 16'h0000; rom[ 4003] = 16'h0000; rom[ 4004] = 16'h0000; rom[ 4005] = 16'h0000; rom[ 4006] = 16'h0000; rom[ 4007] = 16'h0000;
    rom[ 4008] = 16'h0000; rom[ 4009] = 16'h0000; rom[ 4010] = 16'h0000; rom[ 4011] = 16'h0000; rom[ 4012] = 16'h0000; rom[ 4013] = 16'h0000; rom[ 4014] = 16'h0000; rom[ 4015] = 16'h0000;
    rom[ 4016] = 16'h0000; rom[ 4017] = 16'h0000; rom[ 4018] = 16'h0000; rom[ 4019] = 16'h0000; rom[ 4020] = 16'h0000; rom[ 4021] = 16'h0000; rom[ 4022] = 16'h0000; rom[ 4023] = 16'h0000;
    rom[ 4024] = 16'h0000; rom[ 4025] = 16'h0000; rom[ 4026] = 16'h0000; rom[ 4027] = 16'h0000; rom[ 4028] = 16'h0000; rom[ 4029] = 16'h0000; rom[ 4030] = 16'h0000; rom[ 4031] = 16'h0000;
    rom[ 4032] = 16'h0000; rom[ 4033] = 16'h0000; rom[ 4034] = 16'h0000; rom[ 4035] = 16'h0000; rom[ 4036] = 16'h0000; rom[ 4037] = 16'h0000; rom[ 4038] = 16'h0000; rom[ 4039] = 16'h0000;
    rom[ 4040] = 16'h0000; rom[ 4041] = 16'h0000; rom[ 4042] = 16'h0000; rom[ 4043] = 16'h0000; rom[ 4044] = 16'h0000; rom[ 4045] = 16'h0000; rom[ 4046] = 16'h0000; rom[ 4047] = 16'h0000;
    rom[ 4048] = 16'h0000; rom[ 4049] = 16'h0000; rom[ 4050] = 16'h0000; rom[ 4051] = 16'h0000; rom[ 4052] = 16'h0000; rom[ 4053] = 16'h0000; rom[ 4054] = 16'h0000; rom[ 4055] = 16'h0000;
    rom[ 4056] = 16'h0000; rom[ 4057] = 16'h0000; rom[ 4058] = 16'h0000; rom[ 4059] = 16'h0000; rom[ 4060] = 16'h0000; rom[ 4061] = 16'h0000; rom[ 4062] = 16'h0000; rom[ 4063] = 16'h0000;
    rom[ 4064] = 16'h0000; rom[ 4065] = 16'h0000; rom[ 4066] = 16'h0000; rom[ 4067] = 16'h0000; rom[ 4068] = 16'h0000; rom[ 4069] = 16'h0000; rom[ 4070] = 16'h0000; rom[ 4071] = 16'h0000;
    rom[ 4072] = 16'h0000; rom[ 4073] = 16'h0000; rom[ 4074] = 16'h0000; rom[ 4075] = 16'h0000; rom[ 4076] = 16'h0000; rom[ 4077] = 16'h0000; rom[ 4078] = 16'h0000; rom[ 4079] = 16'h0000;
    rom[ 4080] = 16'h0000; rom[ 4081] = 16'h0000; rom[ 4082] = 16'h0000; rom[ 4083] = 16'h0000; rom[ 4084] = 16'h0000; rom[ 4085] = 16'h0000; rom[ 4086] = 16'h0000; rom[ 4087] = 16'h0000;
    rom[ 4088] = 16'h0000; rom[ 4089] = 16'h0000; rom[ 4090] = 16'h0000; rom[ 4091] = 16'h0000; rom[ 4092] = 16'h0000; rom[ 4093] = 16'h0000; rom[ 4094] = 16'h0000; rom[ 4095] = 16'h0000;
end

always @(posedge clk) dout <= rom[addr];

endmodule
