ydf0809/ydf/projects/merged_cam_lcd_voice_scnn/rtl/drone_data_roms.v

// Embedded SCNN weights and reference frame. Preserve ROM values and lane order.
`timescale 1ns / 1ps
module drone_conv1_rom #(
    parameter P_DATA_WIDTH = 384,
    parameter P_DEPTH      = 9
) (
    input  wire [$clog2(P_DEPTH)-1:0] i_tap_addr,
    output wire [P_DATA_WIDTH-1:0]    o_word
);
    (* rom_style = "block" *) reg [P_DATA_WIDTH-1:0] mem [0:P_DEPTH-1];
    initial begin
        mem[0] = 384'h01F7F8FEFFE60009FF50FDE3FFE9FC6C007DFDDB0276FC740150FE5202FDFC170183F9F00107FC970081FD5800C7FBFB;
        mem[1] = 384'hFE72FCD800C001F1023DFE4E01E0FFE5FECAFB6B0223014FFF8BFC5CFFBAFFEC0296FF0D02AE02EB01F5001B006BF9E4;
        mem[2] = 384'hFF1FFB8103FF02340273FC9E035FF9D502CEFFEDFF4DFFBBFDCDFAE0023FFB5A0159FE300316FE5C00BCFD4C02D3FF6A;
        mem[3] = 384'hFF3EFDAF0333FF1AFE5EFD8001B000ED013DFC8501B8007F0073011E01E900A0040E0244034AFEF7FC5EFDE90062FC18;
        mem[4] = 384'hFF1FFFF00448FD8FFCC0FE790436FD480150034601750286FDABFE530041FEC60080030C0073FD65004C01C002EAFD31;
        mem[5] = 384'h0122FFBD054D020BFD5D01810470FF1D041EFFBC01180244020CFE270505FC5B037F036200230117014000530292FBC6;
        mem[6] = 384'h033D05480075FCBAFD07025E01BAFCE6056901B70501FDDEFE66FCF904AEFEA9023F023900AEFBB1FB2402080033003B;
        mem[7] = 384'h04F703FD0517FE8200DC00310481FF3F0448021E04BD014E003D01D302C5FF7102CD02E602C2FDFDFDD9034A024600E9;
        mem[8] = 384'h039F073E016EFC41FAB5FEFE0223FAA1032B06CC02A4FD78FCE801F901A1FFEA03F202D80201FC8B0022FD4C025AFA7E;
    end
    assign o_word = mem[i_tap_addr];
endmodule

module drone_conv2_rom #(
    parameter P_DATA_WIDTH = 2048,
    parameter P_DEPTH      = 9
) (
    input  wire [$clog2(P_DEPTH)-1:0] i_tap_addr,
    output wire [P_DATA_WIDTH-1:0]    o_word
);
    (* rom_style = "block" *) reg [P_DATA_WIDTH-1:0] mem [0:P_DEPTH-1];
    initial begin
        mem[0] = 2048'hFE71FCB7FB3F0085FF58FD2B02800011FB7B006D051BFEDEFFE9006903230059001F057A01A8FF16025E030502D704460195010D02CE0127FAD20051FAFC0018FFBCFEF7FE35023EFE11FFF8FF730162FD63FD300744FFB8010EFCBC0282042FFE8DFE200122009801A700BAFEA800E0FFF100CBFF1300A80147FE2DFE6400F2010100BA0184017101BF016C00E3FE65FF6C00C000E1002100990073FF45FEF7FE6501D1FEAA00AE01BFFFDCFFC2FE11000AFEDDFE7E01A9015FFE8EFE85FDE8FD4FFEEDFF4C0295FE64FF7B0088FF7AFE3EFD3D075FFF7701D0FFE3035A06D7014B008C0059019FFE4D010BFFFC0198FE8000F10092FFE0FF9801A00114FEF3;
        mem[1] = 2048'hFFE1F894FBEE022CFE04F9920069FEB5FEB9000204B2FE05012CFED301B704D4039F040801BCFD2C0410032200CF02140193FF43FF7EFE93FE41FFB2F9EB02CB0134FF26FE4801EDFD35FE8D00540098FD42FE66070A000D0197FCEA028C057700EAFF49FF1D016900E7016D0141FF40FEB4FF10FFA2FF29FF890154FF360125FEDA00CDFF220127FE7000B7FF1C01420059003B0009FE66FF96FEB7014B00BD012EFECB0038FE6CFEE10106FE12FFED01930145FF0EFF81002C0000FEA9011F0100FC0AFEA2006800ACFAAEFFD7FFCCFD94FF3D0550FD23FFE1FD0200C40395FF8D0102FE1DFF9B00E0FE47FFB1019701B10151FEBDFE58FEE00043003AFF64;
        mem[2] = 2048'h03AAF77FFB8102BCFD90FBA801F3FE82FE16FDD600FCFD5EFDF300FC03750526FF3D03BC0024FD5E0290022501BBFFEBFF8EFFB0FEB70110FC5BFF71FADBFF6F0210FCBAFE6C01B6FF7DF959FEEEFFA7FF71FD8A04B700BAFFA5FFE402E6045C00C8FFA4FEA70194FFE8FF84FF9601A6FF0DFEC000FE015AFE4B002E007300F30049FFC3FFCB0133FFDBFE8EFE7BFFF4FEFE0170FE21017A010F01BA0044FE51FEFB007DFF4CFF65014000A4FFC1FF0F01B2FEE70113FEB2FFCA0000FFFCFE8E0079FC61FCCB0139FF8CFBBDFEF300EFFFF5FD8D01E9FCAAFFC9FEA401B60406015AFE74FF45001C002100F8FE34FFDEFFF0007A00B7FE7900E3FE9BFF1F00F1;
        mem[3] = 2048'hFD8901C3FAAA028502C6FDDAFF19FE720058FC40FF3AFD0F00A3003C00BDFB26003607A8FE9CFD7FFDB4060CFF41019E0038FDE5026EFE82FB9EFF5DF9220397FD4F0089FD8E0258FE96FCE60149FEBCFDB5FD290465004602330091014EFFFD01BCFE8CFE9200CC004AFF42FF59FFD0001C0129012101AEFFEE001301170187FEB8FF390039012800B2FFF300F6FF87FE83FEA2FE7401ACFF0E01C8FEA201BEFECB022EFED400F3011FFF4A00AA019301620130FEA90006FEB60157FE90FFA4FF23FFDCFC16005E0073FD7E0024FCD4003C004603CBFFCA012BFE4001AD0359FF21FFEE002901D000BCFE6E01030048008C01DAFF6DFEF0009C003E0066FE41;
        mem[4] = 2048'h024FFDAAFBC601DEFF05FE2E0163FD1BFD17FF2FFD1BFEBAFFC7FEAE0388FEE103AB0605FFD2FE38000606B3FE06025CFDC3FF5903F9FFB8FB460132FB570242FFC4FC55FE4FFEB6FCF1FE8AFDE2FCABFE2EFE2401B9FCC4002BFDE3FE9400700141FE4500D00015003A006D01C0FE80FF31FFEE00BAFE5601900180019B0170FEA100CE0124FEE1FE6900DD010FFF56FEB501AE0171013AFFF0FF48FE230074002AFFBF015C0145FED0FFE301B30003002A00F8FF50FDC7FFE2003A0126FFDF027BFE14F9F0FFB3FF69FC8A0219FDC8FE48FDBB01D0FF2100E8FDD7FF9C0404FF9001D001E000BD00FBFF75FFEBFF83FFA4FFDA01ADFEEDFE30017F0094FEF5;
        mem[5] = 2048'h0247FB15FA5C01FFFFB8FE610153FE16FEC7FF7FF992FBDBFF3C019800D701450342070D0083FEB0019006DFFE410395FE33013A02DCFE2BFCABFF9BFB5F04790119FD97FEEF0041FE7CFF9E0050FD300102FF17FE1FFF6C000AFE88FF7D01B2FEC8FF48FFB7016500F101DE0006FFB2FF2CFFCF01730196FF1700E301AE010A00FDFEC901DE0152FED3003D015900200096FE2D01E1FF7A01DEFFA9FE64FF35FEB6FF44FEAD008D015CFF8701D60177008CFFE3FE61FFC8FE94FFDDFF8101CE01D6FB54FD1901A2FEEEFEE0013BFF150069FF45FFB3FFFB01E1FF9600D10262FE5C004CFE6F001C0076FF2AFF74FFF5004700BF019DFE6DFE28002DFF0AFF1F;
        mem[6] = 2048'hFD230542FE7E035202E4078DFFBDFDC3FF25FE9AFD51FE1A038EFFA10382F80102960487FED2FD040246055000040327006501FC03D00037FAD6FF09FA4F041EFF33068702270291FFD004FBFFB6FD15FFB80078FD65019D0057005000A9FA9C002401370158FEB000F6FF85FF7A0010FEF000550049FF73015BFF3EFE76FFA6FF76FF2D00E0FF7201A1FE910004FFB3FF0700F3FF8F0097014FFF9E0176FE4CFF26FFAE01BB0038FF0201A7FDBDFF4D01DBFF9A005A004AFFDD001900B0FFEAFD98068600C20016FEFB06A300DC008300D50107FEC9FF1802E1004CFFF8FAD0012DFEDBFE57FFBD0090FFF7019AFEBAFF62009101A2009400A400CD01600017;
        mem[7] = 2048'h039703E6FCFC031400B70824007A005501B5FE41F90FFF05023001320040F855038A04DA0141FD39034406BCFE1402340240FF11032202A0FCCCFFD5F9C9045FFF21056E0262010F017802C301F4FEC30264FD5CFF8FFD680078FE5C01C1FBB00012002C00CF00AEFF8AFEDFFFEC0185FF56FE97FF60FED600300023FF9C0045007B01DCFED7FF74FE8AFE9FFF7D017E007800F200CFFF650097FE2AFF940124000D002F0001006C00CB004E0021FF620197FF820184FEC1FF97FF2C007F0186006A0697FEF80243FFA6041FFEACFD4A01ECFE24FCC1FF7201B3FE270136FD3AFF67FEA50195018AFF3100A4015BFEE5FE41FF62FF5301CF0145FE7AFFEBFEC1;
        mem[8] = 2048'h025A0662FF0B02BA03CE0643FF8EFD12FF360099F6DEFD21004500BA007DFAA5029D05E90449FBAB05250730FEA8012201D0005C056E001EFC9100D4F9FD05C503320478010B03A2019B050102CAFC0EFFD8FF55F829FEB50188FDC5009AFE9000F200EB019301DCFE43FE2FFF5300FCFEA7FFCBFEF1011D01D0FFCD00140092FECF0144FEF700E9FFFA014AFF57FF9CFFF4FF60FFBCFFFFFFA1FE6901190164FFECFF19FFCA010BFFDA0002FEBB0071FE28FE4800EA0102008C0080FE29FE8D01BD061B000B017CFEF504D00040FF0900A8FE82F963FD3A0219FFD10193FD70FEAF01CAFFD2018DFFD9FF10FFB6017E00E2004AFE30FFB600A6FEC2018CFEEA;
    end
    assign o_word = mem[i_tap_addr];
endmodule

module drone_fc0_rom (
    input  wire                          clka,
    input  wire                          ena,
    input  wire [7:0]                    addra,
    output wire [63:0]                   douta
);
    (* rom_style = "block" *) reg [63:0] mem [0:255];
    reg [63:0] rd1;
    reg [63:0] rd2;
    initial begin
        mem[0] = 64'h029E021E01E30241;
        mem[1] = 64'h025E00E0FF88FFCA;
        mem[2] = 64'h032D032201D400D5;
        mem[3] = 64'h019801D4019C00E6;
        mem[4] = 64'hFF6600A7FF23FE4D;
        mem[5] = 64'hFD59FF7F006C03D1;
        mem[6] = 64'h03A2FFCCF970F7A7;
        mem[7] = 64'hF7B0FA29FD4C02AE;
        mem[8] = 64'h01AF0102FE42FF30;
        mem[9] = 64'hFD4FFE4D00BC020D;
        mem[10] = 64'h00AF019F0075FEC1;
        mem[11] = 64'hFE91FF9BFFF400AC;
        mem[12] = 64'h0107013300F501E7;
        mem[13] = 64'hFFE7005300AAFFFA;
        mem[14] = 64'hFF9A010A004000FE;
        mem[15] = 64'h00CCFFF80083FFDE;
        mem[16] = 64'h0034FFE2FF9AFEC0;
        mem[17] = 64'hFFB6000A00C300B7;
        mem[18] = 64'hFFC2005BFFB3FF3F;
        mem[19] = 64'hFFFD008C000D00F1;
        mem[20] = 64'h00BDFFFCFF72FF9E;
        mem[21] = 64'hFFD0005500D900C5;
        mem[22] = 64'hFFCD00B0013201D0;
        mem[23] = 64'h0266013400BE00AC;
        mem[24] = 64'hFFDAFFE2017702FD;
        mem[25] = 64'h0396021B00710038;
        mem[26] = 64'hFFBE004EFFF8005A;
        mem[27] = 64'h000400E90059FFAB;
        mem[28] = 64'h00AA002E002D006E;
        mem[29] = 64'h005F00BEFFECFF7B;
        mem[30] = 64'h004100360000FFC9;
        mem[31] = 64'h00EA006A0081FF57;
        mem[32] = 64'hFF8D001B00190062;
        mem[33] = 64'h005500770029FFB5;
        mem[34] = 64'hFFC3FF93007A0003;
        mem[35] = 64'h00600039FFD9FFB1;
        mem[36] = 64'h000B000F00750057;
        mem[37] = 64'h002FFFD300520055;
        mem[38] = 64'hFF9C00480024FF95;
        mem[39] = 64'hFFE000170073FFCD;
        mem[40] = 64'hFF81FF81FFCFFFE2;
        mem[41] = 64'h000CFF8DFFA80031;
        mem[42] = 64'hFFC8007400140046;
        mem[43] = 64'hFF9700650045FFBD;
        mem[44] = 64'h002F00070001007A;
        mem[45] = 64'h0010FFA400340048;
        mem[46] = 64'hFFD4FF91000AFFAC;
        mem[47] = 64'h003A007AFF950066;
        mem[48] = 64'h00F2004DFFE8FF8C;
        mem[49] = 64'hFF4AFFF80046FFFC;
        mem[50] = 64'hFFFBFF1D0007FED6;
        mem[51] = 64'hFF96002AFFD8FF3D;
        mem[52] = 64'h0007FF8AFF53FEDF;
        mem[53] = 64'hFFABFF3800460045;
        mem[54] = 64'hFF2EFFA702360374;
        mem[55] = 64'h0462029C010BFFA7;
        mem[56] = 64'hFECDFEDBFF780087;
        mem[57] = 64'h01C5FFD0002DFFE0;
        mem[58] = 64'h0025FF64FF27FF65;
        mem[59] = 64'hFF81FF8DFEBEFF6C;
        mem[60] = 64'hFFEF0052FF8EFFA6;
        mem[61] = 64'h00D0FF72FF52FF4E;
        mem[62] = 64'hFFB5FFBDFF9DFFCE;
        mem[63] = 64'hFFA7FF640047FF60;
        mem[64] = 64'hFFA2FFDA0049FFE9;
        mem[65] = 64'hFF9BFFBC0075FFD2;
        mem[66] = 64'hFFAE0000FFE3FFD9;
        mem[67] = 64'h0063FFEA0075007B;
        mem[68] = 64'h00540002002CFFD5;
        mem[69] = 64'h00590044FFB0004D;
        mem[70] = 64'hFFFE000AFFA9FF9E;
        mem[71] = 64'hFFDF002CFFA30036;
        mem[72] = 64'h0021FFD0FFE5FFBD;
        mem[73] = 64'hFF94002DFFD2FFA2;
        mem[74] = 64'h003BFFA6FFEDFFDF;
        mem[75] = 64'hFFBA0001001E0062;
        mem[76] = 64'h0001FFFB0017FF92;
        mem[77] = 64'hFFA9FFBBFFB9FF9A;
        mem[78] = 64'h006C00210070FF95;
        mem[79] = 64'hFF8EFFCBFFC6005E;
        mem[80] = 64'h028103CD037801F8;
        mem[81] = 64'h01880193FFDD00F5;
        mem[82] = 64'h024103E603A902BD;
        mem[83] = 64'h00CA023B018800B9;
        mem[84] = 64'hFFBF01EE006DFF85;
        mem[85] = 64'hFE2CFF780101FFF1;
        mem[86] = 64'h0260FD49F98BF84E;
        mem[87] = 64'hF8B0FA89FE84010C;
        mem[88] = 64'h008500D3FD80FCF2;
        mem[89] = 64'hFF85003000D900A8;
        mem[90] = 64'h00EF025C01A5FF78;
        mem[91] = 64'h013201A9007C0062;
        mem[92] = 64'h012202A901E60172;
        mem[93] = 64'h013601EB01D10065;
        mem[94] = 64'h00A300C100F60063;
        mem[95] = 64'h00B1013800B9002A;
        mem[96] = 64'h005EFF8C00400018;
        mem[97] = 64'hFFD7FF810058FFC9;
        mem[98] = 64'h000CFFA4FFB6FF99;
        mem[99] = 64'h004C001BFFBDFFF7;
        mem[100] = 64'h0066FFF500060042;
        mem[101] = 64'h006800640009007D;
        mem[102] = 64'h00430057007C0067;
        mem[103] = 64'h0036FF95FF8C0052;
        mem[104] = 64'hFFD20061005DFFC6;
        mem[105] = 64'hFFABFF830068FFC5;
        mem[106] = 64'hFFB9003A00580060;
        mem[107] = 64'hFFA3FFB0005CFFD9;
        mem[108] = 64'h0037003AFFBA0044;
        mem[109] = 64'h005B0063FFFA0073;
        mem[110] = 64'hFFEB0074FFD00033;
        mem[111] = 64'hFFD6FF9000730048;
        mem[112] = 64'h00110061FFB80003;
        mem[113] = 64'hFFE1000F0031FFE2;
        mem[114] = 64'hFFE5FFFCFF8BFF83;
        mem[115] = 64'h0066FF88FFC9FF97;
        mem[116] = 64'h0040FFC5FFD90045;
        mem[117] = 64'h000FFFD300390002;
        mem[118] = 64'h002CFFCCFFF60051;
        mem[119] = 64'hFFE400490065004A;
        mem[120] = 64'hFFC7FFF4FF84FFA5;
        mem[121] = 64'hFFC3001CFF86FF9B;
        mem[122] = 64'hFFCEFFC4FF970004;
        mem[123] = 64'h0047002500400064;
        mem[124] = 64'hFFBDFFBCFFD0FFC3;
        mem[125] = 64'hFFAFFFA60050FFAA;
        mem[126] = 64'hFFBFFFA800440034;
        mem[127] = 64'hFFDAFF86FFE0FFD1;
        mem[128] = 64'hFFC20002FF910001;
        mem[129] = 64'hFFB20064006B003B;
        mem[130] = 64'hFFEA00770043004D;
        mem[131] = 64'hFFA60025FF81FF9E;
        mem[132] = 64'h007DFFEBFFA8FFA2;
        mem[133] = 64'hFFB2007A00140005;
        mem[134] = 64'hFFB90018000DFF9B;
        mem[135] = 64'hFFC7005F0011FFD7;
        mem[136] = 64'hFF84003FFFDEFFAF;
        mem[137] = 64'hFF85FFBDFF8B0079;
        mem[138] = 64'hFFF00053FFC5004A;
        mem[139] = 64'h007BFFEA0050002E;
        mem[140] = 64'h001BFF9F002D007F;
        mem[141] = 64'hFFF90016FFCC002E;
        mem[142] = 64'hFF8C0013FFAEFFAD;
        mem[143] = 64'hFFEB002500270022;
        mem[144] = 64'hFFECFFFFFFFCFFF0;
        mem[145] = 64'h0096007200030095;
        mem[146] = 64'h0022FF5AFFCDFFDF;
        mem[147] = 64'h0028FFEDFF2DFFB8;
        mem[148] = 64'hFFB3FFE6FFEAFF15;
        mem[149] = 64'hFFB6FF47FFCCFF5F;
        mem[150] = 64'hFFC2FFD8FFF6004D;
        mem[151] = 64'h0050FF8CFFCEFF4A;
        mem[152] = 64'hFFFEFFBFFFA90040;
        mem[153] = 64'hFFA8FFAA004CFFDA;
        mem[154] = 64'h0018007AFF45FFB1;
        mem[155] = 64'h003C001FFF830001;
        mem[156] = 64'h00DF00DE00C3FFBF;
        mem[157] = 64'h005DFFFE0070FF6C;
        mem[158] = 64'hFFE40028001F0084;
        mem[159] = 64'h00640024004FFF96;
        mem[160] = 64'h00EBFFF3007D005A;
        mem[161] = 64'h0092008DFFE80037;
        mem[162] = 64'h018D00B200FF0151;
        mem[163] = 64'h0163024300160113;
        mem[164] = 64'h02AC022600BE02A0;
        mem[165] = 64'h005C019FFF4F00B3;
        mem[166] = 64'hFFE0FF7FFCD6FD8B;
        mem[167] = 64'hFD34FC82FFB601B8;
        mem[168] = 64'h02AAFF30FAE8F993;
        mem[169] = 64'hF9A7FC38FE0801C6;
        mem[170] = 64'h017A020F0175012D;
        mem[171] = 64'hFF79026202F201DA;
        mem[172] = 64'hFFE900300074005B;
        mem[173] = 64'h022D022302CB0276;
        mem[174] = 64'hFEC9001D0029FF71;
        mem[175] = 64'hFFFE001300550075;
        mem[176] = 64'h0125FDD4FFD3FF57;
        mem[177] = 64'h0036005F007900A1;
        mem[178] = 64'hFF18FFDEFED9FF24;
        mem[179] = 64'h007DFFBA009BFFC5;
        mem[180] = 64'hFF9B00100058FFF1;
        mem[181] = 64'h011900ACFFD7FF93;
        mem[182] = 64'hFF38FF9B00C5FE74;
        mem[183] = 64'hFFA3007C0188004A;
        mem[184] = 64'h0014FF72FE4BFE8E;
        mem[185] = 64'hFE810014FF61FF69;
        mem[186] = 64'h009200C4FEEA00CF;
        mem[187] = 64'hFFD0001C000A005F;
        mem[188] = 64'hFFC8004100F90147;
        mem[189] = 64'h0076001300AB006E;
        mem[190] = 64'h0058FFF6FF69FF4A;
        mem[191] = 64'hFFCC00EA0017FFF2;
        mem[192] = 64'h00F60032FF55FFD3;
        mem[193] = 64'h0056FFC4004F003F;
        mem[194] = 64'hFFB1002BFF15FF8E;
        mem[195] = 64'hFF96FFBA002E0018;
        mem[196] = 64'h006C0003FF12FECE;
        mem[197] = 64'h0005FFCF001FFFB1;
        mem[198] = 64'hFF930082018D02C1;
        mem[199] = 64'h037D01BDFFEBFF8F;
        mem[200] = 64'hFFEB002701110160;
        mem[201] = 64'h01F501360032FFE2;
        mem[202] = 64'h00B60078FFF10054;
        mem[203] = 64'hFFA6FF4FFF6DFF32;
        mem[204] = 64'h005900E600EA00B7;
        mem[205] = 64'h005EFFB1003BFF96;
        mem[206] = 64'hFFF3FFFD00290052;
        mem[207] = 64'h00970036FF54FFC7;
        mem[208] = 64'h0079FFA90023FF8E;
        mem[209] = 64'h001DFFF1002C0059;
        mem[210] = 64'hFFDD006B00150025;
        mem[211] = 64'hFF9BFF83FFA9FF8D;
        mem[212] = 64'hFFFAFFEDFFA4FFFD;
        mem[213] = 64'h0030FFB1FFF6FFB2;
        mem[214] = 64'hFFAE0003001F003A;
        mem[215] = 64'hFFA8006EFFFBFFB0;
        mem[216] = 64'hFFC4003900270021;
        mem[217] = 64'hFF91FFF1FF8A0013;
        mem[218] = 64'h000C0056FFED0044;
        mem[219] = 64'h0012003D00210070;
        mem[220] = 64'h002A007B007AFFB3;
        mem[221] = 64'hFF9CFFB400060000;
        mem[222] = 64'hFF9AFFDFFFE3FF9D;
        mem[223] = 64'h003FFFCDFFE9007C;
        mem[224] = 64'h007A002A00E7002E;
        mem[225] = 64'h00FB00F2FFD70052;
        mem[226] = 64'h012D003800C6010C;
        mem[227] = 64'h023601E6009EFFD4;
        mem[228] = 64'h01C902F501E302BF;
        mem[229] = 64'h00A301E1FF44FFEC;
        mem[230] = 64'h00CAFF55FC72FDEE;
        mem[231] = 64'hFDF7FDD00018001B;
        mem[232] = 64'h0217FF38FA99F971;
        mem[233] = 64'hFAA7FCB9FE1F005B;
        mem[234] = 64'h01930203014B0195;
        mem[235] = 64'hFFD00234026300F3;
        mem[236] = 64'hFF3E0072FFA200D9;
        mem[237] = 64'h0120018D023100C7;
        mem[238] = 64'hFE86FFE8FFE5FFA7;
        mem[239] = 64'h004F004000FDFFC7;
        mem[240] = 64'h00CCFF18FF7A00C9;
        mem[241] = 64'h038400B90030020B;
        mem[242] = 64'hFF3FFFEA007400A1;
        mem[243] = 64'h02400087FF2300E6;
        mem[244] = 64'h012EFF1EFE4EFEF9;
        mem[245] = 64'h01FBFDA2FF1C006E;
        mem[246] = 64'hFF940057FFEEFDDA;
        mem[247] = 64'hFD6BFA2EFED1FF1B;
        mem[248] = 64'hFF9400690182FF3C;
        mem[249] = 64'hFF3AFCF6FDD500BC;
        mem[250] = 64'h00CFFF7301E40186;
        mem[251] = 64'h0254FE55FF1F015A;
        mem[252] = 64'h0184002800760241;
        mem[253] = 64'h01A7FE85FFC1FFD6;
        mem[254] = 64'h00C70072021A01C5;
        mem[255] = 64'h01EBFE9B016DFF49;
    end
    always @(posedge clka) begin
        rd1 <= mem[addra];
        rd2 <= rd1;
    end
    assign douta = rd2;
endmodule

module drone_fc1_rom (
    input  wire                          clka,
    input  wire                          ena,
    input  wire [7:0]                    addra,
    output wire [63:0]                   douta
);
    (* rom_style = "block" *) reg [63:0] mem [0:255];
    reg [63:0] rd1;
    reg [63:0] rd2;
    initial begin
        mem[0] = 64'hFDBCFE0FFE3DFF1A;
        mem[1] = 64'hFDBAFF930143FFAD;
        mem[2] = 64'hFE85FCE2FD6FFEA3;
        mem[3] = 64'hFE48FE0CFF34FE7C;
        mem[4] = 64'h00B7FFA1016900F4;
        mem[5] = 64'h018CFF78FEE2FCD2;
        mem[6] = 64'hFCC8004E06AC073D;
        mem[7] = 64'h07B6064702B4FDDA;
        mem[8] = 64'hFF79FFA4023E0115;
        mem[9] = 64'h0340026AFFB4FEC5;
        mem[10] = 64'hFEE9FEDEFFB100A9;
        mem[11] = 64'h01520060FFE8FF38;
        mem[12] = 64'hFF08FEA0FFBEFF68;
        mem[13] = 64'h00BD0078005B009E;
        mem[14] = 64'h0039FF61FF9CFF92;
        mem[15] = 64'hFFA6FF7C0008FF4E;
        mem[16] = 64'h001CFF8900390145;
        mem[17] = 64'h002A0078005E0010;
        mem[18] = 64'h013E00A900E20197;
        mem[19] = 64'h0125FFF50036001E;
        mem[20] = 64'h00AC00B30133020A;
        mem[21] = 64'h00D20029002DFFF6;
        mem[22] = 64'h0067FFBDFF81FE2B;
        mem[23] = 64'hFCD5FE7AFFDB0076;
        mem[24] = 64'h00D6FFFAFF02FC79;
        mem[25] = 64'hFD10FE85FF79003F;
        mem[26] = 64'h0145018600CE0156;
        mem[27] = 64'h0149002B010F0100;
        mem[28] = 64'h0058007C0189011F;
        mem[29] = 64'h005E0145015601D1;
        mem[30] = 64'h0075012400DD00F1;
        mem[31] = 64'h0128013B00C600F6;
        mem[32] = 64'hFFC4FFF30004FFD1;
        mem[33] = 64'hFFF6FFF50058FFF9;
        mem[34] = 64'hFFA8006BFFF2FFA4;
        mem[35] = 64'hFFC6FFF50002FFE7;
        mem[36] = 64'hFF91FFE7FFD80073;
        mem[37] = 64'hFF87FF8E0036FFAC;
        mem[38] = 64'h0036FFFA0012FF98;
        mem[39] = 64'hFFA9FF9BFF93FF86;
        mem[40] = 64'h001D0035FF95FF99;
        mem[41] = 64'hFFBD0074FFA1FFBE;
        mem[42] = 64'h003A004A007C004E;
        mem[43] = 64'hFFDEFFCAFFBC0026;
        mem[44] = 64'hFF8C007E000CFFE1;
        mem[45] = 64'h0045FFD00033FF96;
        mem[46] = 64'hFFAE0025FFB80079;
        mem[47] = 64'h003900730030FFB6;
        mem[48] = 64'hFFDFFF70FFEC007B;
        mem[49] = 64'h001FFFD5FEF2FFF1;
        mem[50] = 64'hFFEE001FFFC00137;
        mem[51] = 64'h000B004A00410085;
        mem[52] = 64'h0008003B0061009C;
        mem[53] = 64'h004C00C400450035;
        mem[54] = 64'h004E0004FD74FC58;
        mem[55] = 64'hFC92FDEFFF87008C;
        mem[56] = 64'h005D0145008CFF34;
        mem[57] = 64'hFE50FFF7FF9F000D;
        mem[58] = 64'hFFA3009800AA0068;
        mem[59] = 64'h00440077005800D5;
        mem[60] = 64'h0008FF90FF690026;
        mem[61] = 64'hFF66FFD400860040;
        mem[62] = 64'h00650012FFF5FF46;
        mem[63] = 64'hFFBD007C0009005A;
        mem[64] = 64'h0059005CFF830001;
        mem[65] = 64'h002FFFADFFE5FFDF;
        mem[66] = 64'h001000550063FF9F;
        mem[67] = 64'hFFC0FF8C00060051;
        mem[68] = 64'hFFBBFFB700590028;
        mem[69] = 64'hFFFA006AFFED000C;
        mem[70] = 64'h007BFF8100330003;
        mem[71] = 64'h00310049FF9A0015;
        mem[72] = 64'hFF8100160012FFD1;
        mem[73] = 64'hFF91001C0035FF9A;
        mem[74] = 64'h001A006F004C007E;
        mem[75] = 64'hFFE60013FFD4007E;
        mem[76] = 64'hFFC8005BFFD80032;
        mem[77] = 64'h0068001AFFE3FF96;
        mem[78] = 64'h0046FF8B001EFFF0;
        mem[79] = 64'hFFA8FF96002C000F;
        mem[80] = 64'hFE5FFD2BFDB1FEB6;
        mem[81] = 64'hFEE8FEA20097FE93;
        mem[82] = 64'hFD66FCA9FC87FDBB;
        mem[83] = 64'hFE8EFEAAFEBFFF3A;
        mem[84] = 64'h00C3FF6D003000D6;
        mem[85] = 64'h01EB0018FF61FFA7;
        mem[86] = 64'hFEA00285066A07E4;
        mem[87] = 64'h0753058F0275FFAD;
        mem[88] = 64'hFFE9008802B5028E;
        mem[89] = 64'h013C0030004DFF67;
        mem[90] = 64'hFF41FD3CFE6F0000;
        mem[91] = 64'hFF31FE54FF58FF53;
        mem[92] = 64'hFF9FFD37FE42FF59;
        mem[93] = 64'hFF8DFE90FE89FF69;
        mem[94] = 64'hFFA1FF7CFF9CFF69;
        mem[95] = 64'hFECEFF82FEE6FF47;
        mem[96] = 64'h0022007C00230029;
        mem[97] = 64'hFFC2FFBBFFFF0021;
        mem[98] = 64'hFF98001E00030048;
        mem[99] = 64'hFF8EFFDB0039FFD3;
        mem[100] = 64'hFFE40077007DFFDC;
        mem[101] = 64'hFFC9FFB60051FFD8;
        mem[102] = 64'hFFBDFFABFF970056;
        mem[103] = 64'h004200720046006C;
        mem[104] = 64'h0002FFC30062FFB4;
        mem[105] = 64'h0018FFD40008FFC1;
        mem[106] = 64'hFF8CFFD7FFB80004;
        mem[107] = 64'h0024FFD4005E000A;
        mem[108] = 64'hFFDBFFA90053005E;
        mem[109] = 64'h0031FFCDFF8AFFD6;
        mem[110] = 64'h0040FFF8FFB5FF8C;
        mem[111] = 64'h003EFFC5007AFF90;
        mem[112] = 64'h00290038FFBAFFC7;
        mem[113] = 64'h00000064FFD60065;
        mem[114] = 64'h0043FFB5004AFF88;
        mem[115] = 64'hFF89FFBCFF8F0016;
        mem[116] = 64'hFFA80075000EFFE0;
        mem[117] = 64'h002700180030FFD1;
        mem[118] = 64'h002300480075FFDB;
        mem[119] = 64'hFFE2FF85FFB8003C;
        mem[120] = 64'h00740009FFF5FFEB;
        mem[121] = 64'h0007003EFFB5007C;
        mem[122] = 64'h003AFFF8FFE3FFAE;
        mem[123] = 64'h00330008002E0061;
        mem[124] = 64'hFFFDFFA1FFDDFFD8;
        mem[125] = 64'h0067FFB6FFC70047;
        mem[126] = 64'hFFF40072FFC7FFD7;
        mem[127] = 64'h00420062FF91FFCC;
        mem[128] = 64'hFFB7FFC80013002F;
        mem[129] = 64'hFF84003D002AFF9D;
        mem[130] = 64'hFFBC0020FFE7004B;
        mem[131] = 64'h000DFFE3FFDC0077;
        mem[132] = 64'h0065FF91FF97005F;
        mem[133] = 64'h0056FFD6FFD0FFD4;
        mem[134] = 64'hFFA7FFEEFFFA001A;
        mem[135] = 64'hFFA8FFE10038FF97;
        mem[136] = 64'hFFB1FFF100370008;
        mem[137] = 64'hFFD5FFD4FFCFFF98;
        mem[138] = 64'h001FFFD0FF81FF8A;
        mem[139] = 64'hFFE3FFF0FF87FFD9;
        mem[140] = 64'h002900370043002C;
        mem[141] = 64'h003B0070006C0067;
        mem[142] = 64'hFFE1FF96FF9BFFA8;
        mem[143] = 64'hFF85FFDCFF800065;
        mem[144] = 64'hFE0EFE7FFFB9FFCA;
        mem[145] = 64'hFF2FFED8FF34FF12;
        mem[146] = 64'h0027000F00E1FFEA;
        mem[147] = 64'h007500A2007C00DB;
        mem[148] = 64'hFF2F0001006800FD;
        mem[149] = 64'h00B10005FF89FFCB;
        mem[150] = 64'hFFBCFFF1002800E9;
        mem[151] = 64'h002000C6001C0015;
        mem[152] = 64'hFF0BFF9700D10083;
        mem[153] = 64'h00D4012300A6FF36;
        mem[154] = 64'hFFB4FFB900B0002B;
        mem[155] = 64'h00B3FFB4FFA00012;
        mem[156] = 64'hFF3AFEE6FED60042;
        mem[157] = 64'hFF9CFF4CFEF6FF97;
        mem[158] = 64'hFF22FF9A00A4FF56;
        mem[159] = 64'hFF72FFBFFF4F0073;
        mem[160] = 64'hFF56FFE2FFEC006A;
        mem[161] = 64'h00220017FFD2004A;
        mem[162] = 64'hFFB7FEC7FF68FF0D;
        mem[163] = 64'hFEFEFE2DFF47FEC2;
        mem[164] = 64'hFCE6FD4FFF06FDD0;
        mem[165] = 64'hFF64FE84004FFF0F;
        mem[166] = 64'h00B701540379029F;
        mem[167] = 64'h02C1038F0096FE9B;
        mem[168] = 64'hFCF2011D05480697;
        mem[169] = 64'h062402BA01F9FDEE;
        mem[170] = 64'hFE6EFE43FDD9FE88;
        mem[171] = 64'h00A0FDEDFD33FE42;
        mem[172] = 64'h003CFF46FFB2FF7D;
        mem[173] = 64'hFF72FE90FD57FE6A;
        mem[174] = 64'h013700720038009D;
        mem[175] = 64'h007CFFD6002D00B2;
        mem[176] = 64'hFE3B020A00080004;
        mem[177] = 64'hFF640002000FFF89;
        mem[178] = 64'h0132001F0192017D;
        mem[179] = 64'h00330041FFB3001F;
        mem[180] = 64'h003300670002FFA2;
        mem[181] = 64'hFF54FF0D007E003D;
        mem[182] = 64'h00BC005CFF380173;
        mem[183] = 64'h00C6FF98FE6DFFAB;
        mem[184] = 64'h008600DC012E010D;
        mem[185] = 64'h0288FFDE00730087;
        mem[186] = 64'hFF4CFF750146FF4B;
        mem[187] = 64'hFFBDFFF300A40039;
        mem[188] = 64'h0064FFB4FFA1FF3A;
        mem[189] = 64'hFF360047FFBD0008;
        mem[190] = 64'hFFD8FFC2011300A4;
        mem[191] = 64'h0048FF09FF8A002A;
        mem[192] = 64'hFEF9FF19008000EA;
        mem[193] = 64'hFFD2FF94FFDE002C;
        mem[194] = 64'hFFC8007C00FD0025;
        mem[195] = 64'hFF930039FF74000A;
        mem[196] = 64'h000D005000F90161;
        mem[197] = 64'h007B0077006C003A;
        mem[198] = 64'hFFBBFF75FE44FCD5;
        mem[199] = 64'hFCDCFED6FF9E010B;
        mem[200] = 64'h002EFFA9FEBCFE1C;
        mem[201] = 64'hFE3CFFBC0039011D;
        mem[202] = 64'h004CFFEE009F0084;
        mem[203] = 64'h00C00069007700A8;
        mem[204] = 64'h0015FF6EFF64FF94;
        mem[205] = 64'hFF5FFFBD00C200D1;
        mem[206] = 64'hFF71FF7BFF90FFBF;
        mem[207] = 64'hFF3D001AFFFA0084;
        mem[208] = 64'h00400034FFA8FFE3;
        mem[209] = 64'hFFCA005F003E0052;
        mem[210] = 64'hFFF4FF8CFFE70004;
        mem[211] = 64'h002F0015004C0015;
        mem[212] = 64'h0017FFBBFF81FFCD;
        mem[213] = 64'hFFD3FFD9FFCAFFC9;
        mem[214] = 64'hFFF3006FFFC4FFB0;
        mem[215] = 64'hFFE8FFD80009FFA4;
        mem[216] = 64'h00310019FFC10079;
        mem[217] = 64'h006EFFE3FF9DFFCF;
        mem[218] = 64'hFFF00017005A0013;
        mem[219] = 64'hFF9FFFE600210059;
        mem[220] = 64'h003EFFF50015FFD0;
        mem[221] = 64'hFFC30005FF9BFFD7;
        mem[222] = 64'h005DFFBE00170045;
        mem[223] = 64'h0014FFAFFF82FFF1;
        mem[224] = 64'hFF4AFFF50003FF8E;
        mem[225] = 64'h0046FFBA00B9FFCD;
        mem[226] = 64'hFF59FF9BFFBAFF23;
        mem[227] = 64'hFE50FE6500230001;
        mem[228] = 64'hFE33FDC3FDF6FD4D;
        mem[229] = 64'hFEFBFDF5FFB2004B;
        mem[230] = 64'hFFA0009A03A601E0;
        mem[231] = 64'h02FD03B1FFF10018;
        mem[232] = 64'hFDF10140051A05E2;
        mem[233] = 64'h05FF02C80199FFCE;
        mem[234] = 64'hFE3EFE0DFE9BFE78;
        mem[235] = 64'h0023FD6BFD04FF68;
        mem[236] = 64'h0089FFB0003AFF24;
        mem[237] = 64'hFE85FF30FD71FF66;
        mem[238] = 64'h01E3FFF80031FFF3;
        mem[239] = 64'hFFD1FF8CFF8E000E;
        mem[240] = 64'hFFB100A8FFBBFF8F;
        mem[241] = 64'hFCE2FE39FF6FFE99;
        mem[242] = 64'h008E012CFF18FFA2;
        mem[243] = 64'hFE5FFED2FFC1FF01;
        mem[244] = 64'hFF1801E5014E0153;
        mem[245] = 64'hFF2A022000F4FF8E;
        mem[246] = 64'h002C0006002601B8;
        mem[247] = 64'h0383051E01F00011;
        mem[248] = 64'h00960096FEC90087;
        mem[249] = 64'h01C9034701B9FF3E;
        mem[250] = 64'hFF6F007FFE7BFEDD;
        mem[251] = 64'hFE00023F0085FEE2;
        mem[252] = 64'hFF0AFFE5FF42FDD9;
        mem[253] = 64'hFE60019FFF3E004F;
        mem[254] = 64'hFEE7FEE0FDD0FE05;
        mem[255] = 64'hFE820152FDDC00B4;
    end
    always @(posedge clka) begin
        rd1 <= mem[addra];
        rd2 <= rd1;
    end
    assign douta = rd2;
endmodule

module drone_frame_rom (
    input  wire [11:0] addr,
    output wire [23:0] data
);
    (* rom_style = "block" *) reg [23:0] mem [0:4095];
    initial begin
        mem[0] = 24'h919294;
        mem[1] = 24'h808281;
        mem[2] = 24'h848484;
        mem[3] = 24'h5D5E59;
        mem[4] = 24'h4E4F49;
        mem[5] = 24'h41423A;
        mem[6] = 24'h4B4B43;
        mem[7] = 24'h515149;
        mem[8] = 24'h4E4E46;
        mem[9] = 24'h4A4A42;
        mem[10] = 24'h4D4C47;
        mem[11] = 24'h8E8D88;
        mem[12] = 24'h595853;
        mem[13] = 24'h090803;
        mem[14] = 24'h030200;
        mem[15] = 24'h070601;
        mem[16] = 24'h090806;
        mem[17] = 24'h0B0A08;
        mem[18] = 24'h0F0B08;
        mem[19] = 24'h15110E;
        mem[20] = 24'h16120F;
        mem[21] = 24'h1A1613;
        mem[22] = 24'h1B1714;
        mem[23] = 24'h1D1916;
        mem[24] = 24'h231E1B;
        mem[25] = 24'h25201D;
        mem[26] = 24'h292323;
        mem[27] = 24'h2E2828;
        mem[28] = 24'h2E2A2B;
        mem[29] = 24'h2C2829;
        mem[30] = 24'h2B2728;
        mem[31] = 24'h2D2928;
        mem[32] = 24'h2D2727;
        mem[33] = 24'h2F2A27;
        mem[34] = 24'h0D0804;
        mem[35] = 24'h191410;
        mem[36] = 24'h534C46;
        mem[37] = 24'h827B73;
        mem[38] = 24'h857E76;
        mem[39] = 24'h8F887E;
        mem[40] = 24'h958C83;
        mem[41] = 24'h948B82;
        mem[42] = 24'hA0978E;
        mem[43] = 24'hB3AAA1;
        mem[44] = 24'hB0A7A0;
        mem[45] = 24'hB3AAA3;
        mem[46] = 24'hA29994;
        mem[47] = 24'hA9A09B;
        mem[48] = 24'hA59E96;
        mem[49] = 24'hA69F97;
        mem[50] = 24'hA49B92;
        mem[51] = 24'hA69D94;
        mem[52] = 24'hAAA096;
        mem[53] = 24'hABA197;
        mem[54] = 24'hA69C90;
        mem[55] = 24'hABA195;
        mem[56] = 24'hABA195;
        mem[57] = 24'hABA195;
        mem[58] = 24'hA79F92;
        mem[59] = 24'hA9A194;
        mem[60] = 24'hA39D91;
        mem[61] = 24'hABA599;
        mem[62] = 24'hA39F94;
        mem[63] = 24'hA6A297;
        mem[64] = 24'h929395;
        mem[65] = 24'h868887;
        mem[66] = 24'h686866;
        mem[67] = 24'h53544F;
        mem[68] = 24'h6A6B65;
        mem[69] = 24'h55564E;
        mem[70] = 24'h5F5F57;
        mem[71] = 24'h5D5D55;
        mem[72] = 24'h5A5A52;
        mem[73] = 24'h505048;
        mem[74] = 24'h4A4944;
        mem[75] = 24'h696863;
        mem[76] = 24'h3D3C37;
        mem[77] = 24'h15140F;
        mem[78] = 24'h050400;
        mem[79] = 24'h050400;
        mem[80] = 24'h040300;
        mem[81] = 24'h060200;
        mem[82] = 24'h050200;
        mem[83] = 24'h080500;
        mem[84] = 24'h080500;
        mem[85] = 24'h0B0803;
        mem[86] = 24'h0B0602;
        mem[87] = 24'h0C0703;
        mem[88] = 24'h0E0905;
        mem[89] = 24'h0E0905;
        mem[90] = 24'h0E0906;
        mem[91] = 24'h0F0A07;
        mem[92] = 24'h0D0707;
        mem[93] = 24'h0A0605;
        mem[94] = 24'h0E0808;
        mem[95] = 24'h110B0B;
        mem[96] = 24'h120D0A;
        mem[97] = 24'h090400;
        mem[98] = 24'h1C1713;
        mem[99] = 24'h7B7670;
        mem[100] = 24'hA8A19B;
        mem[101] = 24'hB2ABA3;
        mem[102] = 24'hB8B1A7;
        mem[103] = 24'hB7B1A5;
        mem[104] = 24'hC0B7AE;
        mem[105] = 24'hC7BEB5;
        mem[106] = 24'hC1B8AF;
        mem[107] = 24'hB3AAA1;
        mem[108] = 24'hB5ACA3;
        mem[109] = 24'hA39A93;
        mem[110] = 24'h9F968F;
        mem[111] = 24'h9B928B;
        mem[112] = 24'hA29B93;
        mem[113] = 24'hA7A096;
        mem[114] = 24'h958C83;
        mem[115] = 24'h999186;
        mem[116] = 24'h998F85;
        mem[117] = 24'h93897D;
        mem[118] = 24'h998F83;
        mem[119] = 24'h958B7F;
        mem[120] = 24'h958B7F;
        mem[121] = 24'hA0968A;
        mem[122] = 24'h928A7D;
        mem[123] = 24'hA49C8F;
        mem[124] = 24'hA29C90;
        mem[125] = 24'hA09A8E;
        mem[126] = 24'hA9A298;
        mem[127] = 24'h9F9B90;
        mem[128] = 24'h919191;
        mem[129] = 24'h838383;
        mem[130] = 24'h71716F;
        mem[131] = 24'h7E7F7A;
        mem[132] = 24'h6E6F69;
        mem[133] = 24'h65665E;
        mem[134] = 24'h717167;
        mem[135] = 24'h69695F;
        mem[136] = 24'h5D5D53;
        mem[137] = 24'h55554B;
        mem[138] = 24'h66635C;
        mem[139] = 24'h69665F;
        mem[140] = 24'h4D4A43;
        mem[141] = 24'h5E5B54;
        mem[142] = 24'h7C7972;
        mem[143] = 24'h87847D;
        mem[144] = 24'h87847D;
        mem[145] = 24'h8A857F;
        mem[146] = 24'h8A857F;
        mem[147] = 24'h88837D;
        mem[148] = 24'h7D7872;
        mem[149] = 24'h6E6963;
        mem[150] = 24'h5D5650;
        mem[151] = 24'h524B45;
        mem[152] = 24'h443D37;
        mem[153] = 24'h39322C;
        mem[154] = 24'h2A221F;
        mem[155] = 24'h1E1613;
        mem[156] = 24'h160E0B;
        mem[157] = 24'h0E0905;
        mem[158] = 24'h0E0604;
        mem[159] = 24'h0E0603;
        mem[160] = 24'h110A04;
        mem[161] = 24'h4B443E;
        mem[162] = 24'h968F89;
        mem[163] = 24'hA7A098;
        mem[164] = 24'hB2ABA1;
        mem[165] = 24'hB3ADA1;
        mem[166] = 24'hBDB5AA;
        mem[167] = 24'hBFB7AA;
        mem[168] = 24'hBFB7AC;
        mem[169] = 24'hC4BCB1;
        mem[170] = 24'hC1B9AE;
        mem[171] = 24'hBCB4A9;
        mem[172] = 24'hAAA297;
        mem[173] = 24'hBBB2A9;
        mem[174] = 24'hBDB4AB;
        mem[175] = 24'hC0B7AE;
        mem[176] = 24'hBCB3AA;
        mem[177] = 24'hB9B1A6;
        mem[178] = 24'hB8B0A5;
        mem[179] = 24'hBEB6AB;
        mem[180] = 24'hB8AEA4;
        mem[181] = 24'hBDB3A7;
        mem[182] = 24'hC2B8AC;
        mem[183] = 24'hBAB1A2;
        mem[184] = 24'hC2B9AA;
        mem[185] = 24'hBCB3A4;
        mem[186] = 24'hB9B2A2;
        mem[187] = 24'hB8B1A1;
        mem[188] = 24'hB2AA9D;
        mem[189] = 24'hB3AD9F;
        mem[190] = 24'hA8A296;
        mem[191] = 24'hAAA498;
        mem[192] = 24'h909090;
        mem[193] = 24'h8E8E8C;
        mem[194] = 24'h70716C;
        mem[195] = 24'h7C7D77;
        mem[196] = 24'h777870;
        mem[197] = 24'h6B6D62;
        mem[198] = 24'h75756B;
        mem[199] = 24'h6B6B61;
        mem[200] = 24'h6B6B61;
        mem[201] = 24'h74746A;
        mem[202] = 24'h5E5B52;
        mem[203] = 24'h302D24;
        mem[204] = 24'h84817A;
        mem[205] = 24'h918E85;
        mem[206] = 24'h908D86;
        mem[207] = 24'h908D84;
        mem[208] = 24'h928E85;
        mem[209] = 24'h928E83;
        mem[210] = 24'h938C82;
        mem[211] = 24'h958E84;
        mem[212] = 24'h968F85;
        mem[213] = 24'h9B948A;
        mem[214] = 24'h9C958B;
        mem[215] = 24'h9E978D;
        mem[216] = 24'hA29990;
        mem[217] = 24'hA19A90;
        mem[218] = 24'hA69D96;
        mem[219] = 24'hACA59D;
        mem[220] = 24'hB2ABA3;
        mem[221] = 24'hB2ABA3;
        mem[222] = 24'hADA6A0;
        mem[223] = 24'hA9A29C;
        mem[224] = 24'hAAA39B;
        mem[225] = 24'hA9A298;
        mem[226] = 24'hAFA89E;
        mem[227] = 24'hB5AEA4;
        mem[228] = 24'hBEB8AC;
        mem[229] = 24'hBFB9AB;
        mem[230] = 24'hBAB2A5;
        mem[231] = 24'hC4BDAD;
        mem[232] = 24'hC5BDB0;
        mem[233] = 24'hBFB7AA;
        mem[234] = 24'hC1B9AC;
        mem[235] = 24'hB7AFA4;
        mem[236] = 24'hC5BDB2;
        mem[237] = 24'hC4BCB1;
        mem[238] = 24'hBEB6AB;
        mem[239] = 24'hBCB4A9;
        mem[240] = 24'hBDB5AA;
        mem[241] = 24'hC6BEB3;
        mem[242] = 24'hBDB5AA;
        mem[243] = 24'hBEB6A9;
        mem[244] = 24'hBFB5A9;
        mem[245] = 24'hBDB4A5;
        mem[246] = 24'hBEB5A6;
        mem[247] = 24'hBDB4A5;
        mem[248] = 24'hC2B9AA;
        mem[249] = 24'hBEB5A6;
        mem[250] = 24'hBAB3A3;
        mem[251] = 24'hBEB7A7;
        mem[252] = 24'hBDB5A8;
        mem[253] = 24'hBFB7AA;
        mem[254] = 24'hB9B3A7;
        mem[255] = 24'hBBB5A9;
        mem[256] = 24'h8E8E8C;
        mem[257] = 24'h888886;
        mem[258] = 24'h787773;
        mem[259] = 24'h85847F;
        mem[260] = 24'h7A7A72;
        mem[261] = 24'h74746A;
        mem[262] = 24'h7E7B72;
        mem[263] = 24'h79776B;
        mem[264] = 24'h615F53;
        mem[265] = 24'h232115;
        mem[266] = 24'h7E7C70;
        mem[267] = 24'h9F9D91;
        mem[268] = 24'h9B988F;
        mem[269] = 24'h98968A;
        mem[270] = 24'h98958C;
        mem[271] = 24'h9D998E;
        mem[272] = 24'hA09A8E;
        mem[273] = 24'hA39D91;
        mem[274] = 24'hA69E93;
        mem[275] = 24'hA9A196;
        mem[276] = 24'hA9A194;
        mem[277] = 24'hAEA699;
        mem[278] = 24'hAFA79A;
        mem[279] = 24'hB2AA9D;
        mem[280] = 24'hB2A89E;
        mem[281] = 24'hB1A99E;
        mem[282] = 24'hB3A99F;
        mem[283] = 24'hB2AA9F;
        mem[284] = 24'hB3AAA1;
        mem[285] = 24'hB3AAA1;
        mem[286] = 24'hB4ABA2;
        mem[287] = 24'hB4ABA2;
        mem[288] = 24'hB0AA9E;
        mem[289] = 24'hB7B1A5;
        mem[290] = 24'hC0B8AD;
        mem[291] = 24'hC1B9AC;
        mem[292] = 24'hC9C1B4;
        mem[293] = 24'hC9C2B2;
        mem[294] = 24'hC8BFB0;
        mem[295] = 24'hCBC2B1;
        mem[296] = 24'hD0C7B8;
        mem[297] = 24'hCDC4B5;
        mem[298] = 24'hB9B0A1;
        mem[299] = 24'hC3B9AD;
        mem[300] = 24'hC7BDB1;
        mem[301] = 24'hCBC1B5;
        mem[302] = 24'hC6BCB0;
        mem[303] = 24'hC6BCB0;
        mem[304] = 24'hCAC2B5;
        mem[305] = 24'hC1B9AC;
        mem[306] = 24'hC3B9AD;
        mem[307] = 24'hC5BCAD;
        mem[308] = 24'hC4BBAC;
        mem[309] = 24'hC8BFAE;
        mem[310] = 24'hC5B9A9;
        mem[311] = 24'hCBBFAF;
        mem[312] = 24'hC8BFAE;
        mem[313] = 24'hC9C0AF;
        mem[314] = 24'hC0B7A8;
        mem[315] = 24'hC7BEAF;
        mem[316] = 24'hC5BDB0;
        mem[317] = 24'hBFB7AA;
        mem[318] = 24'hC0B8AB;
        mem[319] = 24'hBBB3A6;
        mem[320] = 24'h8B8B89;
        mem[321] = 24'h7C7D78;
        mem[322] = 24'h6C6B66;
        mem[323] = 24'h86867E;
        mem[324] = 24'h7D7D73;
        mem[325] = 24'h7C7C70;
        mem[326] = 24'h69675B;
        mem[327] = 24'h2B291D;
        mem[328] = 24'h6C6A5E;
        mem[329] = 24'hA09E92;
        mem[330] = 24'h9B998D;
        mem[331] = 24'hA19F93;
        mem[332] = 24'h9E9C90;
        mem[333] = 24'h9C9A8E;
        mem[334] = 24'h9F9D91;
        mem[335] = 24'hA19D91;
        mem[336] = 24'hA39D8F;
        mem[337] = 24'hAAA393;
        mem[338] = 24'hAEA699;
        mem[339] = 24'hB4AD9D;
        mem[340] = 24'hB4AD9D;
        mem[341] = 24'hB9B2A2;
        mem[342] = 24'hBBB2A3;
        mem[343] = 24'hBDB4A5;
        mem[344] = 24'hC0B6AA;
        mem[345] = 24'hC0B6AA;
        mem[346] = 24'hC1B7AB;
        mem[347] = 24'hC1B7AB;
        mem[348] = 24'hC1B9AE;
        mem[349] = 24'hC1B9AE;
        mem[350] = 24'hC1B9AE;
        mem[351] = 24'hC2BAAD;
        mem[352] = 24'hC0B8AB;
        mem[353] = 24'hC2BCAE;
        mem[354] = 24'hC7BFB2;
        mem[355] = 24'hC5BEAE;
        mem[356] = 24'hC3BCAC;
        mem[357] = 24'hC9C2B2;
        mem[358] = 24'hC7BEAD;
        mem[359] = 24'hCAC1B0;
        mem[360] = 24'hBFB6A5;
        mem[361] = 24'hC1B8A7;
        mem[362] = 24'hC2B9AA;
        mem[363] = 24'hCEC5B6;
        mem[364] = 24'hC6BCB0;
        mem[365] = 24'hCAC0B4;
        mem[366] = 24'hCAC0B4;
        mem[367] = 24'hC8BEB2;
        mem[368] = 24'h9D9588;
        mem[369] = 24'hC9C1B4;
        mem[370] = 24'hCAC1B2;
        mem[371] = 24'hC9C0B1;
        mem[372] = 24'hC9C0AF;
        mem[373] = 24'hC6BDAC;
        mem[374] = 24'hCDC1B1;
        mem[375] = 24'hC6BAAA;
        mem[376] = 24'hC3BAA9;
        mem[377] = 24'hBDB4A3;
        mem[378] = 24'hC2B9AA;
        mem[379] = 24'hC1B8A9;
        mem[380] = 24'hC2BAAD;
        mem[381] = 24'hC6BEB1;
        mem[382] = 24'hC0B8AB;
        mem[383] = 24'hC5BDB0;
        mem[384] = 24'h696864;
        mem[385] = 24'h706F6B;
        mem[386] = 24'h6D6A65;
        mem[387] = 24'h78756E;
        mem[388] = 24'h6E6B62;
        mem[389] = 24'h38362A;
        mem[390] = 24'h625E53;
        mem[391] = 24'h979387;
        mem[392] = 24'h9E9A8E;
        mem[393] = 24'hA39F93;
        mem[394] = 24'hA8A498;
        mem[395] = 24'hABA79B;
        mem[396] = 24'hAAA69A;
        mem[397] = 24'hA6A296;
        mem[398] = 24'hA8A498;
        mem[399] = 24'hA9A697;
        mem[400] = 24'hAFA999;
        mem[401] = 24'hB5AE9C;
        mem[402] = 24'hB9B0A1;
        mem[403] = 24'hBDB4A3;
        mem[404] = 24'hBCB3A2;
        mem[405] = 24'hC2B9A8;
        mem[406] = 24'hC3BAAB;
        mem[407] = 24'hC4BBAC;
        mem[408] = 24'hC6BDAE;
        mem[409] = 24'hC5BCAD;
        mem[410] = 24'hC4BBAC;
        mem[411] = 24'hC5BCAD;
        mem[412] = 24'hC7BDB1;
        mem[413] = 24'hC8BEB2;
        mem[414] = 24'hC6BCB0;
        mem[415] = 24'hC3BBAE;
        mem[416] = 24'hCBC3B6;
        mem[417] = 24'hC7C0B0;
        mem[418] = 24'hC9C2B2;
        mem[419] = 24'hC7C0B0;
        mem[420] = 24'hCCC3B4;
        mem[421] = 24'hC9C0AF;
        mem[422] = 24'hC9C0AF;
        mem[423] = 24'hAFA695;
        mem[424] = 24'hC7BEAD;
        mem[425] = 24'hCBC2B1;
        mem[426] = 24'hCAC1B2;
        mem[427] = 24'hC8BFB0;
        mem[428] = 24'hD0C7B8;
        mem[429] = 24'hD2C9BA;
        mem[430] = 24'hCAC0B4;
        mem[431] = 24'hD0C6BA;
        mem[432] = 24'hCEC5B6;
        mem[433] = 24'hCDC4B5;
        mem[434] = 24'hC5BCAD;
        mem[435] = 24'hCAC1B2;
        mem[436] = 24'hC8BFB0;
        mem[437] = 24'hC7BEAF;
        mem[438] = 24'hCDC1B1;
        mem[439] = 24'hCDC1B1;
        mem[440] = 24'hCDC1B3;
        mem[441] = 24'hCABEB0;
        mem[442] = 24'hC8BFB0;
        mem[443] = 24'hC5BCAD;
        mem[444] = 24'hC5BBAF;
        mem[445] = 24'hC8BEB2;
        mem[446] = 24'hC7BDB3;
        mem[447] = 24'hC9BFB5;
        mem[448] = 24'h979692;
        mem[449] = 24'h85847F;
        mem[450] = 24'h79766F;
        mem[451] = 24'h2F2C23;
        mem[452] = 24'h47443B;
        mem[453] = 24'h959387;
        mem[454] = 24'hA09C90;
        mem[455] = 24'hA29E92;
        mem[456] = 24'hA6A296;
        mem[457] = 24'hA7A397;
        mem[458] = 24'hA7A397;
        mem[459] = 24'hB6B2A6;
        mem[460] = 24'hB0ACA0;
        mem[461] = 24'hACA99A;
        mem[462] = 24'hACA99A;
        mem[463] = 24'hB4AE9E;
        mem[464] = 24'hB0A999;
        mem[465] = 24'hB8B19F;
        mem[466] = 24'hBEB5A4;
        mem[467] = 24'hC4BBAA;
        mem[468] = 24'hC5BCAD;
        mem[469] = 24'hC9C0B1;
        mem[470] = 24'hC7BEAF;
        mem[471] = 24'hC5BCAD;
        mem[472] = 24'hC5BCAD;
        mem[473] = 24'hC6BDAE;
        mem[474] = 24'hC8BFB0;
        mem[475] = 24'hC8BEB2;
        mem[476] = 24'hC9BFB3;
        mem[477] = 24'hCAC0B4;
        mem[478] = 24'hCAC0B4;
        mem[479] = 24'hCAC0B4;
        mem[480] = 24'hC7C0B0;
        mem[481] = 24'hCAC3B3;
        mem[482] = 24'hC7C0B0;
        mem[483] = 24'hCAC3B3;
        mem[484] = 24'hC8BFAE;
        mem[485] = 24'hCAC1B0;
        mem[486] = 24'hA39A89;
        mem[487] = 24'hCCC3B2;
        mem[488] = 24'hCAC1B0;
        mem[489] = 24'hCDC4B3;
        mem[490] = 24'hC9C0B1;
        mem[491] = 24'hCEC5B6;
        mem[492] = 24'hCDC4B5;
        mem[493] = 24'hCAC1B2;
        mem[494] = 24'hD0C6BA;
        mem[495] = 24'hCCC2B6;
        mem[496] = 24'hCCC2B6;
        mem[497] = 24'hCCC3B4;
        mem[498] = 24'hCAC1B2;
        mem[499] = 24'hCDC4B5;
        mem[500] = 24'hCAC1B2;
        mem[501] = 24'hCCC3B4;
        mem[502] = 24'hCDC1B3;
        mem[503] = 24'hCCC0B2;
        mem[504] = 24'hCDC1B3;
        mem[505] = 24'hCCC0B2;
        mem[506] = 24'hCEC5B6;
        mem[507] = 24'hCBC1B5;
        mem[508] = 24'hCBC1B5;
        mem[509] = 24'hCCC2B6;
        mem[510] = 24'hCBC1B7;
        mem[511] = 24'hCBC1B7;
        mem[512] = 24'h413E39;
        mem[513] = 24'h45423D;
        mem[514] = 24'h413E37;
        mem[515] = 24'h8B887F;
        mem[516] = 24'hA6A299;
        mem[517] = 24'hA8A499;
        mem[518] = 24'hADA79B;
        mem[519] = 24'hB8B2A6;
        mem[520] = 24'hB8B2A6;
        mem[521] = 24'hB6B0A4;
        mem[522] = 24'hB8B2A6;
        mem[523] = 24'hBDB7AB;
        mem[524] = 24'hBDB7A9;
        mem[525] = 24'hB9B3A5;
        mem[526] = 24'hBBB5A7;
        mem[527] = 24'hC2BCAC;
        mem[528] = 24'hC8C1B1;
        mem[529] = 24'hC8C1B1;
        mem[530] = 24'hC8C1B1;
        mem[531] = 24'hC9C2B2;
        mem[532] = 24'hCBC1B5;
        mem[533] = 24'hCCC2B6;
        mem[534] = 24'hCCC2B6;
        mem[535] = 24'hCAC0B4;
        mem[536] = 24'hCCC2B6;
        mem[537] = 24'hAAA094;
        mem[538] = 24'h7E7468;
        mem[539] = 24'hCCC2B8;
        mem[540] = 24'hC9C1B6;
        mem[541] = 24'hCAC2B7;
        mem[542] = 24'hC7BFB4;
        mem[543] = 24'hCAC2B5;
        mem[544] = 24'hCBC4B4;
        mem[545] = 24'hA49D8D;
        mem[546] = 24'hC0B7A8;
        mem[547] = 24'hC9C0B1;
        mem[548] = 24'hC9C0B1;
        mem[549] = 24'hABA293;
        mem[550] = 24'hC5BCAD;
        mem[551] = 24'hCBC2B3;
        mem[552] = 24'hCCC3B4;
        mem[553] = 24'hCCC3B4;
        mem[554] = 24'hCDC3B7;
        mem[555] = 24'hCCC2B6;
        mem[556] = 24'hCCC2B6;
        mem[557] = 24'hCCC2B6;
        mem[558] = 24'hCDC3B9;
        mem[559] = 24'hCFC5B9;
        mem[560] = 24'hCBC1B5;
        mem[561] = 24'hCCC2B6;
        mem[562] = 24'hCCC2B6;
        mem[563] = 24'hCBC1B5;
        mem[564] = 24'hCBC1B5;
        mem[565] = 24'hCCC2B6;
        mem[566] = 24'hCCC2B6;
        mem[567] = 24'hCCC2B6;
        mem[568] = 24'hCDC3B7;
        mem[569] = 24'hCCC2B6;
        mem[570] = 24'hCCC2B6;
        mem[571] = 24'hCBC1B7;
        mem[572] = 24'hCBC1B7;
        mem[573] = 24'hCCC2B8;
        mem[574] = 24'hCCC2B9;
        mem[575] = 24'hCDC3BA;
        mem[576] = 24'hCECBC6;
        mem[577] = 24'hC7C4BF;
        mem[578] = 24'hB9B6AF;
        mem[579] = 24'hBCB9B0;
        mem[580] = 24'hC7C3B8;
        mem[581] = 24'hBEBAAF;
        mem[582] = 24'hC4BEB2;
        mem[583] = 24'hBFB9AD;
        mem[584] = 24'hBFB9AD;
        mem[585] = 24'hBDB7AB;
        mem[586] = 24'hC0BAAE;
        mem[587] = 24'hC4BEB2;
        mem[588] = 24'hC3BDAF;
        mem[589] = 24'hC0BAAC;
        mem[590] = 24'hC1BBAB;
        mem[591] = 24'hC6C0B0;
        mem[592] = 24'hC9C2B2;
        mem[593] = 24'hCAC3B3;
        mem[594] = 24'hCBC3B6;
        mem[595] = 24'hCCC4B7;
        mem[596] = 24'hD0C6BA;
        mem[597] = 24'hD2C8BC;
        mem[598] = 24'hD2C8BC;
        mem[599] = 24'hD1C7BB;
        mem[600] = 24'hD5CBC1;
        mem[601] = 24'hD3C9BF;
        mem[602] = 24'hD1C7BD;
        mem[603] = 24'hD1C7BD;
        mem[604] = 24'hCFC7BC;
        mem[605] = 24'hD0C8BD;
        mem[606] = 24'hD2CABF;
        mem[607] = 24'hCFC7BC;
        mem[608] = 24'hCFC7BA;
        mem[609] = 24'hD6CFBF;
        mem[610] = 24'hDBD2C3;
        mem[611] = 24'hCAC1B2;
        mem[612] = 24'hBEB5A6;
        mem[613] = 24'hC0B7A8;
        mem[614] = 24'hCFC6B7;
        mem[615] = 24'hD3CABB;
        mem[616] = 24'hCEC5B6;
        mem[617] = 24'hCFC5B9;
        mem[618] = 24'hCFC5B9;
        mem[619] = 24'hCEC4B8;
        mem[620] = 24'hCDC3B7;
        mem[621] = 24'hCDC3B7;
        mem[622] = 24'hCEC4BA;
        mem[623] = 24'hCFC5BB;
        mem[624] = 24'hCEC4BA;
        mem[625] = 24'hCFC5B9;
        mem[626] = 24'hCEC4B8;
        mem[627] = 24'hCBC1B5;
        mem[628] = 24'hC8BEB2;
        mem[629] = 24'hC7BDB1;
        mem[630] = 24'hCAC0B4;
        mem[631] = 24'hCCC2B6;
        mem[632] = 24'hCAC0B4;
        mem[633] = 24'hCBC1B5;
        mem[634] = 24'hCDC3B9;
        mem[635] = 24'hCEC4BA;
        mem[636] = 24'hCEC4BA;
        mem[637] = 24'hCDC3B9;
        mem[638] = 24'hCCC2B9;
        mem[639] = 24'hCBC1B8;
        mem[640] = 24'hC2BDB9;
        mem[641] = 24'hC3BEBA;
        mem[642] = 24'hBFBAB4;
        mem[643] = 24'hBEBAB1;
        mem[644] = 24'hC2BBB1;
        mem[645] = 24'hC8C2B6;
        mem[646] = 24'hC5BFB3;
        mem[647] = 24'hC4BEB2;
        mem[648] = 24'hC3BBB0;
        mem[649] = 24'hC2BAAF;
        mem[650] = 24'hC4BCB1;
        mem[651] = 24'hC7BFB4;
        mem[652] = 24'hC6BEB1;
        mem[653] = 24'hC2BAAD;
        mem[654] = 24'hC3BCAC;
        mem[655] = 24'hC7C0B0;
        mem[656] = 24'hC9C1B4;
        mem[657] = 24'hCAC2B5;
        mem[658] = 24'hCBC3B8;
        mem[659] = 24'hCCC4B9;
        mem[660] = 24'hCEC6BB;
        mem[661] = 24'hD0C8BD;
        mem[662] = 24'hD1C7BD;
        mem[663] = 24'hD0C6BC;
        mem[664] = 24'hD0C7BE;
        mem[665] = 24'hD3CAC1;
        mem[666] = 24'hD5CCC3;
        mem[667] = 24'hD6CDC4;
        mem[668] = 24'hD5CCC3;
        mem[669] = 24'hD7CEC5;
        mem[670] = 24'hD3CAC1;
        mem[671] = 24'hD7CFC4;
        mem[672] = 24'hCDC5B8;
        mem[673] = 24'hD4CCBF;
        mem[674] = 24'hBEB4A8;
        mem[675] = 24'hC6BCB0;
        mem[676] = 24'hD6CCC0;
        mem[677] = 24'hD9CFC3;
        mem[678] = 24'hD2C8BC;
        mem[679] = 24'hD1C7BB;
        mem[680] = 24'hD3C9BD;
        mem[681] = 24'hD2C8BE;
        mem[682] = 24'hD1C7BD;
        mem[683] = 24'hCFC5BB;
        mem[684] = 24'hCDC3B9;
        mem[685] = 24'hCBC1B7;
        mem[686] = 24'hCAC1B8;
        mem[687] = 24'hCAC1B8;
        mem[688] = 24'hC1B7AE;
        mem[689] = 24'hC3B9AF;
        mem[690] = 24'hC4BAB0;
        mem[691] = 24'hC3B9AF;
        mem[692] = 24'hC3B9AF;
        mem[693] = 24'hC5BBB1;
        mem[694] = 24'hC9BFB5;
        mem[695] = 24'hCBC1B7;
        mem[696] = 24'hCEC4BA;
        mem[697] = 24'hCEC4BA;
        mem[698] = 24'hCDC3BA;
        mem[699] = 24'hCDC3BA;
        mem[700] = 24'hCDC3BA;
        mem[701] = 24'hCEC4BB;
        mem[702] = 24'hCFC5BC;
        mem[703] = 24'hCFC5BC;
        mem[704] = 24'hC6C1BD;
        mem[705] = 24'hC2BDB7;
        mem[706] = 24'hC5C1B8;
        mem[707] = 24'hC2BEB3;
        mem[708] = 24'hC8C1B7;
        mem[709] = 24'hC5BFB3;
        mem[710] = 24'hC3BDB1;
        mem[711] = 24'hC4BEB2;
        mem[712] = 24'hC5BDB2;
        mem[713] = 24'hC4BCB1;
        mem[714] = 24'hC6BEB3;
        mem[715] = 24'hC8C0B5;
        mem[716] = 24'hC7BFB4;
        mem[717] = 24'hC4BCAF;
        mem[718] = 24'hC4BCAF;
        mem[719] = 24'hC8C1B1;
        mem[720] = 24'hC7BFB2;
        mem[721] = 24'hC8C0B3;
        mem[722] = 24'hC9C1B6;
        mem[723] = 24'hCAC2B7;
        mem[724] = 24'hCCC4B9;
        mem[725] = 24'hCDC5BA;
        mem[726] = 24'hCEC4BB;
        mem[727] = 24'hCDC3BA;
        mem[728] = 24'hD0C7BE;
        mem[729] = 24'hD1C8BF;
        mem[730] = 24'hD2C9C0;
        mem[731] = 24'hD2C9C0;
        mem[732] = 24'hD4CBC2;
        mem[733] = 24'hD0C7BE;
        mem[734] = 24'hD8CFC6;
        mem[735] = 24'hD2CABF;
        mem[736] = 24'hD6CEC3;
        mem[737] = 24'hB2AA9D;
        mem[738] = 24'hD1C7BB;
        mem[739] = 24'hD2C8BC;
        mem[740] = 24'hD5CBBF;
        mem[741] = 24'hD2C8BC;
        mem[742] = 24'hD4CABE;
        mem[743] = 24'hD7CDC1;
        mem[744] = 24'hD6CCC2;
        mem[745] = 24'hD7CDC3;
        mem[746] = 24'hD7CDC3;
        mem[747] = 24'hD6CCC2;
        mem[748] = 24'hD6CCC2;
        mem[749] = 24'hD5CBC1;
        mem[750] = 24'hD4CBC2;
        mem[751] = 24'hD4CBC2;
        mem[752] = 24'hD7CDC4;
        mem[753] = 24'hD6CCC3;
        mem[754] = 24'hD5CBC1;
        mem[755] = 24'hD4CAC0;
        mem[756] = 24'hD4CAC0;
        mem[757] = 24'hD4CAC0;
        mem[758] = 24'hD1C7BD;
        mem[759] = 24'hCFC5BB;
        mem[760] = 24'hCAC0B6;
        mem[761] = 24'hC8BEB4;
        mem[762] = 24'hC5BBB2;
        mem[763] = 24'hC3B9B0;
        mem[764] = 24'hC3B9B0;
        mem[765] = 24'hC5BBB2;
        mem[766] = 24'hC8BEB5;
        mem[767] = 24'hCAC0B7;
        mem[768] = 24'hCCC5BF;
        mem[769] = 24'hC6BFB9;
        mem[770] = 24'hC5BEB6;
        mem[771] = 24'hC2BBB1;
        mem[772] = 24'hC6BDB4;
        mem[773] = 24'hC6BEB3;
        mem[774] = 24'hC7BFB4;
        mem[775] = 24'hC5BDB2;
        mem[776] = 24'hC5BBB1;
        mem[777] = 24'hC5BBB1;
        mem[778] = 24'hC6BCB3;
        mem[779] = 24'hC7BDB3;
        mem[780] = 24'hC6BCB2;
        mem[781] = 24'hC4BAAE;
        mem[782] = 24'hC5BBAF;
        mem[783] = 24'hC8BEB2;
        mem[784] = 24'hC8BEB2;
        mem[785] = 24'hC9BFB3;
        mem[786] = 24'hCAC0B4;
        mem[787] = 24'hCBC1B5;
        mem[788] = 24'hCDC3B9;
        mem[789] = 24'hCFC5BB;
        mem[790] = 24'hCFC5BC;
        mem[791] = 24'hCFC5BC;
        mem[792] = 24'hD0C6BD;
        mem[793] = 24'hCDC3BA;
        mem[794] = 24'hD2C8BF;
        mem[795] = 24'hD3C9C0;
        mem[796] = 24'hD2C9C0;
        mem[797] = 24'hD6CDC4;
        mem[798] = 24'hD1C9BE;
        mem[799] = 24'hD3CBC0;
        mem[800] = 24'hA59D92;
        mem[801] = 24'hD4CCC1;
        mem[802] = 24'hCEC6BB;
        mem[803] = 24'hD4CCC1;
        mem[804] = 24'hD1C9BE;
        mem[805] = 24'hD0C8BD;
        mem[806] = 24'hD7CDC3;
        mem[807] = 24'hD2C8BE;
        mem[808] = 24'hD2C8BE;
        mem[809] = 24'hD2C8BE;
        mem[810] = 24'hD2CABF;
        mem[811] = 24'hD2CABF;
        mem[812] = 24'hD2CABF;
        mem[813] = 24'hD2CABF;
        mem[814] = 24'hD1C8BF;
        mem[815] = 24'hD1C8BF;
        mem[816] = 24'hD1C8BF;
        mem[817] = 24'hD2C9C0;
        mem[818] = 24'hD2C9C0;
        mem[819] = 24'hD3CAC1;
        mem[820] = 24'hD5CCC3;
        mem[821] = 24'hD6CDC4;
        mem[822] = 24'hD5CCC3;
        mem[823] = 24'hD2C9C0;
        mem[824] = 24'hD2CABF;
        mem[825] = 24'hD2CABF;
        mem[826] = 24'hD1C9BE;
        mem[827] = 24'hD1C9BE;
        mem[828] = 24'hD2C8BE;
        mem[829] = 24'hD2C8BE;
        mem[830] = 24'hD2C8BE;
        mem[831] = 24'hD2C8BE;
        mem[832] = 24'hCFC8C2;
        mem[833] = 24'hCAC3BD;
        mem[834] = 24'hC5BEB6;
        mem[835] = 24'hC8C1B9;
        mem[836] = 24'hC7BEB5;
        mem[837] = 24'hC7BFB4;
        mem[838] = 24'hC5BDB2;
        mem[839] = 24'hC2BAAF;
        mem[840] = 24'hC4BAB0;
        mem[841] = 24'hC4BAB0;
        mem[842] = 24'hC4BAB1;
        mem[843] = 24'hC4BAB1;
        mem[844] = 24'hC3B9AF;
        mem[845] = 24'hC3B9AF;
        mem[846] = 24'hC4BAAE;
        mem[847] = 24'hC7BDB1;
        mem[848] = 24'hC9BFB3;
        mem[849] = 24'hCAC0B4;
        mem[850] = 24'hCAC0B4;
        mem[851] = 24'hCAC0B4;
        mem[852] = 24'hCBC1B7;
        mem[853] = 24'hCDC3B9;
        mem[854] = 24'hCEC4BB;
        mem[855] = 24'hCEC4BB;
        mem[856] = 24'hCFC5BC;
        mem[857] = 24'hCFC5BC;
        mem[858] = 24'hD1C7BE;
        mem[859] = 24'hD0C6BD;
        mem[860] = 24'hD1C8BF;
        mem[861] = 24'hCCC4B9;
        mem[862] = 24'hD0C8BD;
        mem[863] = 24'hB3ABA0;
        mem[864] = 24'hCFC7BC;
        mem[865] = 24'hC7BFB4;
        mem[866] = 24'hD3CBC0;
        mem[867] = 24'hD0C8BD;
        mem[868] = 24'hCEC6BB;
        mem[869] = 24'hD4CCC1;
        mem[870] = 24'hD1C7BD;
        mem[871] = 24'hD1C7BD;
        mem[872] = 24'hD3C9BF;
        mem[873] = 24'hD3C9BF;
        mem[874] = 24'hD1C9BE;
        mem[875] = 24'hD1C9BE;
        mem[876] = 24'hD0C8BD;
        mem[877] = 24'hCFC7BC;
        mem[878] = 24'hCEC5BC;
        mem[879] = 24'hCEC5BC;
        mem[880] = 24'hD2C9C0;
        mem[881] = 24'hD3CAC1;
        mem[882] = 24'hD4CBC2;
        mem[883] = 24'hD3CAC1;
        mem[884] = 24'hD2C9C0;
        mem[885] = 24'hD2C9C0;
        mem[886] = 24'hD3CAC1;
        mem[887] = 24'hD3CAC1;
        mem[888] = 24'hD1C9BE;
        mem[889] = 24'hD2CABF;
        mem[890] = 24'hD2CABF;
        mem[891] = 24'hD2CABF;
        mem[892] = 24'hD3C9BF;
        mem[893] = 24'hD2C8BE;
        mem[894] = 24'hD1C7BD;
        mem[895] = 24'hD0C6BC;
        mem[896] = 24'hD1CAC4;
        mem[897] = 24'hC8C1BB;
        mem[898] = 24'hC8C1B9;
        mem[899] = 24'hC5BEB6;
        mem[900] = 24'hC6BDB4;
        mem[901] = 24'hC2B9B0;
        mem[902] = 24'hC5BBB1;
        mem[903] = 24'hC5BBB1;
        mem[904] = 24'hC6BCB3;
        mem[905] = 24'hC5BBB2;
        mem[906] = 24'hC5BBB2;
        mem[907] = 24'hC5BBB2;
        mem[908] = 24'hC4BAB0;
        mem[909] = 24'hC4BAB0;
        mem[910] = 24'hC6BCB2;
        mem[911] = 24'hC8BEB2;
        mem[912] = 24'hCBBFB3;
        mem[913] = 24'hCCC0B2;
        mem[914] = 24'hCBBFB1;
        mem[915] = 24'hCBBFB1;
        mem[916] = 24'hCCC0B4;
        mem[917] = 24'hCDC1B5;
        mem[918] = 24'hCFC2B9;
        mem[919] = 24'hCFC2B9;
        mem[920] = 24'hD0C3BA;
        mem[921] = 24'hD3C6BD;
        mem[922] = 24'hD0C6BC;
        mem[923] = 24'hCFC5BB;
        mem[924] = 24'hCBC1B7;
        mem[925] = 24'hCFC5BB;
        mem[926] = 24'hB1A79D;
        mem[927] = 24'hCCC2B6;
        mem[928] = 24'hCCC4B9;
        mem[929] = 24'hD4CCC1;
        mem[930] = 24'hD1C9BE;
        mem[931] = 24'hD0C8BD;
        mem[932] = 24'hD2CABF;
        mem[933] = 24'hD2CABF;
        mem[934] = 24'hCCC4B9;
        mem[935] = 24'hD0C8BD;
        mem[936] = 24'hCFC7BC;
        mem[937] = 24'hCFC7BC;
        mem[938] = 24'hCEC6BB;
        mem[939] = 24'hCDC5BA;
        mem[940] = 24'hCEC6BB;
        mem[941] = 24'hCEC6BB;
        mem[942] = 24'hCEC8BC;
        mem[943] = 24'hCFC9BD;
        mem[944] = 24'hCEC5BC;
        mem[945] = 24'hD0C7BE;
        mem[946] = 24'hD1C8BF;
        mem[947] = 24'hD0C7BE;
        mem[948] = 24'hCDC6BC;
        mem[949] = 24'hCEC7BD;
        mem[950] = 24'hCFC9BD;
        mem[951] = 24'hD0CABE;
        mem[952] = 24'hD2CABF;
        mem[953] = 24'hD1C9BE;
        mem[954] = 24'hD1C9BE;
        mem[955] = 24'hD0C8BD;
        mem[956] = 24'hD0C8BD;
        mem[957] = 24'hCFC7BC;
        mem[958] = 24'hD0C6BA;
        mem[959] = 24'hD1C7BB;
        mem[960] = 24'hCDC6C0;
        mem[961] = 24'hCEC7C1;
        mem[962] = 24'hC9C2BA;
        mem[963] = 24'hCCC5BB;
        mem[964] = 24'hBBB2A9;
        mem[965] = 24'hCBC3B8;
        mem[966] = 24'hC3B9AF;
        mem[967] = 24'hC7BDB3;
        mem[968] = 24'hC5BBB1;
        mem[969] = 24'hC5BBB2;
        mem[970] = 24'hC5BBB2;
        mem[971] = 24'hC4BAB1;
        mem[972] = 24'hC3B9AF;
        mem[973] = 24'hC4BAB0;
        mem[974] = 24'hC5BBB1;
        mem[975] = 24'hC6BCB0;
        mem[976] = 24'hCBBFB1;
        mem[977] = 24'hCBBFB1;
        mem[978] = 24'hCBBFB1;
        mem[979] = 24'hCBBFB1;
        mem[980] = 24'hCDC1B5;
        mem[981] = 24'hD0C4B8;
        mem[982] = 24'hD2C5BC;
        mem[983] = 24'hD4C7BE;
        mem[984] = 24'hD6C9C0;
        mem[985] = 24'hD3C6BD;
        mem[986] = 24'hD1C7BD;
        mem[987] = 24'hCFC5BB;
        mem[988] = 24'hAFA59B;
        mem[989] = 24'hBAB0A6;
        mem[990] = 24'hCEC4B8;
        mem[991] = 24'hCEC6B9;
        mem[992] = 24'hCEC6BB;
        mem[993] = 24'hD3CBC0;
        mem[994] = 24'hCFC7BC;
        mem[995] = 24'hD1C9BE;
        mem[996] = 24'hD1C9BE;
        mem[997] = 24'hD1C9BE;
        mem[998] = 24'hCFC7BC;
        mem[999] = 24'hD0C8BD;
        mem[1000] = 24'hD0C8BD;
        mem[1001] = 24'hCEC6BB;
        mem[1002] = 24'hCCC4B9;
        mem[1003] = 24'hCBC3B8;
        mem[1004] = 24'hCBC3B8;
        mem[1005] = 24'hCCC4B9;
        mem[1006] = 24'hCEC6BB;
        mem[1007] = 24'hCFC7BC;
        mem[1008] = 24'hD1C8BF;
        mem[1009] = 24'hD0C7BE;
        mem[1010] = 24'hD0C7BE;
        mem[1011] = 24'hD0C7BE;
        mem[1012] = 24'hD0C9BF;
        mem[1013] = 24'hD0C9BF;
        mem[1014] = 24'hCFC9BD;
        mem[1015] = 24'hCEC8BC;
        mem[1016] = 24'hD0C8BD;
        mem[1017] = 24'hD0C8BD;
        mem[1018] = 24'hD0C8BD;
        mem[1019] = 24'hD0C8BD;
        mem[1020] = 24'hD0C8BD;
        mem[1021] = 24'hCFC7BC;
        mem[1022] = 24'hCFC7BA;
        mem[1023] = 24'hCEC6B9;
        mem[1024] = 24'hC9C2BC;
        mem[1025] = 24'hC1BAB4;
        mem[1026] = 24'hB8AFA8;
        mem[1027] = 24'hB1A89F;
        mem[1028] = 24'hAEA69B;
        mem[1029] = 24'hAFA79A;
        mem[1030] = 24'hB3A99D;
        mem[1031] = 24'hB5AB9F;
        mem[1032] = 24'hBBAFA3;
        mem[1033] = 24'hBEB1A8;
        mem[1034] = 24'hC2B5AC;
        mem[1035] = 24'hC5B8AF;
        mem[1036] = 24'hC5BBB1;
        mem[1037] = 24'hC7BDB3;
        mem[1038] = 24'hC7BDB1;
        mem[1039] = 24'hC7BDB1;
        mem[1040] = 24'hC9C0B1;
        mem[1041] = 24'hC8BFB0;
        mem[1042] = 24'hCFC3B5;
        mem[1043] = 24'hCBBFB1;
        mem[1044] = 24'hCFC3B7;
        mem[1045] = 24'hD4C8BC;
        mem[1046] = 24'hCEC2B6;
        mem[1047] = 24'hD1C5B9;
        mem[1048] = 24'hD0C6BA;
        mem[1049] = 24'hD1C7BB;
        mem[1050] = 24'hD5CBBF;
        mem[1051] = 24'hAFA599;
        mem[1052] = 24'hC8C0B3;
        mem[1053] = 24'hCAC2B5;
        mem[1054] = 24'hCAC2B5;
        mem[1055] = 24'hCDC5B8;
        mem[1056] = 24'hD0C8BD;
        mem[1057] = 24'hD4CBC2;
        mem[1058] = 24'hD1C9BE;
        mem[1059] = 24'hCDC5BA;
        mem[1060] = 24'hD0C8BB;
        mem[1061] = 24'hD0C8BB;
        mem[1062] = 24'hCDC5B8;
        mem[1063] = 24'hCDC5B8;
        mem[1064] = 24'hCDC5BA;
        mem[1065] = 24'hCAC2B7;
        mem[1066] = 24'hC9BFB6;
        mem[1067] = 24'hCAC0B7;
        mem[1068] = 24'hCBC1B7;
        mem[1069] = 24'hCCC2B8;
        mem[1070] = 24'hCDC3B7;
        mem[1071] = 24'hCEC4BA;
        mem[1072] = 24'hCFC6BD;
        mem[1073] = 24'hCEC7BD;
        mem[1074] = 24'hCFC6BD;
        mem[1075] = 24'hCFC6BD;
        mem[1076] = 24'hD0C8BD;
        mem[1077] = 24'hD0C8BD;
        mem[1078] = 24'hCFC7BC;
        mem[1079] = 24'hCFC7BC;
        mem[1080] = 24'hCFC7BC;
        mem[1081] = 24'hCFC7BC;
        mem[1082] = 24'hCEC6B9;
        mem[1083] = 24'hCEC6B9;
        mem[1084] = 24'hCDC5B8;
        mem[1085] = 24'hCDC5B8;
        mem[1086] = 24'hCEC6B9;
        mem[1087] = 24'hCDC7B9;
        mem[1088] = 24'hCBC4BE;
        mem[1089] = 24'hC7C0BA;
        mem[1090] = 24'hC4BBB4;
        mem[1091] = 24'hC2B9B0;
        mem[1092] = 24'hC2BAAF;
        mem[1093] = 24'hC2BAAD;
        mem[1094] = 24'hC2B8AC;
        mem[1095] = 24'hC1B8A9;
        mem[1096] = 24'hC9BDB1;
        mem[1097] = 24'hC7BBAF;
        mem[1098] = 24'hC4B7AE;
        mem[1099] = 24'hBFB2A9;
        mem[1100] = 24'hB9AFA5;
        mem[1101] = 24'hB8AEA4;
        mem[1102] = 24'hB8AEA2;
        mem[1103] = 24'hB8AEA2;
        mem[1104] = 24'hB9B0A1;
        mem[1105] = 24'hBAB1A2;
        mem[1106] = 24'hB9AD9F;
        mem[1107] = 24'hC5B9AB;
        mem[1108] = 24'hC6BAAE;
        mem[1109] = 24'hC6BAAE;
        mem[1110] = 24'hD3C7BB;
        mem[1111] = 24'hD2C6BA;
        mem[1112] = 24'hD1C7BB;
        mem[1113] = 24'hD4CABE;
        mem[1114] = 24'h9F9589;
        mem[1115] = 24'hCBC1B5;
        mem[1116] = 24'hC6BEB1;
        mem[1117] = 24'hD1C9BC;
        mem[1118] = 24'hD0CABC;
        mem[1119] = 24'hCDC7B9;
        mem[1120] = 24'hCDC4BB;
        mem[1121] = 24'hD2C9C0;
        mem[1122] = 24'hD0C8BD;
        mem[1123] = 24'hCDC5BA;
        mem[1124] = 24'hD0C8BB;
        mem[1125] = 24'hCFC7BA;
        mem[1126] = 24'hCBC3B6;
        mem[1127] = 24'hCAC2B5;
        mem[1128] = 24'hC5BDB2;
        mem[1129] = 24'hC4BCB1;
        mem[1130] = 24'hC7BDB4;
        mem[1131] = 24'hCAC0B7;
        mem[1132] = 24'hCDC3B9;
        mem[1133] = 24'hCDC3B9;
        mem[1134] = 24'hCCC2B6;
        mem[1135] = 24'hCCC2B6;
        mem[1136] = 24'hD0C8BD;
        mem[1137] = 24'hCFC8BE;
        mem[1138] = 24'hCFC6BD;
        mem[1139] = 24'hCFC6BD;
        mem[1140] = 24'hCFC7BC;
        mem[1141] = 24'hCFC7BC;
        mem[1142] = 24'hCFC7BC;
        mem[1143] = 24'hCFC7BC;
        mem[1144] = 24'hCEC6BB;
        mem[1145] = 24'hCEC6BB;
        mem[1146] = 24'hCEC6B9;
        mem[1147] = 24'hCEC6B9;
        mem[1148] = 24'hCFC7BA;
        mem[1149] = 24'hCFC7BA;
        mem[1150] = 24'hCDC7B9;
        mem[1151] = 24'hCDC7B9;
        mem[1152] = 24'hCAC2BF;
        mem[1153] = 24'hC5BEB8;
        mem[1154] = 24'hC1BAB2;
        mem[1155] = 24'hC1BAB0;
        mem[1156] = 24'hC3BBB0;
        mem[1157] = 24'hC1B9AC;
        mem[1158] = 24'hBFB5A9;
        mem[1159] = 24'hBDB3A7;
        mem[1160] = 24'hBCB2A6;
        mem[1161] = 24'hBCB2A6;
        mem[1162] = 24'hBBB1A7;
        mem[1163] = 24'hBBB1A7;
        mem[1164] = 24'hBCB2A8;
        mem[1165] = 24'hBEB4AA;
        mem[1166] = 24'hC1B7AB;
        mem[1167] = 24'hC2B8AC;
        mem[1168] = 24'hBEB6A9;
        mem[1169] = 24'hBFB7AA;
        mem[1170] = 24'hC8BEB2;
        mem[1171] = 24'hC1B7AB;
        mem[1172] = 24'hC3B9AF;
        mem[1173] = 24'hC6BCB2;
        mem[1174] = 24'hC7BDB3;
        mem[1175] = 24'hC1B7AD;
        mem[1176] = 24'hC4BAB0;
        mem[1177] = 24'h867C72;
        mem[1178] = 24'hAEA69B;
        mem[1179] = 24'hBDB5AA;
        mem[1180] = 24'hBAB2A7;
        mem[1181] = 24'hB9B1A6;
        mem[1182] = 24'hC0BAAC;
        mem[1183] = 24'hCDC7B9;
        mem[1184] = 24'hD2C9C0;
        mem[1185] = 24'hD5CCC3;
        mem[1186] = 24'hD2CABF;
        mem[1187] = 24'hCEC6BB;
        mem[1188] = 24'hCEC6B9;
        mem[1189] = 24'hCCC4B7;
        mem[1190] = 24'hC8C0B3;
        mem[1191] = 24'hC7BFB2;
        mem[1192] = 24'hC8C0B5;
        mem[1193] = 24'hC7BFB4;
        mem[1194] = 24'hC7BEB5;
        mem[1195] = 24'hC8BFB6;
        mem[1196] = 24'hCAC2B7;
        mem[1197] = 24'hCCC4B9;
        mem[1198] = 24'hCFC7BA;
        mem[1199] = 24'hD2CABD;
        mem[1200] = 24'hCFC7BC;
        mem[1201] = 24'hCFC7BC;
        mem[1202] = 24'hCFC7BC;
        mem[1203] = 24'hCFC7BC;
        mem[1204] = 24'hCFC7BC;
        mem[1205] = 24'hCFC7BC;
        mem[1206] = 24'hCFC7BC;
        mem[1207] = 24'hCFC7BC;
        mem[1208] = 24'hCFC7BC;
        mem[1209] = 24'hCFC7BC;
        mem[1210] = 24'hCFC7BC;
        mem[1211] = 24'hCFC7BC;
        mem[1212] = 24'hCFC7BC;
        mem[1213] = 24'hCEC6BB;
        mem[1214] = 24'hCDC5BA;
        mem[1215] = 24'hCCC4B9;
        mem[1216] = 24'hCAC2BF;
        mem[1217] = 24'hC4BDB7;
        mem[1218] = 24'hC0B9B3;
        mem[1219] = 24'hBFB8AE;
        mem[1220] = 24'hC1B8AF;
        mem[1221] = 24'hC0B8AD;
        mem[1222] = 24'hC0B6AA;
        mem[1223] = 24'hBFB5A9;
        mem[1224] = 24'hBBB1A5;
        mem[1225] = 24'hBCB2A6;
        mem[1226] = 24'hBDB3A9;
        mem[1227] = 24'hBDB3A9;
        mem[1228] = 24'hBDB3A9;
        mem[1229] = 24'hBEB4AA;
        mem[1230] = 24'hBEB4A8;
        mem[1231] = 24'hBFB5A9;
        mem[1232] = 24'hC1B9AC;
        mem[1233] = 24'hBDB5A8;
        mem[1234] = 24'hC1B7AB;
        mem[1235] = 24'hC2B8AC;
        mem[1236] = 24'hC1B7AD;
        mem[1237] = 24'hC5BBB1;
        mem[1238] = 24'hC4BAB0;
        mem[1239] = 24'hBCB2A8;
        mem[1240] = 24'hB6ACA2;
        mem[1241] = 24'hC5BBB1;
        mem[1242] = 24'hC1B9AE;
        mem[1243] = 24'hC7BFB4;
        mem[1244] = 24'hC7BFB4;
        mem[1245] = 24'hC6BEB3;
        mem[1246] = 24'hD3CDBF;
        mem[1247] = 24'hCCC6BA;
        mem[1248] = 24'hCCC3BA;
        mem[1249] = 24'hC8BFB6;
        mem[1250] = 24'hBDB5AA;
        mem[1251] = 24'hB2AA9F;
        mem[1252] = 24'hAFA79A;
        mem[1253] = 24'hB0A89B;
        mem[1254] = 24'hB2AA9D;
        mem[1255] = 24'hB5ADA0;
        mem[1256] = 24'hC0B8AD;
        mem[1257] = 24'hC3BBB0;
        mem[1258] = 24'hC9C0B7;
        mem[1259] = 24'hCEC5BC;
        mem[1260] = 24'hD0C8BD;
        mem[1261] = 24'hD1C9BE;
        mem[1262] = 24'hD1C9BC;
        mem[1263] = 24'hD1C9BC;
        mem[1264] = 24'hCEC6BB;
        mem[1265] = 24'hCEC6BB;
        mem[1266] = 24'hCFC7BC;
        mem[1267] = 24'hD0C8BD;
        mem[1268] = 24'hD1C9BE;
        mem[1269] = 24'hD0C8BD;
        mem[1270] = 24'hCEC6BB;
        mem[1271] = 24'hCDC5BA;
        mem[1272] = 24'hD0C8BD;
        mem[1273] = 24'hCFC7BC;
        mem[1274] = 24'hCDC5BA;
        mem[1275] = 24'hCCC4B9;
        mem[1276] = 24'hCDC5BA;
        mem[1277] = 24'hCEC6BB;
        mem[1278] = 24'hCFC7BC;
        mem[1279] = 24'hD0C8BD;
        mem[1280] = 24'hC7BFBC;
        mem[1281] = 24'hC3BCB6;
        mem[1282] = 24'hC0B9B3;
        mem[1283] = 24'hC0B9AF;
        mem[1284] = 24'hC1B8AF;
        mem[1285] = 24'hBEB6AB;
        mem[1286] = 24'hBCB2A6;
        mem[1287] = 24'hBCB2A6;
        mem[1288] = 24'hBCB2A6;
        mem[1289] = 24'hBCB2A6;
        mem[1290] = 24'hBBB1A7;
        mem[1291] = 24'hBAB0A6;
        mem[1292] = 24'hBBB1A5;
        mem[1293] = 24'hBDB3A7;
        mem[1294] = 24'hC0B6AA;
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
